jeottesen/e3d-big-box-manual-rebuild/README.md

# E3D BigBox manual

A copy of the build manual for the E3D BigBox 3D printer, recovered from the Internet Archive's Wayback Machine after the original wiki (wiki.e3d-online.com) went offline.

- **Start here:** the [BigBox Build Manual](manual/BigBox_Build_Manual.md), the manual's first page. Every page is listed in [manual/README.md](manual/README.md).
- Each page is the latest good archived version of the original wiki page. Pages the archive never saved were reconstructed from older versions of the pages that contained them.
- Some images survive only as low-resolution thumbnails, and some are lost.
- Content is by E3D Online and used under CC BY 3.0. See [NOTICE.md](NOTICE.md).

## What's here

- `manual/` – the manual as Markdown, browsable on GitHub: start at [manual/README.md](manual/README.md)
- `docs/` – the manual as HTML (open `docs/index.html` locally)
- `scripts/` – how it was recovered and built; see [scripts/README.md](scripts/README.md)
- `notes/` – what the archive doesn't have, and which snapshot each page and image came from
