jeottesen/e3d-big-box-manual-rebuild/data/README.md

# Reviewed sheet data

One JSON file per sheet of the BigBox exploded drawings: the parts list a person has checked. **This is the source of truth** for the Printed Parts and Fixings lists on the Bill of Materials page. The build (`scripts/build.py`) reads these files and nothing the tools propose.

The extraction tools (`scripts/drawings.py`, `scripts/drawing_images.py`, `scripts/match_sheets.py`; `mise run propose`) never write here. They write proposals to `work/proposed/` (git-ignored). `scripts/drift.py` (`mise run drift`) compares the proposals with these files and prints every difference. A change is accepted on purpose, with `python3 -I scripts/drift.py --accept ID [--confirm NAME]`. Accepting merges the proposal into the sheet and never throws away what a person added (a row's `how`, `read_as`, `approx` and `basis`, and the rows entered by hand); `confirmed` is cleared when a row changes.

## Files

- `sheets/pdf-NN.json` – page NN of `docs/files/EXPLODED_DRAWINGS.pdf`, read from the PDF's text (exact).
- `sheets/img-NAME.json` – a sheet that exists only as an image on the wiki (not in the PDF), read by OCR and checked by a person.
- `bom.ods` – E3D's own Bill of Materials spreadsheet (from `bom.zip` on the BigBox Thingiverse page, CC BY-SA 3.0, see `NOTICE.md`). Its Fixings sheet is the list of the fixings kit, by bag, with the quantity required and supplied; `scripts/bom_ods.py` reads it and the build merges it with the fixings the drawings show. It is not a sheet and nothing reads it but the build.

## Fields

| Field | Meaning |
| --- | --- |
| `id` | The file name without `.json`. |
| `title` | The sheet's title. |
| `source` | Where the rows came from. `kind` is `pdf` (with `file`, `sha256` of the PDF, and `page`) or `image` (with `file`, `sha256` of the original image, and `image_sheet` as `[n, of]` in the wiki's newer revision). |
| `images` | The drawing images that show this sheet, each with a `role`: `wiki` (as the wiki has it), `redrawn` (low resolution, replaced by a drawing of the PDF sheet), `enlarged` (low resolution, no PDF sheet, made twice the size), `lost` (the wiki's image was not archived; drawn from the PDF sheet), or `drawn` (the wiki never showed this sheet as an image; drawn from the PDF sheet so the Exploded Drawings page has it). |
| `rows` | The parts list. Each row has `item`, `qty` (a whole number), `part`, `description` (the bag or box, or `Printed Part`), and `how`. |
| `confirmed` | `null`, or `{"by", "on"}`: a person has checked the sheet against the drawing. Rows read by OCR are not used by the build until the sheet is confirmed. |
| `notes` | Free text. |

`how` says how a row got its text: `pdf-text` (exact), `ocr` (as the OCR read it), `ocr+fix` (corrected by a rule; these never change a number), `hand` (corrected by a person), or `entered` (typed by a person where the drawing has no parts list, with a `basis` saying what it rests on). A corrected row keeps `read_as`, what the tool read, and an OCR row keeps its `confidence`. `"approx": true` marks a quantity the manual gives as approximate; the page shows it as `~150`. A sheet made only of entered rows is not the tools' to propose, so `drift.py` does not report it as missing.

## Build sections

The build section a part links to is not stored here. It comes from where the manual shows the sheet's drawing (`embedded_sections` in `scripts/sections.py`), because the manual is the source of truth for which step a drawing belongs to.

## Printed parts the manual names that no drawing covers

These are not stored here. The manual itself names printed parts in its step lists, such as `2 x Drive Supports (Printed Parts).` `scripts/manual_parts.py` finds them in the manual at build time. The ones a drawing also shows are matched, by name, to the row of the drawing in `MANUAL_PART_NAMES` in `scripts/targets.py`; the Bill of Materials shows the drawing's name for those, with the quantity the manual's step uses. Every other one is added to the Printed Parts table, marked `no drawing` and linked to the step that lists it (a part listed in two steps is one row that links both). A test fails if the manual has such an item the tool cannot read, or if a name in the table is no longer in the manual. The tool can only find items written in the manual's list format, with `(Printed Part…)` after the name.
