jeottesen/e3d-big-box-manual-rebuild/notes/MISSING.md

# What the Wayback Machine does not have

## Pages with no archived copy of their own

Their text was rebuilt from older versions of the pages that used to contain them (or, where noted, found under a later URL).

- Dual_X-Carriage: rebuilt from BigBox_Parts_Preparation 20160807071206 (18 lines)
- Non-Titan_Idler_Arms: rebuilt from BigBox_Parts_Preparation 20160807071206 (9 lines)
- Single_&_Dual_Direct-Drive_IR_Sensor_Bracket: rebuilt from BigBox_Parts_Preparation 20160807071206 (6 lines)
- Single_Direct-Drive_Extruder: found as a real page under a later URL form (capture 20191220164342)
- Single_Direct-Drive_X-Carriage: rebuilt from Printer_main_assemblies:_Step_By_Step_Assembly_Process 20160729070751 (23 lines)
- Dual_Direct-Drive_X-Carriage: rebuilt from Printer_main_assemblies:_Step_By_Step_Assembly_Process 20160729070751 (30 lines)
- Mesh_Levelling_the_Non-Hybrid_Dual: rebuilt from Printer_Commissioning 20160811132429 (29 lines)
- Non-Hybrid_Dual_Calibrating_Z_Offset: rebuilt from Printer_Commissioning 20160811132429 (47 lines)

## Pages with no captures under either wiki URL form

- Non-Titan_Idler_Arms
- Dual_X-Carriage
- Single_&_Dual_Direct-Drive_IR_Sensor_Bracket
- Single_Direct-Drive_X-Carriage
- Dual_Direct-Drive_X-Carriage
- Non-Hybrid_Dual_Calibrating_Z_Offset
- Mesh_Levelling_the_Non-Hybrid_Dual

## Pages left out because no capture is a real article

Stub pages such as "Coming Soon!".

- BigBox_Troubleshooting

## Images with no archived copy (206 files)

The manual shows a placeholder with the original file name for each.

- 1.1_Filament_idler_assembled.jpg (seen in: BigBox_Parts_Preparation)
- Arduino_include_library.png (seen in: BigBox_Firmware_Flashing_Guide)
- Assembled_print_fan.jpeg (seen in: BigBox_Parts_Preparation, Print_Cooling_Fan)
- Bedlevelling_home.jpg (seen in: Printer_Commissioning)
- Bedlevelling_last.jpg (seen in: Printer_Commissioning)
- Bedlevelling_lcd_adj.jpg (seen in: Printer_Commissioning)
- Bedlevelling_next.jpg (seen in: Printer_Commissioning)
- Bedlevelling_next_adj.jpg (seen in: Printer_Commissioning)
- Bedlevelling_paper.jpg (seen in: Printer_Commissioning)
- Bedlevelling_paper_next.jpg (seen in: Printer_Commissioning)
- Bedlevelling_start.jpg (seen in: Printer_Commissioning)
- Bedlevelling_store.jpg (seen in: Printer_Commissioning)
- Benchy_finished.jpg (seen in: Your_First_Print)
- Bigbox_reboot.jpg (seen in: BigBox_OctoPrint_Upgrade)
- Bigbox_reload.jpg (seen in: BigBox_OctoPrint_Upgrade)
- Bigbox_update.jpg (seen in: BigBox_OctoPrint_Upgrade)
- Both_v6_pushed_in.jpg (seen in: Dual_Direct-Drive_Printhead_Assembly)
- Braided.jpg (seen in: Single_Direct-Drive_Printhead_Assembly)
- Braided_tie.jpg (seen in: Single_Direct-Drive_Printhead_Assembly)
- Braided_tied.jpg (seen in: Single_Direct-Drive_Printhead_Assembly)
- Braided_ties.jpg (seen in: Single_Direct-Drive_Printhead_Assembly)
- Browser.jpg (seen in: BigBox_OctoPrint_Upgrade)
- Cable_loop.jpg (seen in: Single_Direct-Drive_Printhead_Assembly)
- Display_autohomed_dual.jpg (seen in: Printer_Commissioning)
- Display_disable.jpg (seen in: Printer_Commissioning)
- Drop_dual_bed.jpg (seen in: Printer_Commissioning)
- Drop_dual_bed_belt.jpg (seen in: Printer_Commissioning)
- Dual_bed_up.jpg (seen in: Printer_Commissioning)
- Dual_boot.jpg (seen in: Dual_Extruders, Printer_Commissioning)
- Dual_cable_bunch_r.jpg (seen in: Dual_Direct-Drive_Printhead_Assembly)
- Dual_cable_bunch_r_shrink.jpg (seen in: Dual_Direct-Drive_Printhead_Assembly)
- Dual_cable_bunch_r_sleeve.jpg (seen in: Dual_Direct-Drive_Printhead_Assembly)
- Dual_cable_bunch_r_tape.jpg (seen in: Dual_Direct-Drive_Printhead_Assembly)
- Dual_cable_bunch_r_tied.jpg (seen in: Dual_Direct-Drive_Printhead_Assembly)
- Dual_cable_bunches.jpg (seen in: Dual_Direct-Drive_Printhead_Assembly)
- Dual_extru_fan.jpg (seen in: Dual_Direct-Drive_Printhead_Assembly)
- Dual_extru_fan_thread.jpg (seen in: Dual_Direct-Drive_Printhead_Assembly, Single_Direct-Drive_Printhead_Assembly)
- Dual_extru_fans.jpg (seen in: Dual_Direct-Drive_Printhead_Assembly)
- Dual_extru_fit.jpg (seen in: Dual_Direct-Drive_Printhead_Assembly)
- Dual_head_ir_scrwe.jpg (seen in: Dual_Extruders, Printer_Commissioning)
- Dual_head_move.jpg (seen in: Dual_Extruders, Printer_Commissioning)
- Dual_head_move_ir.jpg (seen in: Dual_Extruders, Printer_Commissioning)
- Dual_ir_cable.jpg (seen in: Dual_Direct-Drive_Printhead_Assembly)
- Dual_ir_cable_plugged.jpg (seen in: Dual_Direct-Drive_Printhead_Assembly)
- Dual_motor_cable.jpg (seen in: Dual_Direct-Drive_Printhead_Assembly)
- Dual_motor_cable_tie.jpg (seen in: Dual_Direct-Drive_Printhead_Assembly)
- Dual_motor_endstop.jpg (seen in: Dual_Direct-Drive_Printhead_Assembly)
- Dual_motor_endstop_bend.jpg (seen in: Dual_Direct-Drive_Printhead_Assembly)
- Dual_motor_endstop_fit.jpg (seen in: Dual_Direct-Drive_Printhead_Assembly)
- Dual_motor_endstop_screws.jpg (seen in: Dual_Direct-Drive_Printhead_Assembly)
- Dual_move_1mm.jpg (seen in: Printer_Commissioning)
- Dual_move_axis.jpg (seen in: Printer_Commissioning)
- Dual_move_z.jpg (seen in: Printer_Commissioning)
- Dual_other_motor_cable_tie.jpg (seen in: Dual_Direct-Drive_Printhead_Assembly)
- Dual_powered.jpg (seen in: Dual_Extruders, Printer_Commissioning)
- Dual_spine_cable_adjust.jpg (seen in: Dual_Direct-Drive_Printhead_Assembly)
- Dual_spine_cable_hole.jpg (seen in: Dual_Direct-Drive_Printhead_Assembly)
- Dual_spine_cable_tied_done.jpg (seen in: Dual_Direct-Drive_Printhead_Assembly)
- Dual_spine_feed_ptfe.jpg (seen in: Dual_Direct-Drive_Printhead_Assembly)
- Dual_spine_feed_ptfes.jpg (seen in: Dual_Direct-Drive_Printhead_Assembly)
- Dual_spine_ptfe.jpg (seen in: Dual_Direct-Drive_Printhead_Assembly)
- Dual_spine_ptfe_cut.jpg (seen in: Dual_Direct-Drive_Printhead_Assembly)
- Dual_spine_ptfe_measure.jpg (seen in: Dual_Direct-Drive_Printhead_Assembly)
- Dual_spine_ream.jpg (seen in: Dual_Direct-Drive_Printhead_Assembly)
- Dual_spine_ring.jpg (seen in: Dual_Direct-Drive_Printhead_Assembly)
- Dual_spine_y_motor.jpg (seen in: Dual_Direct-Drive_Printhead_Assembly)
- Dual_x_carriage_0.jpg (seen in: BigBox_Parts_Preparation)
- Dual_x_carriage_0_fitted.jpg (seen in: BigBox_Parts_Preparation)
- Dual_x_carriage_completed.jpg (seen in: BigBox_Parts_Preparation)
- Dual_x_carriage_corners.jpg (seen in: BigBox_Parts_Preparation)
- Dual_x_carriage_grubs.jpg (seen in: BigBox_Parts_Preparation)
- Dual_x_carriage_hotend.jpg (seen in: BigBox_Parts_Preparation)
- EXTRUDER_IDLER.jpg (seen in: BigBox_Parts_Preparation)
- Endstop.jpg (seen in: Single_Direct-Drive_Printhead_Assembly)
- Endstop_bend_black.jpg (seen in: Single_Direct-Drive_Printhead_Assembly)
- Endstop_bend_yellow.jpg (seen in: Single_Direct-Drive_Printhead_Assembly)
- Endstop_cut.jpg (seen in: Single_Direct-Drive_Printhead_Assembly)
- Endstop_fitted.jpg (seen in: Single_Direct-Drive_Printhead_Assembly)
- Extruder_cable.jpg (seen in: Single_Direct-Drive_Printhead_Assembly)
- Fan_cable.jpg (seen in: Single_Direct-Drive_Printhead_Assembly)
- Filament_idler_assembled.jpg (seen in: BigBox_Parts_Preparation)
- Fit_v6.jpg (seen in: Dual_Direct-Drive_Printhead_Assembly)
- Fitted_v6.jpg (seen in: Dual_Direct-Drive_Printhead_Assembly)
- Grub_v6_back.jpg (seen in: Dual_Direct-Drive_Printhead_Assembly)
- Grub_v6_front.jpg (seen in: Dual_Direct-Drive_Printhead_Assembly)
- Grub_v6_match.jpg (seen in: Dual_Direct-Drive_Printhead_Assembly)
- HexUploader_file_selection.png (seen in: BigBox_Firmware_Flashing_Guide)
- HexUploader_finished.png (seen in: BigBox_Firmware_Flashing_Guide)
- HexUploader_setup.png (seen in: BigBox_Firmware_Flashing_Guide)
- HexUploader_writing.png (seen in: BigBox_Firmware_Flashing_Guide)
- Hotend_fan_on.jpg (seen in: Single_Direct-Drive_Printhead_Assembly)
- Hotend_heater.jpg (seen in: Single_Direct-Drive_Printhead_Assembly)
- Hotend_heater_bent.jpg (seen in: Single_Direct-Drive_Printhead_Assembly)
- Hotend_heater_grouped.jpg (seen in: Single_Direct-Drive_Printhead_Assembly)
- Hotend_heater_tied.jpg (seen in: Single_Direct-Drive_Printhead_Assembly)
- Hotend_insert.jpg (seen in: Single_Direct-Drive_Printhead_Assembly)
- Hotend_inserted.jpg (seen in: Single_Direct-Drive_Printhead_Assembly)
- Hotend_m4.jpg (seen in: Single_Direct-Drive_Printhead_Assembly)
- Hotend_pt100.jpg (seen in: Single_Direct-Drive_Printhead_Assembly)
- Hotend_tied.jpg (seen in: Single_Direct-Drive_Printhead_Assembly)
- Hotend_ties.jpg (seen in: Single_Direct-Drive_Printhead_Assembly)
- Hotend_wiring.jpg (seen in: Dual_Direct-Drive_Printhead_Assembly)
- Hotends_fan_on.jpg (seen in: Dual_Direct-Drive_Printhead_Assembly)
- IR_SENSOR_ASSEMBLY.jpg (seen in: BigBox_Parts_Preparation)
- IR_sensor_cable.jpg (seen in: Single_Direct-Drive_Printhead_Assembly)
- Insert_network.jpg (seen in: BigBox_OctoPrint_Upgrade)
- Insert_sd.jpg (seen in: BigBox_OctoPrint_Upgrade)
- Ir_cable.jpg (seen in: Single_Direct-Drive_Printhead_Assembly)
- Ir_sensor_assembled.jpg (seen in: BigBox_Parts_Preparation)
- Ir_tighten_dual.jpg (seen in: Printer_Commissioning)
- Logged_in.jpg (seen in: BigBox_OctoPrint_Upgrade)
- Move_to_centre.jpg (seen in: Printer_Commissioning)
- OctoPrint_BigBox_Firmware.png (seen in: BigBox_Firmware_Flashing_Guide)
- OctoPrint_FirmwareUpdater.png (seen in: BigBox_Firmware_Flashing_Guide)
- OctoPrint_FirmwareUpdater_configuration.png (seen in: BigBox_Firmware_Flashing_Guide)
- OctoPrint_FirmwareUpdater_flash_firmware.png (seen in: BigBox_Firmware_Flashing_Guide)
- OctoPrint_Plugin_Manager_dialog.png (seen in: BigBox_Firmware_Flashing_Guide)
- OctoPrint_install_BigBox_Firmware_plugin.png (seen in: BigBox_Firmware_Flashing_Guide)
- OctoPrint_install_FirmwareUpdater_plugin.png (seen in: BigBox_Firmware_Flashing_Guide)
- Octoprint_write.jpg (seen in: BigBox_OctoPrint_Upgrade)
- Octoprint_writing.jpg (seen in: BigBox_OctoPrint_Upgrade)
- Oictoprint_download.jpg (seen in: BigBox_OctoPrint_Upgrade)
- Oictoprint_website.jpg (seen in: BigBox_OctoPrint_Upgrade)
- PRINT-HEAD_(DUAL).jpg (seen in: Dual_Direct-Drive_Printhead_Assembly)
- PRINT-HEAD_(SINGLE).jpg (seen in: Single_Direct-Drive_Printhead_Assembly)
- PRINT_FAN_DUCT.jpg (seen in: BigBox_Parts_Preparation, Print_Cooling_Fan)
- Plugins.jpg (seen in: BigBox_OctoPrint_Upgrade)
- Plugins_by_date.jpg (seen in: BigBox_OctoPrint_Upgrade)
- Plugins_done.jpg (seen in: BigBox_OctoPrint_Upgrade)
- Plugins_eeprom.jpg (seen in: BigBox_OctoPrint_Upgrade)
- Plugins_installing.jpg (seen in: BigBox_OctoPrint_Upgrade)
- Plugins_paste.jpg (seen in: BigBox_OctoPrint_Upgrade)
- Print-Head_Assembly_1.JPG (seen in: Single_Direct-Drive_Printhead_Assembly)
- Print-Head_Assembly_2.JPG (seen in: Single_Direct-Drive_Printhead_Assembly)
- Print-Head_Assembly_3.JPG (seen in: Single_Direct-Drive_Printhead_Assembly)
- Print-Head_Assembly_4.JPG (seen in: Single_Direct-Drive_Printhead_Assembly)
- Print-Head_Assembly_5.JPG (seen in: Single_Direct-Drive_Printhead_Assembly)
- Print-Head_Assembly_6.JPG (seen in: Single_Direct-Drive_Printhead_Assembly)
- Print-Head_Assembly_7.JPG (seen in: Single_Direct-Drive_Printhead_Assembly)
- Print-Head_Assembly_8.JPG (seen in: Single_Direct-Drive_Printhead_Assembly)
- Printer_appearance.jpg (seen in: BigBox_OctoPrint_Upgrade)
- Printer_connect.jpg (seen in: BigBox_OctoPrint_Upgrade)
- Printer_control.jpg (seen in: BigBox_OctoPrint_Upgrade)
- Printer_online.jpg (seen in: BigBox_OctoPrint_Upgrade)
- Printer_profile.jpg (seen in: BigBox_OctoPrint_Upgrade)
- Printer_scripts.jpg (seen in: BigBox_OctoPrint_Upgrade)
- Printhead_ties.jpg (seen in: Single_Direct-Drive_Printhead_Assembly)
- Printing_print.jpg (seen in: BigBox_OctoPrint_Upgrade)
- Printing_temperature.jpg (seen in: BigBox_OctoPrint_Upgrade)
- Printing_terminal.jpg (seen in: BigBox_OctoPrint_Upgrade)
- Printing_timelapse.jpg (seen in: BigBox_OctoPrint_Upgrade)
- Ptfe_cut.jpg (seen in: Single_Direct-Drive_Printhead_Assembly)
- Ptfe_cut_66.jpg (seen in: Dual_Direct-Drive_Printhead_Assembly)
- Ptfe_feed.jpg (seen in: Single_Direct-Drive_Printhead_Assembly)
- Ptfe_hole.jpg (seen in: Single_Direct-Drive_Printhead_Assembly)
- Ptfe_insert.jpg (seen in: Single_Direct-Drive_Printhead_Assembly)
- Ptfe_tube_cut.jpg (seen in: Single_Direct-Drive_Printhead_Assembly)
- Push_sd.jpg (seen in: BigBox_OctoPrint_Upgrade)
- Putty_advanced.jpg (seen in: BigBox_OctoPrint_Upgrade)
- Putty_alert.jpg (seen in: BigBox_OctoPrint_Upgrade)
- Putty_config.jpg (seen in: BigBox_OctoPrint_Upgrade)
- Putty_download.jpg (seen in: BigBox_OctoPrint_Upgrade)
- Putty_expand.jpg (seen in: BigBox_OctoPrint_Upgrade)
- Putty_login.jpg (seen in: BigBox_OctoPrint_Upgrade)
- Putty_open.jpg (seen in: BigBox_OctoPrint_Upgrade)
- Putty_raspi_config.jpg (seen in: BigBox_OctoPrint_Upgrade)
- Putty_reboot.jpg (seen in: BigBox_OctoPrint_Upgrade)
- Reboot.jpg (seen in: BigBox_OctoPrint_Upgrade)
- Right_bunch.jpg (seen in: Single_Direct-Drive_Printhead_Assembly)
- Right_feed.jpg (seen in: Single_Direct-Drive_Printhead_Assembly)
- Right_heatsink.jpg (seen in: Single_Direct-Drive_Printhead_Assembly)
- Right_heatsink_both.jpg (seen in: Single_Direct-Drive_Printhead_Assembly)
- Right_taped.jpg (seen in: Single_Direct-Drive_Printhead_Assembly)
- Scrap_belt.jpg (seen in: Printer_Commissioning)
- Scrap_belt_bed.jpg (seen in: Printer_Commissioning)
- Serial_connection.jpg (seen in: BigBox_OctoPrint_Upgrade)
- Single_correct.jpg (seen in: BigBox_Parts_Preparation, Pro_&_Lite_X-Carriage)
- Single_incorrect.jpg (seen in: BigBox_Parts_Preparation, Pro_&_Lite_X-Carriage)
- Single_x_carriage.jpg (seen in: BigBox_Parts_Preparation, Pro_&_Lite_X-Carriage)
- Spine_cable_hole.jpg (seen in: Single_Direct-Drive_Printhead_Assembly)
- Spine_cable_slack.jpg (seen in: Single_Direct-Drive_Printhead_Assembly)
- Spine_cable_strut.jpg (seen in: Single_Direct-Drive_Printhead_Assembly)
- Spine_cable_tied.jpg (seen in: Single_Direct-Drive_Printhead_Assembly)
- Spine_cable_ties.jpg (seen in: Single_Direct-Drive_Printhead_Assembly)
- Spine_cable_tight.jpg (seen in: Single_Direct-Drive_Printhead_Assembly)
- Spine_ties.jpg (seen in: Single_Direct-Drive_Printhead_Assembly)
- Tied_cable.jpg (seen in: Single_Direct-Drive_Printhead_Assembly)
- Twist_tr8.jpg (seen in: Printer_Commissioning)
- Two_v6.jpg (seen in: Dual_Direct-Drive_Printhead_Assembly)
- Undo_screws.jpg (seen in: Printer_Commissioning)
- V6_cables.jpg (seen in: Dual_Direct-Drive_Printhead_Assembly)
- V6_wires.jpg (seen in: Dual_Direct-Drive_Printhead_Assembly)
- V6_wires_cable.jpg (seen in: Dual_Direct-Drive_Printhead_Assembly)
- V6_wires_up.jpg (seen in: Dual_Direct-Drive_Printhead_Assembly)
- Windows_Device_Manager_connected_RUMBA.png (seen in: BigBox_Firmware_Flashing_Guide)
- Windows_RUMBA_Drivers_extracted.png (seen in: BigBox_Firmware_Flashing_Guide)
- Windows_RUMBA_Drivers_installation_1.png (seen in: BigBox_Firmware_Flashing_Guide)
- Windows_RUMBA_Drivers_installation_2.png (seen in: BigBox_Firmware_Flashing_Guide)
- Windows_XLoader.png (seen in: BigBox_Firmware_Flashing_Guide)
- Windows_XLoader_finished.png (seen in: BigBox_Firmware_Flashing_Guide)
- Windows_XLoader_setup.png (seen in: BigBox_Firmware_Flashing_Guide)
- Windows_XLoader_uploading.png (seen in: BigBox_Firmware_Flashing_Guide)
- X-CARRIAGE_DUAL.JPG (seen in: BigBox_Parts_Preparation)
- X-CARRIAGE_SINGLE.jpg (seen in: BigBox_Parts_Preparation, Pro_&_Lite_X-Carriage)
- Y_motor_cable.jpg (seen in: Single_Direct-Drive_Printhead_Assembly)
- Y_motor_cable_fit.jpg (seen in: Single_Direct-Drive_Printhead_Assembly)

## Image totals

- 901 distinct images: 206 missing, 22 original, 673 thumb
