jeottesen/e3d-big-box-manual-rebuild/notes/external-links.md

# External links

Every external link in the manual, with the result of testing it. Generated by `scripts/check_links.py`; a link marked dead is labelled "(dead link)" in the manual.

3 blocked, 23 dead, 78 ok, 15 unknown, 18 untested (137 links).

| Status | Link | Text | Pages |
| --- | --- | --- | --- |
| dead | `https://dl.dropboxusercontent.com/u/54348751/BigBoxSingle-alpha-settings.fff` | `https://dl.dropboxusercontent.com/u/54348751/BigBoxSingle-alpha-settin` | Older Version Content |
| dead | `https://dl.dropboxusercontent.com/u/54348751/BigBox_Fixings.pdf` | `https://dl.dropboxusercontent.com/u/54348751/BigBox_Fixings.pdf` | Bill Of Materials |
| dead | `https://dl.dropboxusercontent.com/u/54348751/BigBox_Slic3r_config_bundle.ini` | BigBox_Slic3r_config_bundle.ini | Older Version Content, BigBox Software |
| dead | `https://docs.google.com/document/d/1zl_MQIf-aFD4pc7TauehwL7SaKXNig-ABx_l33cSCJA/edit` | Livi's BigBox Pre-Build Guide | BigBox Build Manual |
| dead | `https://drive.google.com/file/d/0B8NaxduLlxIQSEhSdnUzV2FodGs/view?usp=sharing` | Liam's Printed Parts Check-List | BigBox Build Manual |
| dead ([archived copy](https://web.archive.org/web/20160902222958/http://e3d-online.com:80/All-Filament&filter=5,24)) | `http://e3d-online.com/All-Filament&filter=5,24` | Everyday & Premium Filament | Your First Print |
| dead ([archived copy](https://web.archive.org/web/20161105152053/http://e3d-online.com/All-Filament&filter=5,24,11)) | `http://e3d-online.com/All-Filament&filter=5,24,11` | E3D's Everyday PLA | Older Version Content |
| ok | `http://e3d-online.com/index.php?route=product/product&product_id=356` | Ceramic Screwdriver | Printer main assemblies Step By Step Assembly Process |
| ok | `https://en.wikipedia.org/wiki/Flexible_flat_cable` | FFC | Printer main assemblies Step By Step Assembly Process |
| ok | `https://en.wikipedia.org/wiki/Mains_electricity_by_country` | mains A/C power supply in your country | BigBox Printer Sub-assemblies, Printer main assemblies Step By Step Assembly Process |
| ok | `https://en.wikipedia.org/wiki/Secure_Shell` | SSH | BigBox OctoPrint Upgrade |
| ok | `https://en.wikipedia.org/wiki/Zero_insertion_force` | ZIF | Printer main assemblies Step By Step Assembly Process |
| dead ([archived copy](https://web.archive.org/web/20161102033305/http://files.e3d-online.com/BigBox/SD_Card/)) | `http://files.e3d-online.com/BigBox/SD_Card/` | `http://files.e3d-online.com/BigBox/SD_Card/` | Your First Print |
| dead ([archived copy](https://web.archive.org/web/20160531182702/http://files.e3d-online.com/BigBox/Slicer%20Configs/Simplify3D/bigbox_dual.fff)) | `http://files.e3d-online.com/BigBox/Slicer%20Configs/Simplify3D/bigbox_dual.fff` | Dual.fff | Older Version Content |
| dead ([archived copy](https://web.archive.org/web/20160831005324/http://files.e3d-online.com/BigBox/Slicer%20Configs/Simplify3D/bigbox_dual_experimental.fff)) | `http://files.e3d-online.com/BigBox/Slicer%20Configs/Simplify3D/bigbox_dual_experimental.fff` | Dual Experimental.fff | Older Version Content |
| dead ([archived copy](https://web.archive.org/web/20160831005447/http://files.e3d-online.com/BigBox/Slicer%20Configs/Simplify3D/bigbox_pro.fff)) | `http://files.e3d-online.com/BigBox/Slicer%20Configs/Simplify3D/bigbox_pro.fff` | Pro.fff | Older Version Content |
| dead | `http://files.e3d-online.com/Titan/ASM_EX_THUMB_SCREW.stl` | Model of Assembled Titan in STL format | Titan Assembly |
| dead ([archived copy](https://web.archive.org/web/20170910104341/http://files.e3d-online.com/Titan/ASM_EX_THUMB_SCREW.stp)) | `http://files.e3d-online.com/Titan/ASM_EX_THUMB_SCREW.stp` | Model of Assembled Titan in STP format | Titan Assembly |
| dead | `http://files.e3d-online.com/Titan/BRACKET_PRINTED.pdf` | Mounting Bracket Engineering Drawing | Titan Assembly |
| dead ([archived copy](https://web.archive.org/web/20160527143731/http://files.e3d-online.com/Titan/Titan_Assembly_Supplementary.pdf)) | `http://files.e3d-online.com/Titan/Titan%20Assembly%20Supplementary.pdf` | Supplementary Assembly Drawings / Notes | Titan Assembly |
| dead | `http://forum.bigbox-3d.com` | BigBox forum | BigBox Build Manual |
| dead ([archived copy](https://web.archive.org/web/20240324165937/https://forum.e3d-online.com/)) | `http://forum.e3d-online.com/` | forum.e3d-online.com | BigBox Pre-Build, BigBox Printer Sub-assemblies |
| dead ([archived copy](https://web.archive.org/web/20160622040336/http://forum.e3d-online.com/index.php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)) | `http://forum.e3d-online.com/index.php?forums/guides-mods-and-upgrades.26/` | BigBox Forum \| Guides, Mods, and Upgrades | BigBox Build Manual |
| dead | `http://forum.e3d-online.com/index.php?threads/how-to-attach-a-bb-dual-to-the-rumba-board.599/#post-4300` | Pro Wiring connections | Printer main assemblies Step By Step Assembly Process |
| dead | `http://forum.e3d-online.com/index.php?threads/y-axis-belts-belt-appears-to-be-fitted-upside-down.732` | forum.e3d-online.com | Printer main assemblies Step By Step Assembly Process |
| dead ([archived copy](https://web.archive.org/web/20240324165937/https://forum.e3d-online.com/)) | `https://forum.e3d-online.com` | forum.e3d-online.com | Dual Extruders, Printer Commissioning |
| dead | `https://forum.e3d-online.com/index.php?threads/shaos-bigbox-dual-build-log.685/` | Shao's BigBox Dual Build Log | BigBox Build Manual |
| dead | `https://forum.e3d-online.com/index.php?threads/using-platformio-to-flash-firmware-from-rpi.720/` | Using platformio to flash firmware from RPi | BigBox Build Manual |
| ok | `https://github.com/Alex9779` | Alex9779 | BigBox Firmware Flashing Guide |
| ok | `https://github.com/Alex9779/BigBox-Settings/blob/master/BigBoxBedAssembly.stl` | BigBoxBedAssembly.stl | Downloads |
| ok | `https://github.com/Alex9779/BigBox-Settings/blob/master/Dual%20Titan/Simplify3D/BigBox%20Dual%20Titan.fff` | BigBox Dual Titan.fff | Downloads |
| ok | `https://github.com/Alex9779/BigBox-Settings/blob/master/Dual/Simplify3D/BigBox%20Dual.fff` | BigBox Dual.fff | Downloads |
| ok | `https://github.com/Alex9779/BigBox-Settings/blob/master/Hybrid-Dual/Simplify3D/BigBox%20Hybrid-Dual%20Mirrored.fff` | BigBox Hybrid-Dual Mirrored.fff | Downloads |
| ok | `https://github.com/Alex9779/BigBox-Settings/blob/master/Hybrid-Dual/Simplify3D/BigBox%20Hybrid-Dual.fff` | BigBox Hybrid-Dual.fff | Downloads |
| ok | `https://github.com/Alex9779/BigBox-Settings/blob/master/Hybrid-Pro/Simplify3D/BigBox%20Hybrid-Pro.fff` | BigBox Hybrid-Pro.fff | Downloads |
| ok | `https://github.com/Alex9779/BigBox-Settings/blob/master/Pro/Simplify3D/BigBox%20Pro.fff` | BigBox Pro.fff | Downloads |
| ok | `https://github.com/Alex9779/BigBox-Settings/blob/master/README.md` | BigBox-Settings: README | Downloads |
| ok | `https://github.com/Alex9779/Marlin` | `https://github.com/Alex9779/Marlin` | BigBox Firmware Flashing Guide |
| ok | `https://github.com/BigBox3D` | github.com/BigBox3D | BigBox Software |
| ok | `https://github.com/BigBox3D/` | BigBox3D Github repository | BigBox Firmware Flashing Guide |
| ok | `https://github.com/BigBox3D/Firmware/blob/master/README.md` | Firmware README | Downloads |
| ok | `https://github.com/BigBox3D/Firmware/blob/master/marlin_direct_dual.hex` | marlin_direct_dual.hex | Downloads |
| ok | `https://github.com/BigBox3D/Firmware/blob/master/marlin_direct_pro.hex` | marlin_direct_pro.hex | Downloads |
| ok | `https://github.com/BigBox3D/Firmware/blob/master/marlin_hybrid_dual.hex` | marlin_hybrid_dual.hex | Downloads |
| ok | `https://github.com/BigBox3D/Firmware/blob/master/marlin_hybrid_dual_mesh.hex` | marlin_hybrid_dual_mesh.hex | Downloads |
| ok | `https://github.com/BigBox3D/Firmware/blob/master/marlin_hybrid_pro.hex` | marlin_hybrid_pro.hex | Downloads |
| ok | `https://github.com/BigBox3D/Firmware/blob/master/marlin_hybrid_pro_mesh.hex` | marlin_hybrid_pro_mesh.hex | Downloads |
| ok | `https://github.com/BigBox3D/Marlin` | BigBox Marlin source | Downloads |
| ok | `https://github.com/BigBox3D/Marlin/releases` | BigBox Firmware Releases | BigBox Firmware Flashing Guide, BigBox Software |
| ok | `https://github.com/BigBox3D/Marlin/releases/download/1.1.0-RC6/Marlin.Dual.hex` | Download firmware | BigBox Version Overview |
| ok | `https://github.com/BigBox3D/Marlin/releases/download/1.1.0-RC6/Marlin.Hybrid-Dual.hex` | Download firmware | BigBox Version Overview |
| ok | `https://github.com/BigBox3D/Marlin/releases/download/1.1.0-RC6/Marlin.Hybrid-Pro.hex` | Download firmware | BigBox Version Overview |
| ok | `https://github.com/BigBox3D/Marlin/releases/download/1.1.0-RC6/Marlin.Pro.hex` | Download firmware | BigBox Version Overview |
| ok | `https://github.com/BigBox3D/Marlin/tree/Dual` | Firmware source repository | BigBox Version Overview |
| ok | `https://github.com/BigBox3D/Marlin/tree/Hybrid-Dual` | Firmware source repository | BigBox Version Overview |
| ok | `https://github.com/BigBox3D/Marlin/tree/Hybrid-Pro` | Firmware source repository | BigBox Version Overview |
| ok | `https://github.com/BigBox3D/Marlin/tree/Pro` | Firmware source repository | BigBox Version Overview |
| ok | `https://github.com/BigBox3D/SD-Card/blob/master/3DBenchy.stl` | 3DBenchy.stl | Downloads |
| ok | `https://github.com/BigBox3D/SD-Card/blob/master/Dual/3DBenchy.gcode` | Dual/3DBenchy.gcode | Downloads |
| ok | `https://github.com/BigBox3D/SD-Card/blob/master/Dual/calibration/extruder_0.gcode` | Dual/calibration/extruder_0.gcode | Downloads |
| ok | `https://github.com/BigBox3D/SD-Card/blob/master/Dual/calibration/extruder_1.gcode` | Dual/calibration/extruder_1.gcode | Downloads |
| ok | `https://github.com/BigBox3D/SD-Card/blob/master/Pro/3DBenchy.gcode` | Pro/3DBenchy.gcode | Downloads |
| ok | `https://github.com/BigBox3D/SD-Card/blob/master/Pro/calibration/extruder_0.gcode` | Pro/calibration/extruder_0.gcode | Downloads |
| ok | `https://github.com/BigBox3D/Simplify3D` | Settings repository for Simplify3D | BigBox Software |
| ok | `https://github.com/BigBox3D/Simplify3D/blob/master/BigBox%20Dual.fff` | BigBox Dual.fff | Downloads |
| ok | `https://github.com/BigBox3D/Simplify3D/blob/master/BigBox%20Hybrid-Dual.fff` | BigBox Hybrid-Dual.fff | Downloads |
| ok | `https://github.com/BigBox3D/Simplify3D/blob/master/BigBox%20Hybrid-Pro.fff` | BigBox Hybrid-Pro.fff | Downloads |
| ok | `https://github.com/BigBox3D/Simplify3D/blob/master/BigBox%20Print%20Farm.fff` | BigBox Print Farm.fff | Downloads |
| ok | `https://github.com/BigBox3D/Simplify3D/blob/master/BigBox%20Pro.fff` | BigBox Pro.fff | Downloads |
| ok | `https://github.com/MarlinFirmware/Marlin/wiki/Manual-bed-leveling---mesh-bed-leveling` | Mesh Bed Levelling | Mesh Levelling the Non-Hybrid Dual |
| ok | `https://github.com/OctoPrint/OctoPrint-FirmwareUpdater` | `https://github.com/OctoPrint/OctoPrint-FirmwareUpdater` | BigBox Firmware Flashing Guide |
| ok | `https://github.com/OctoPrint/OctoPrint-FirmwareUpdater/archive/master.zip` | `https://github.com/OctoPrint/OctoPrint-FirmwareUpdater/archive/master.` | BigBox Firmware Flashing Guide |
| ok | `https://github.com/tohara` | tohara | BigBox Firmware Flashing Guide |
| ok | `https://github.com/tohara/OctoPrint-BigBoxFirmware` | `https://github.com/tohara/OctoPrint-BigBoxFirmware` | BigBox Firmware Flashing Guide |
| ok | `https://github.com/tohara/OctoPrint-BigBoxFirmware/archive/master.zip` | `https://github.com/tohara/OctoPrint-BigBoxFirmware/archive/master.zip` | BigBox Firmware Flashing Guide |
| ok | `http://octoprint.org/` | octoprint.org | BigBox OctoPrint Upgrade, BigBox Software |
| unknown | `http://paulkaplan.me/HexUploader/` | HexUploader | BigBox Firmware Flashing Guide |
| ok | `http://plugins.octoprint.org/plugins/autoselect/` | Autoselect | BigBox OctoPrint Upgrade |
| ok | `http://plugins.octoprint.org/plugins/displayz/` | DisplayZ | BigBox OctoPrint Upgrade |
| ok | `http://plugins.octoprint.org/plugins/stats/` | Printer Statistics | BigBox OctoPrint Upgrade |
| blocked | `https://plus.google.com/+JohnEsc/posts/9tea8wS1qoa` | John's 3D Build & Printing Tools | BigBox Build Manual |
| blocked | `https://plus.google.com/101981424292504602513/posts/AxB4jxjbyMM` | this post on google+ | BigBox Printer Sub-assemblies |
| ok | `http://reprap.org/wiki/G-code#M218:_Set_Hotend_Offset` | reprap.org | Printer Commissioning |
| ok | `http://reprap.org/wiki/Marlin` | `http://reprap.org/wiki/Marlin` | BigBox OctoPrint Upgrade |
| ok | `http://reprap.org/wiki/RUMBA#RUMBA_USB_Driver_for_Windows` | `http://reprap.org/wiki/RUMBA#RUMBA_USB_Driver_for_Windows` | BigBox Firmware Flashing Guide |
| ok | `http://reprap.org/wiki/RUMBA#USB_connection_.28Writing_in_progress.29` | here | BigBox Firmware Flashing Guide |
| unknown | `http://russemotto.com/xloader/XLoader.zip` | XLoader | BigBox Firmware Flashing Guide |
| ok | `http://slic3r.org/` | Slic3r | Older Version Content, BigBox Software |
| unknown | `http://thelittlebox.co/theshop/index.php?route=product/product&path=66_77&product_id=107` | Multimeter | Printer main assemblies Step By Step Assembly Process |
| untested | `https://web.archive.org/web/20160109071827/http://files.e3d-online.com/BigBox/EXPLODED_DRAWINGS.pdf` | EXPLODED_DRAWINGS.pdf | Downloads |
| untested | `https://web.archive.org/web/20160422181925/http://files.e3d-online.com/BigBox/Slicer%20Configs/Slic3r/BigBox_Slic3r_config_bundle.ini` | BigBox_Slic3r_config_bundle.ini | Downloads |
| untested | `https://web.archive.org/web/20160519152959/http://files.e3d-online.com/BigBox/Slicer%20Configs/Cura/BigBox_Cura_0.25.ini` | BigBox_Cura_0.25.ini | Downloads |
| untested | `https://web.archive.org/web/20160519153237/http://files.e3d-online.com/BigBox/Slicer%20Configs/Cura/BigBox_Cura_0.10.ini` | BigBox_Cura_0.10.ini | Downloads |
| untested | `https://web.archive.org/web/20160519153242/http://files.e3d-online.com/BigBox/Slicer%20Configs/Cura/BigBox_Cura_0.20.ini` | BigBox_Cura_0.20.ini | Downloads |
| untested | `https://web.archive.org/web/20160527143731/http://files.e3d-online.com/Titan/Titan_Assembly_Supplementary.pdf` | Titan_Assembly_Supplementary.pdf | Downloads, Titan Assembly |
| untested | `https://web.archive.org/web/20160531182702/http://files.e3d-online.com/BigBox/Slicer%20Configs/Simplify3D/bigbox_dual.fff` | archived copy | Older Version Content, Downloads |
| untested | `https://web.archive.org/web/20160622040336/http://forum.e3d-online.com/index.php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` | archived copy | BigBox Build Manual |
| untested | `https://web.archive.org/web/20160831005209/http://files.e3d-online.com/BigBox/Slicer%20Configs/Simplify3D/bigbox_1.1.fff` | bigbox_1.1.fff | Downloads |
| untested | `https://web.archive.org/web/20160831005324/http://files.e3d-online.com/BigBox/Slicer%20Configs/Simplify3D/bigbox_dual_experimental.fff` | archived copy | Older Version Content, Downloads |
| untested | `https://web.archive.org/web/20160831005447/http://files.e3d-online.com/BigBox/Slicer%20Configs/Simplify3D/bigbox_pro.fff` | archived copy | Older Version Content, Downloads |
| untested | `https://web.archive.org/web/20160831005610/http://files.e3d-online.com/BigBox/Slicer%20Configs/Simplify3D/bigbox_hybrid.fff` | bigbox_hybrid.fff | Downloads |
| untested | `https://web.archive.org/web/20160902222958/http://e3d-online.com:80/All-Filament&filter=5,24` | archived copy | Your First Print |
| untested | `https://web.archive.org/web/20161102033305/http://files.e3d-online.com/BigBox/SD_Card/` | archived copy | Your First Print |
| untested | `https://web.archive.org/web/20161105152053/http://e3d-online.com/All-Filament&filter=5,24,11` | archived copy | Older Version Content |
| untested | `https://web.archive.org/web/20170910104341/http://files.e3d-online.com/Titan/ASM_EX_THUMB_SCREW.stp` | ASM_EX_THUMB_SCREW.stp | Downloads, Titan Assembly |
| untested | `https://web.archive.org/web/20171114074932/http://files.e3d-online.com/Titan/ASM_EX_AERO_285.stl` | ASM_EX_AERO_285.stl | Downloads |
| untested | `https://web.archive.org/web/20240324165937/https://forum.e3d-online.com/` | archived copy | BigBox Pre-Build, BigBox Printer Sub-assemblies, Dual Extruders, Printer Commissioning |
| ok | `http://www.3dbenchy.com/` | #3DBenchy | Your First Print |
| ok | `http://www.7-zip.org/` | 7zip | BigBox OctoPrint Upgrade |
| ok | `https://www.arduino.cc/en/Main/Software` | `https://www.arduino.cc/en/Main/Software` | BigBox Firmware Flashing Guide |
| ok | `http://www.chiark.greenend.org.uk/~sgtatham/putty/download.html` | Download | BigBox OctoPrint Upgrade |
| ok | `https://www.dropbox.com/s/zlaknl7vw509144/BigBox%20Updated%20Pictures.zip?dl=0` | Livi's MLP Edition Exploded Diagrams | BigBox Build Manual |
| ok | `http://www.instructables.com/id/Picture-The-3D-Printed-Raspberry-Pi-Camera/` | Picture | BigBox Build Manual |
| ok | `http://www.linuxfoundation.org/` | Linux | BigBox OctoPrint Upgrade |
| ok | `https://www.raspberrypi.org/` | Raspberry Pi | BigBox Software |
| blocked | `https://www.raspberrypi.org/documentation/installation/installing-images/README.md` | installing images | BigBox OctoPrint Upgrade |
| ok | `https://www.simplify3d.com/` | Simplify3D | Older Version Content, BigBox Software |
| ok | `http://www.thingiverse.com/thing:1472259` | customisable spacer | Titan Assembly |
| ok | `http://www.thingiverse.com/thing:1477900` | E3D Titan Bracket | Titan Assembly |
| ok | `http://www.thingiverse.com/thing:1515488` | `http://www.thingiverse.com/thing:1515488` | BigBox Version Overview |
| ok | `http://www.thingiverse.com/thing:1521722` | `http://www.thingiverse.com/thing:1521722` | BigBox Version Overview |
| ok | `https://www.thingiverse.com/thing:1272287` | Thingiverse | BigBox Printer Sub-assemblies |
| ok | `https://www.thingiverse.com/thing:1387197` | Handled Drills (Hole Reamers) | BigBox Build Manual |
| ok | `https://www.thingiverse.com/thing:1521722` | `https://www.thingiverse.com/thing:1521722` | BigBox Build Manual |
| ok | `https://www.thingiverse.com/thing:1686515` | Dual Extruder Alignment Tool | Printer Commissioning |
| unknown | `https://www.youtube.com/watch?v=Xjmj0j0pcRM` | `https://www.youtube.com/watch?v=Xjmj0j0pcRM` | Printer main assemblies Step By Step Assembly Process |
| unknown | `https://youtu.be/0RpnXo2UQ0Y` | `https://youtu.be/0RpnXo2UQ0Y` | Printer Commissioning |
| unknown | `https://youtu.be/1v27cCMtCCI` | `https://youtu.be/1v27cCMtCCI` | Printer Commissioning |
| unknown | `https://youtu.be/2_GjLWiQV_I` | `https://youtu.be/2_GjLWiQV_I` | Printer Commissioning |
| unknown | `https://youtu.be/5X6I6plC3d8` | `https://youtu.be/5X6I6plC3d8` | Printer Commissioning |
| unknown | `https://youtu.be/8A-qU3_-mCk` | `https://youtu.be/8A-qU3_-mCk` | Printer Commissioning |
| unknown | `https://youtu.be/DBDXf6ysArk` | `https://youtu.be/DBDXf6ysArk` | Non-Hybrid Dual Calibrating Z Offset |
| unknown | `https://youtu.be/Is6ddMdZ63E` | `https://youtu.be/Is6ddMdZ63E` | Printer Commissioning |
| unknown | `https://youtu.be/PvswubV-zas` | `https://youtu.be/PvswubV-zas` | Printer Commissioning |
| unknown | `https://youtu.be/dtdeFrBScJQ` | `https://youtu.be/dtdeFrBScJQ` | Printer Commissioning |
| unknown | `https://youtu.be/hDD1arof7YM` | `https://youtu.be/hDD1arof7YM` | Printer Commissioning |
| unknown | `https://youtu.be/pwVBydX4xyA` | `https://youtu.be/pwVBydX4xyA` | Your First Print |
