jeottesen/e3d-big-box-manual-rebuild/notes/CLEAN_REPORT.md

# Version clean-up report

## BigBox_Build_Manual

- 10 versions: 0 error/truncated, 0 unchanged, 10 kept; latest good: 20200803120509

## BigBox_Firmware_Flashing_Guide

- 3 versions: 0 error/truncated, 0 unchanged, 3 kept; latest good: 20201204013533

## BigBox_OctoPrint_Upgrade

- 6 versions: 0 error/truncated, 0 unchanged, 6 kept; latest good: 20230529010658

## BigBox_Parts_Preparation

- 15 versions: 0 error/truncated, 0 unchanged, 15 kept; latest good: 20221201075921

## BigBox_Pre-Build

- 7 versions: 0 error/truncated, 0 unchanged, 7 kept; latest good: 20200127191907

## BigBox_Printer_Sub-assemblies

- 16 versions: 0 error/truncated, 0 unchanged, 16 kept; latest good: 20210415233707

## BigBox_Software

- 5 versions: 0 error/truncated, 0 unchanged, 5 kept; latest good: 20201204024242

## BigBox_Troubleshooting

- 4 versions: 4 error/truncated, 0 unchanged, 0 kept; latest good: None
  - removed (only 1 text lines): 20160120094158
  - removed (only 1 text lines): 20160303002115
  - removed (only 1 text lines): 20160402203544
  - removed (only 1 text lines): 20170122101834

## BigBox_Version_Overview

- 4 versions: 0 error/truncated, 0 unchanged, 4 kept; latest good: 20210128113613

## Bill_Of_Materials

- 5 versions: 0 error/truncated, 0 unchanged, 5 kept; latest good: 20210416002713

## Dual_Direct-Drive_Extruders

- 2 versions: 0 error/truncated, 0 unchanged, 2 kept; latest good: 20191215173602

## Dual_Extruders

- 3 versions: 0 error/truncated, 1 unchanged, 2 kept; latest good: 20161105151950
  - unchanged duplicate: 20161003072419

## Fixings_Errors_List

- 6 versions: 0 error/truncated, 3 unchanged, 3 kept; latest good: 20160601234734
  - unchanged duplicate: 20160228213925
  - unchanged duplicate: 20160331001841
  - unchanged duplicate: 20160531220510

## Print_Cooling_Fan

- 1 versions: 0 error/truncated, 0 unchanged, 1 kept; latest good: 20161025052640

## Printer_Commissioning

- 13 versions: 0 error/truncated, 0 unchanged, 13 kept; latest good: 20210415222724

## Pro_&_Lite_X-Carriage

- 1 versions: 0 error/truncated, 0 unchanged, 1 kept; latest good: 20160824110747

## Single_Direct-Drive_Extruder

- 1 versions: 0 error/truncated, 0 unchanged, 1 kept; latest good: 20191220164342

## Titan_Assembly

- 12 versions: 0 error/truncated, 0 unchanged, 12 kept; latest good: 20230509125052

## Your_First_Print

- 6 versions: 0 error/truncated, 0 unchanged, 6 kept; latest good: 20201204013802
