jeottesen/e3d-big-box-manual-rebuild/notes/printed-parts-step-files-handoff.md

# BigBox printed parts: handoff to the manual

Nov 2, 2026 · @Jeremy

## What the package is

The package is 72 printed parts, one STEP file each, named after the manual's bill of materials. It is at `/home/claude/workspace/assets/bigbox-printed-parts-package/`.

- `parts/` holds the 72 STEP files. Each is one solid in its own frame, moved so its bounding box sits on the origin and never rotated. Slicers open them directly.
- `manifest.json` and `parts.csv` have one row per file: BOM name, quantity, assembly, manual section, manual URL, printer line, source file, size, volume and SHA-256.
- `SHA256SUMS` checks the files (`sha256sum -c SHA256SUMS`). Every file was re-imported after writing and has the expected volume.
- The 10 unnamed parts (alternate designs and transit brackets) were dropped on review. The source assemblies are not included.

## What the manual should do

1. Store the STEP files in the manual's downloads area (suggested `downloads/printed-parts/`), keep the file names, and generate the links from `parts.csv` by script, as the repository's rules require. Do not hand-edit generated pages.
2. Add a STEP link to each printed row of the BOM table. Match on the `name` column of `parts.csv`; its `file` column is the path.
3. Do not store the source assemblies. Link to where they come from on the Downloads page. The owner keeps the originals and can fetch an assembly again if needed.
4. Only `X-AXIS CARRIAGE BEARING CLAMP` has two files: `__dual` and `__regular`. Parts that are the same left and right are one file; the BOM quantity says how many to print.
5. SPOOL-HOLDER OUTER (R) is generated by mirroring (L), which the original files hold once. Say so on the page.
6. Alternates: `Z-AXIS BASE BRACKET LOWER (4 hole)` and `UPPER (4 hole)` are the versions for the newer screw. List them under their standard parts.

## Gaps to settle

Two printed BOM rows have no file: **IEC Back Cover** and **Main Block**. And 19 files have no BOM row. Add rows for them, or list them as extras. Thirteen of them have no assembly set yet, so the manual agent has to place them.

| File name | Manual assembly | Note |
| --- | --- | --- |
| Bottom Camera Bracket | none set | |
| Top Camera Bracket | none set | |
| Camera Arm | none set | |
| Camera Mount | none set | |
| Fan Mount | none set | |
| FFC Conduits | none set | |
| Drag Anchor Bracket | none set | |
| Dump Bucket | none set | |
| Dual Dump Bucket | none set | |
| Ooze Wiper | none set | |
| Dual Ooze Wiper | none set | |
| Hybrid Ooze Wiper | none set | |
| Hybrid IR Sensor Bracket | none set | |
| SPINE-VERTICAL | Spine | The BOM has the other four Spine parts |
| SPOOL-HOLDER OUTER (R) | Spool-Holder Outer | The BOM lists only (L); (R) is its mirror |
| X-CARRIAGE DUAL | Extruder Dual | The manual has a page for it but no BOM row |
| Y-AXIS REAR (R) | Y-Axis Rear | The BOM lists only (L); (R) is its mirror |
| Z-AXIS BASE BRACKET LOWER (4 hole) | Z-Axis Base Brackets | Alternate for the newer screw |
| Z-AXIS BASE BRACKET UPPER (4 hole) | Z-Axis Base Brackets | Alternate for the newer screw |

## Licence and provenance

All 72 files come from the original E3D STEP files; no geometry from the third-party E3D model by ConnorM2009 (Thingiverse 5183700, CC BY-NC) is used. The project owner says that author relicensed their files on their end.

The manual repository is CC BY 3.0, and `NOTICE.md` requires new recovered content to be covered by it. The manual's Downloads page does not record where the five original STEP files came from. Please record their sources and licence there before publishing the parts.
