jeottesen/e3d-big-box-manual-rebuild/data/bom.ods

Sheet: General
 |  |  |  | Product Unit Qty
Category | Sub-Category | Location | Component | Lite | Pro | Dual
Electronics | Cabling | E3D Extruder Box | PT100 Single amp cable | 1 | 1 | 0
Electronics | Cabling | E3D Extruder Box | PT100 Double amp cable | 0 | 0 | 1
Electronics | PCB | E3D Extruder Box | PT100 Amp | 1 | 1 | 2
Electronics | Sensors | E3D Extruder Box | PT100 (1700mm Cable) | 1 | 1 | 2
Electronics | Cable | Electronics & wiring | Link | 1 | 1 | 1
Electronics | Cable | Electronics & wiring | PSU to Rumba | 2 | 2 | 2
Electronics | Cable | Electronics & wiring | IEC to PSU (Mains to PSU (300mm)) | 1 | 1 | 1
Electronics | Cable | Electronics & wiring | Bed Wiring Loom | 1 | 1 | 1
Electronics | Cabling | Electronics & wiring | IR Endstop Cable | 1 | 1 | 1
Electronics | IEC | Electronics & wiring | IEC Socket with Fuse | 1 | 1 | 1
Electronics | PCB | Electronics & wiring | Rumba | 1 | 1 | 1
Electronics | PCB | Electronics & wiring | A4988 | 4 | 4 | 5
Electronics | PSU | Electronics & wiring | PSU | 1 | 1 | 1
Electronics | Sensors | Electronics & wiring | IR Sensor | 1 | 1 | 1
Electronics | Sensors | Electronics & wiring | EndStops MicroSwitch (with Cable) | 2 | 2 | 2
Electronics | Print Related | Heated Bed | Heated Bed | 0 | 1 | 1
Electronics | Sensors | Heated Bed | Bed Thermistor Semitec | 0 | 1 | 1
Electronics | PCB | LCD & fans | LCD | 1 | 1 | 1
Electronics | Cable | Motor Box | Z-Motor Cable (300mm) | 1 | 1 | 1
Electronics | Cable | Motor Box | E-Motor Cable (1500mm) | 1 | 1 | 1
Electronics | Cable | Motor Box | Y-Motor Cable (1000mm) | 1 | 1 | 1
Electronics | Cable | Motor Box | X-Motor Cable (1500mm) | 1 | 1 | 1
Electronics | Cabling | Stretch Box | Panel Mount USB Extension | 1 | 1 | 1
Extrusion System | Extruder | E3D Extruder Box | Nitrile 70 O-Rings 12mm ID 17 OD | 0 | 0 | 2
Extrusion System | Extruder | E3D Extruder Box | E3D HobGoblin (5mm) (M3 x 4 Grub) | 1 | 1 | 2
Extrusion System | HotEnd | E3D Extruder Box | E3D V6 Lite (Direct, 24V, PT100 Block, No Electronics) | 1 | 0 | 0
Extrusion System | HotEnd | E3D Extruder Box | E3D V6 (Direct, 24V, PT100 Block, No Electronics) | 0 | 1 | 2
Extrusion System | HotEnd | E3D Extruder Box | Heater Cartridge | 1 | 1 | 2
Extrusion System | PTFE | E3D Extruder Box | Embedded Bowden Coupling for Plastic | 1 | 1 | 2
Extrusion System | PTFE | E3D Extruder Box | 4mm x 3mm x 1000mm PTFE Filament Guide | 1 | 1 | 2
Fans | Case | LCD & fans | 60x60x10 24v (300mm lead w/ 4mm fork ferrule) | 1 | 1 | 1
Fans | Electronics | LCD & fans | 50x50x10 24v (250mm lead w/ 0.1" connector) | 1 | 1 | 1
Fans | Print Related | LCD & fans | 40x40x20 Blower 24v (1700mm lead w/ 0.1" connector) | 1 | 1 | 2
Fans | Print Related | LCD & fans | 30x30x10 24v (1700mm lead w/ 0.1" connector) | 1 | 1 | 2
Fixings |  | Fixings Kit | BigBox Fixings Kit (See Fixings BOM for breakdown) | 1 | 1 | 1
Fixings |  | Stretch Box | BigBox M3 Nut Traps | 160 | 160 | 160
Frame | Sheet Material | Frame/Frame Kit | Laser Cut Acrylic / Plywood Frame
Frame | Sheet Material | Printed Parts | Laser Cut Cork Dampener Parts | 1 | 1 | 1
Miscellaneous | Extruder | E3D Extruder Box | Filament-Idler Spring | 1 | 1 | 2
Miscellaneous | Print Related | E3D Extruder Box | Viton A Rubber Strip (1.5 x 12) 40mm | 1 | 1 | 0
Miscellaneous | Print Related | E3D Extruder Box | Viton A Rubber Strip (1.5 x 12) 77mm | 0 | 0 | 1
Miscellaneous | PTFE | E3D Extruder Box | V6 Direct PTFE tubing (2mm x 4mm) | 1 | 1 | 2
Miscellaneous | Spool Holder | E3D Extruder Box | Spring (spool holder) | 1 | 1 | 2
Miscellaneous | Print Related | Heated Bed | Adhesive Sheet 3M 467MP | 1 | 1 | 1
Miscellaneous | Print Related | Heated Bed | Glass Bed | 1 | 1 | 1
Miscellaneous | Print Related | Heated Bed | Cork Insulation | 0 | 1 | 1
Miscellaneous | Cable Management | Motion Box | Drag Chain 400mm | 1 | 2 | 2
Miscellaneous | Print Related | Stretch Box | Glass Bed Clips | 8 | 8 | 8
Motion System | Bearings | E3D Extruder Box | 604-ZZ (4x12x4) | 1 | 1 | 2
Motion System | Bearings | Motion Box | F604 (4x12x4 Flange-13.5) | 6 | 6 | 6
Motion System | Bearings | Motion Box | 634ZZ (4x16x5) | 9 | 9 | 18
Motion System | Bearings | Motion Box | 688-ZZ (8x16x5) | 2 | 2 | 2
Motion System | Bearings | Motion Box | LM8LUU (8x45) | 8 | 8 | 8
Motion System | Belts & Pulleys | Motion Box | 66 Tooth (132mm) GT2 Loop Belt | 1 | 1 | 1
Motion System | Belts & Pulleys | Motion Box | GT2 6mm Belt (3000mm) | 1 | 1 | 1
Motion System | Belts & Pulleys | Motion Box | GT2 16T (5mm) | 1 | 1 | 1
Motion System | Belts & Pulleys | Motion Box | GT2 20T (5mm) | 1 | 1 | 1
Motion System | Belts & Pulleys | Motion Box | GT2 20T (8mm) | 2 | 2 | 2
Motion System | Belts & Pulleys | Motion Box | GT2 36T (8mm) | 1 | 1 | 1
Motion System | Leadscrews & Nuts | Motion Box | 5mm – 8mm Couplers | 2 | 2 | 2
Motion System | Leadscrews & Nuts | Motion Box | TR8 Nut (4 x M3 Mounting Holes) | 2 | 2 | 2
Motion System | Leadscrews & Nuts | Rods | TR8 Leadscrew (347mm) | 2 | 2 | 2
Motion System | Rods | Rods | SiS. 532mm (Y) | 1 | 1 | 1
Motion System | Rods | Rods | GHSiS 484mm (X) | 2 | 2 | 2
Motion System | Rods | Rods | GHSiS 384mm (Y) | 2 | 2 | 2
Motion System | Rods | Rods | GHSiS 364mm (Z) | 4 | 4 | 4
Motion System | Rods | Rods | SiS 325mm (S) | 2 | 2 | 4
RPI Kit | Cable | Rasberry Pi Box | Panel Mount RJ45 Socket (600mm)
RPI Kit | Cable | Rasberry Pi Box | USB A-Mini cable (~500mm)
RPI Kit | Cable | Rasberry Pi Box | Short uUSB cable
RPI Kit | Cable | Rasberry Pi Box | Rumba to DCDC Power In (300mm lead. 0.1” - Tinned)
RPI Kit | PCB | Rasberry Pi Box | Raspberry Pi 2 + 8gb
RPI Kit | PCB | Rasberry Pi Box | Camera & 750mm FFC Cable
RPI Kit | PCB | Rasberry Pi Box | 5v DC DC Converter
Stepper Motors | Stepper Motors | Motor Box | 46nm NEMA 17 (400 Steps) (Wantai 42BYGHM809L20P4.5-17-X2) | 3 | 3 | 4
Stepper Motors | Stepper Motors | Motor Box | 40nm NEMA 17 (200 Steps) (Wantai 42BYGHW609L20P1-X2) | 2 | 2 | 2

Sheet: Fixings
Bag Number | Description | Qty Required | Qty Supplied
1 | 20mm x 40mm 2:1 Heatshrink Black | 8 | 9 | Note: | A number of fixings kits contained errors. In the case of errors, a supplimentary bag of fixings was supplied in the "stretch box" or within the fixings kit. For more information, please see: http://wiki.e3d-online.com/wiki/BigBox_Fixings_Errors_List.
1 | 2.5mm x 100mm Cable Tie | 26 | 29
1 | 20mm ID x1500mm Braided Cable Sleeve | 2 | 3
1 | 20mm ID x 800mm Braided Cable Sleeve | 2 | 3
1 | 3.1mm OD x ~5mm OD x 5mm Nylon Standoff | 18 | 20
1 | 3.1mm OD x ~8mm OD x 5mm Nylon Standoff | 4 | 5
1 | M3 x 18-20 Standoff | 4 | 5
2 | M3 x 8 Countersunk Rec Platite 30 Screws BZP | 6 | 7
2 | M2 Microbarb Nuts Brass | 4 | 5
3 | M2 A2 S/S Half Nuts | 4 | 5
3 | M2 x 12 Socket Cap Screws | 8 | 9
4 | M2 x 8 Socket Cap Screws | 2 | 3
4 | M2.5 MicroBarb | 4 | 5
4 | M2.5 Square Nut | 2 | 3
4 | M2.5 x 12 Socket Cap Screws | 4 | 5
5 | M2.5 x 6 Socket Cap Screws | 2 | 3
5 | M3 Hex Nut Half | 107 | 118
5 | M3 Microbarb Nuts Brass | 29 | 32
6 | M3 Ext Lock Washer A2 S/S | 77 | 85
6 | M3 Square Nuts A2 S/S | 207 | 228
7 | M3 Washers A BZP | 10 | 11
7 | M3 x 6 Skt Cap Screws | 8 | 9
7 | M3 x 25 Skt Cap Screws | 13 | 15
8 | M3 x 10 Skt Cap Screws | 62 | 69
8 | M3 x 18 Skt Cap Screws | 156 | 172
9 | M3 x 12 Skt Cap Screws | 63 | 70
9 | M3 x 20 Skt Cap Screws | 38 | 42
10 | M3 x 30 Skt Cap Screws | 4 | 5
10 | M3 x 16 Skt Cap Screws | 26 | 29
11 | M3 x 35 Skt Cap Screws | 21 | 24
11 | M3 x 22 Skt Cap Screws | 2 | 3
11 | M4 Hex Nut Half | 24 | 27
12 | M4 Ext Lock Washer | 14 | 16
12 | M4 Square Nuts | 34 | 38
13 | M4 Washer | 35 | 39
13 | M4 x 8 Skt Grub Screws Flat Point | 6 | 7
13 | M4 x 20 Skt Grub Screws Flat Point | 2 | 3
14 | M4 x 12 Skt Grub Screws Flat Point | 6 | 7
14 | M4 x 16 Skt Cap Screws | 32 | 36
15 | M4 x 25 Skt Cap Screws | 2 | 3
15 | M3 Nylock Nut | 4 | 5
15 | M3 x 8 Skt Cap Screws | 2 | 3
16 | Nylon Washer - 8mm ID x 18mm OD x 1.6-1.8mm T | 2 | 3
16 | Nylon Spacer - 3-3.2mm ID x 6mm OD x 15 L | 2 | 3
16 | Brass Standoff - Female Female M3 x 15 Full Thread | 4 | 5
17 | M4 x 20 Skt Cap Screws | 17 | 19
17 | M4 x 30 Skt Cap Screws | 5 | 6
17 | M3 x 3 Skt Grub Screws Knruled Point | 2 | 3
