jeottesen/e3d-big-box-manual-rebuild/downloads/printed-parts/parts.csv

file | name | in_bom | bom_qty | bom_printer | bom_drawing | assembly | section | manual_url | printer_line | variant | notes | source_file | source_part | dims_mm | volume_mm3 | license | renamed_in_package | verified_reimport | sha256
parts/BB-FRAME-M3-NUT-TRAP-1.step | BB_FRAME_M3_NUT_TRAP-1 | True | ~150 |  | FRAME-LUG_DRAWING.jpg | Frame-Lug Drawing | (13.1) A Note on Nut-Traps | https://github.com/jeottesen/e3d-big-box-manual-rebuild/blob/main/manual/BigBox_Printer_Sub-assemblies.md |  |  |  | BB_FRAME_M3_NUT_TRAP.stp | BB_FRAME_M3_NUT_TRAP/g000 | 11.0 x 8.1 x 7.6 | 353 | CC BY-SA 3.0 | False | True | a371f3552f8ac2a917ddadea19b06e5629b5b404430a606cc22ba27669481897
parts/Bottom-Camera-Bracket.step | Bottom Camera Bracket | False |  |  |  |  | (22) OctoPrint Upgrade Camera Install | https://github.com/jeottesen/e3d-big-box-manual-rebuild/blob/main/manual/Printer_main_assemblies_Step_By_Step_Assembly_Process.md | regular |  |  | bigbox_v1.1.0.stp | bigbox_v1.1.0/g028 | 42.6 x 9.0 x 9.0 | 2051 | CC BY-SA 3.0 | False | True | dbbf3e4ed094f13fe13a1dc60dc9d1846357892782c8dc1c1850285f69d780bc
parts/Camera-Arm.step | Camera Arm | False |  |  |  |  | (22) OctoPrint Upgrade Camera Install | https://github.com/jeottesen/e3d-big-box-manual-rebuild/blob/main/manual/Printer_main_assemblies_Step_By_Step_Assembly_Process.md | regular |  |  | bigbox_v1.1.0.stp | bigbox_v1.1.0/g007 | 36.2 x 25.0 x 8.5 | 3796 | CC BY-SA 3.0 | False | True | a7e937fe31809a2b3223f996664214d9d326e01c359530806784a0ff91261e19
parts/Camera-Mount.step | Camera Mount | False |  |  |  |  | (22) OctoPrint Upgrade Camera Install | https://github.com/jeottesen/e3d-big-box-manual-rebuild/blob/main/manual/Printer_main_assemblies_Step_By_Step_Assembly_Process.md | regular |  | Camera holder | bigbox_v1.1.0.stp | bigbox_v1.1.0/g027 | 61.9 x 33.5 x 11.0 | 8160 | CC BY-SA 3.0 | False | True | 39664945ac8bf790c2497e8b66093dfa2228a06f49bcde90586c7850b1ce69ed
parts/DOCK-BRACKET.step | DOCK-BRACKET | True | 1 |  | DOCK-BRACKET.jpg | Dock-Bracket | (14) Frame Top | https://github.com/jeottesen/e3d-big-box-manual-rebuild/blob/main/manual/Printer_main_assemblies_Step_By_Step_Assembly_Process.md | regular |  |  | bigbox_v1.1.0.stp | bigbox_v1.1.0/g034 | 141.2 x 43.5 x 14.0 | 19729 | CC BY-SA 3.0 | False | True | 5f5137f0dd04ec7c66add2017b39a2aba59ef1b538611b3534513197886fc38b
parts/Drag-Anchor-Bracket.step | Drag Anchor Bracket | False |  |  |  |  | (13) X-Axis Drag Chain | https://github.com/jeottesen/e3d-big-box-manual-rebuild/blob/main/manual/Printer_main_assemblies_Step_By_Step_Assembly_Process.md | regular |  |  | bigbox_v1.1.0.stp | bigbox_v1.1.0/g023 | 31.5 x 26.0 x 14.5 | 6991 | CC BY-SA 3.0 | False | True | 947dbeebab309fae8eb48c7c4fb80e87a38c6f3595a41fe94af6b69c4ae5421d
parts/Drive-Supports.step | Drive Supports | True | 2 |  |  | Z-Axis Bed Assembly | (10) Z-Axis Bed Assembly | https://github.com/jeottesen/e3d-big-box-manual-rebuild/blob/main/manual/BigBox_Printer_Sub-assemblies.md | regular |  |  | bigbox_v1.1.0.stp | bigbox_v1.1.0/g045 | 50.5 x 35.0 x 23.2 | 13572 | CC BY-SA 3.0 | False | True | b04eff8009a04bc42cbcafa2ae2766605dc026c1ea27caf4543ad6b4bc90ac14
parts/Dual-Dump-Bucket.step | Dual Dump Bucket | False |  |  |  |  | (31) Ooze Wiper & Dump Bucket | https://github.com/jeottesen/e3d-big-box-manual-rebuild/blob/main/manual/Printer_main_assemblies_Step_By_Step_Assembly_Process.md | dual |  |  | bigbox_dual_v1.0.0.stp | bigbox_dual_v1.0.0/g004 | 78.0 x 60.7 x 50.0 | 44021 | CC BY-SA 3.0 | False | True | bddd191af1e741b3754af32d1ca612bfdc0dbc9b7a10ac488c5a55428565b2ce
parts/Dual-Ooze-Wiper.step | Dual Ooze Wiper | False |  |  |  |  | (31) Ooze Wiper & Dump Bucket | https://github.com/jeottesen/e3d-big-box-manual-rebuild/blob/main/manual/Printer_main_assemblies_Step_By_Step_Assembly_Process.md | dual |  |  | bigbox_dual_v1.0.0.stp | bigbox_dual_v1.0.0/g000 | 76.0 x 42.4 x 12.0 | 9398 | CC BY-SA 3.0 | False | True | aa0072d1b46ea1467dc4ce8a80fcc58375dac1575d723b6d8ed504607a173e0d
parts/Dump-Bucket.step | Dump Bucket | False |  |  |  |  | (31) Ooze Wiper & Dump Bucket | https://github.com/jeottesen/e3d-big-box-manual-rebuild/blob/main/manual/Printer_main_assemblies_Step_By_Step_Assembly_Process.md | regular |  |  | bigbox_v1.1.0.stp | bigbox_v1.1.0/g033 | 60.7 x 50.0 x 44.0 | 31589 | CC BY-SA 3.0 | False | True | 16da1b3946765bffb823473607dc17aa04a84c6bb756e7b2a1702078c62d98f8
parts/E-AXIS-CABLE-BRACKET-DUAL-L.step | E-AXIS CABLE BRACKET (DUAL)(L) | True | 1 | dual | EXTRUDER_DUAL.jpg | Extruder Dual | Dual Direct-Drive Extruders | https://github.com/jeottesen/e3d-big-box-manual-rebuild/blob/main/manual/Dual_Direct-Drive_Extruders.md | dual |  |  | bigbox_dual_v1.0.0.stp | bigbox_dual_v1.0.0/g002b | 74.3 x 59.0 x 27.6 | 17030 | CC BY-SA 3.0 | False | True | 7fc53b025d3587d7e0ea964df42112ef581ff61df140bf0ed6dd50276f0e9444
parts/E-AXIS-CABLE-BRACKET-DUAL-R.step | E-AXIS CABLE BRACKET (DUAL)(R) | True | 1 | dual | EXTRUDER_DUAL.jpg | Extruder Dual | Dual Direct-Drive Extruders | https://github.com/jeottesen/e3d-big-box-manual-rebuild/blob/main/manual/Dual_Direct-Drive_Extruders.md | dual |  | Right and left are the same part but mirrored | bigbox_dual_v1.0.0.stp | bigbox_dual_v1.0.0/g002 | 74.3 x 59.0 x 27.6 | 17030 | CC BY-SA 3.0 | False | True | 5de7dd90be17e3ba4e0c1458fca2143a3e5cbcbca9c324409187a5a81637422e
parts/E-AXIS-CARRIAGE-TOP-HYBRID-NON-TITAN-DIRECT-BODY.step | E-AXIS CARRIAGE TOP HYBRID NON-TITAN DIRECT BODY | True | 1 | hybrid | EXTRUDER_HYBRID_NON-TITAN_DIRECT.jpg | Extruder Hybrid Non-Titan Direct | (5) Hybrid Non-Titan Extruder (Direct) | https://github.com/jeottesen/e3d-big-box-manual-rebuild/blob/main/manual/BigBox_Printer_Sub-assemblies.md | hybrid |  | broken thumbnail | Hybrid_v1.1.0.stp | Hybrid_v1.1.0/g003 | 74.2 x 67.7 x 51.1 | 56237 | CC BY-SA 3.0 | False | True | 08b07b1ddc2648495b5b42c2a7db95434316f49f4b6902c7e879be0d4035746b
parts/E-AXIS-CARRIAGE-TOP-HYBRID-NON-TITAN-DIRECT-GUIDE.step | E-AXIS CARRIAGE TOP HYBRID NON-TITAN DIRECT GUIDE | True | 1 | hybrid | EXTRUDER_HYBRID_NON-TITAN_DIRECT.jpg | Extruder Hybrid Non-Titan Direct | (5) Hybrid Non-Titan Extruder (Direct) | https://github.com/jeottesen/e3d-big-box-manual-rebuild/blob/main/manual/BigBox_Printer_Sub-assemblies.md | hybrid |  |  | Hybrid_v1.1.0.stp | Hybrid_v1.1.0/g005 | 42.0 x 30.8 x 25.6 | 7390 | CC BY-SA 3.0 | False | True | 9927c90d32afa1c2d128b79118a46312f171a26134629e35b9ccb1350b42e302
parts/E-AXIS-CARRIAGE-TOP-HYBRID-NON-TITAN-DIRECT-LEVER.step | E-AXIS CARRIAGE TOP HYBRID NON-TITAN DIRECT LEVER | True | 1 | hybrid | EXTRUDER_HYBRID_NON-TITAN_DIRECT.jpg | Extruder Hybrid Non-Titan Direct | (5) Hybrid Non-Titan Extruder (Direct) | https://github.com/jeottesen/e3d-big-box-manual-rebuild/blob/main/manual/BigBox_Printer_Sub-assemblies.md | hybrid |  |  | Hybrid_v1.1.0.stp | Hybrid_v1.1.0/g004 | 46.3 x 25.0 x 24.0 | 8775 | CC BY-SA 3.0 | False | True | cd0e845d320655b49f21cbe6165300370868f3c1d3817c298cedeaf7644e64fa
parts/E-AXIS-CARRIAGE-TOP-HYBRID-TITAN-DIRECT.step | E-AXIS CARRIAGE TOP HYBRID TITAN DIRECT | True | 1 | hybrid | EXTRUDER_HYBRID_TITAN_DIRECT.jpg | Extruder Hybrid Non-Titan Direct | (5) Hybrid Non-Titan Extruder (Direct) | https://github.com/jeottesen/e3d-big-box-manual-rebuild/blob/main/manual/BigBox_Printer_Sub-assemblies.md | hybrid |  |  | Hybrid_v1.1.0.stp | Hybrid_v1.1.0/g000 | 71.3 x 68.3 x 51.5 | 40664 | CC BY-SA 3.0 | False | True | 67f6914424c858af7822c126ff2af4381b1eb09dd3d48720f7b5c80ae1c89053
parts/E-AXIS-IDLER.step | E-AXIS IDLER | True | 1 |  | EXTRUDER_IDLER.jpg | Extruder Idler | Non-Titan Idler Arms | https://github.com/jeottesen/e3d-big-box-manual-rebuild/blob/main/manual/Non-Titan_Idler_Arms.md | regular |  |  | bigbox_v1.1.0.stp | bigbox_v1.1.0/g021 | 46.3 x 25.0 x 14.0 | 7280 | CC BY-SA 3.0 | False | True | ca78dcabccbb71bbd088acd617f4382f326aa6a8dddcd35d8a57c3523fb8f4f6
parts/ELECTRONICS-COVER-BRACKET.step | ELECTRONICS-COVER-BRACKET | True | 4 |  | ELECTRONICS_COVER.jpg | Electronics Cover | (8) Electronics Cover | https://github.com/jeottesen/e3d-big-box-manual-rebuild/blob/main/manual/BigBox_Printer_Sub-assemblies.md | regular |  |  | bigbox_v1.1.0.stp | bigbox_v1.1.0/g008 | 31.2 x 18.5 x 5.0 | 1387 | CC BY-SA 3.0 | False | True | 139512ea725d00bd2d5954e0a1962b5f7141107229c0c13557dd782c58e9eb32
parts/EXTRUDER-BODY-DUAL.step | EXTRUDER BODY (DUAL) | True | 1 | dual | EXTRUDER_DUAL.jpg | Extruder Dual | Dual Direct-Drive Extruders | https://github.com/jeottesen/e3d-big-box-manual-rebuild/blob/main/manual/Dual_Direct-Drive_Extruders.md | dual |  |  | bigbox_dual_v1.0.0.stp | bigbox_dual_v1.0.0/g003 | 135.2 x 51.1 x 40.0 | 79801 | CC BY-SA 3.0 | False | True | 84b3a982c0e100420f096116aefdad7a34cb8d1791303beed16f2bd386f0a62f
parts/EXTRUDER-BODY-SINGLE.step | EXTRUDER BODY (SINGLE) | True | 1 | regular | EXTRUDER_SINGLE.jpg | Extruder Single | Single Direct-Drive Extruder | https://github.com/jeottesen/e3d-big-box-manual-rebuild/blob/main/manual/Single_Direct-Drive_Extruder.md | regular |  |  | bigbox_v1.1.0.stp | bigbox_v1.1.0/g019 | 88.3 x 51.1 x 40.0 | 46447 | CC BY-SA 3.0 | False | True | ceed1fadfe85dfc3ff29f610606ec7e26eb686b984e05aeffe6104e565bb210b
parts/EXTRUDER-CABLE-BRACKET.step | EXTRUDER CABLE BRACKET | True | 1 |  | EXTRUDER_SINGLE.jpg | Extruder Single | Single Direct-Drive Extruder | https://github.com/jeottesen/e3d-big-box-manual-rebuild/blob/main/manual/Single_Direct-Drive_Extruder.md | regular |  |  | bigbox_v1.1.0.stp | bigbox_v1.1.0/g020 | 76.0 x 74.3 x 27.6 | 19882 | CC BY-SA 3.0 | False | True | 3b7999c25ca01759b40ed0583c13256d14e84d924e7df6c9378fa681addda6e2
parts/Fan-Mount.step | Fan Mount | False |  |  |  |  | (13) Print Cooling Fan (v1.0) | https://github.com/jeottesen/e3d-big-box-manual-rebuild/blob/main/manual/BigBox_Parts_Preparation.md | hybrid |  |  | Hybrid_v1.1.0.stp | Hybrid_v1.1.0/g014 | 70.5 x 60.5 x 23.8 | 12960 | CC BY-SA 3.0 | False | True | de4886b80345ba89e4ae60ee3457bc4ae3a26cf683046347e3cc14770e7c95f1
parts/FFC-Conduits.step | FFC Conduits | False |  |  |  |  | (22) OctoPrint Upgrade Camera Install | https://github.com/jeottesen/e3d-big-box-manual-rebuild/blob/main/manual/Printer_main_assemblies_Step_By_Step_Assembly_Process.md | regular |  |  | bigbox_v1.1.0.stp | bigbox_v1.1.0/g011 | 30.0 x 24.4 x 4.1 | 1277 | CC BY-SA 3.0 | False | True | d03dd6535fe1f55e3ed8d198f668eb3da55c9d1b44df914aed0a512c068b1c17
parts/HEATED-BED-CORNERS.step | HEATED BED CORNERS | True | 1 |  | HEATED_BED_CORNERS.jpg | Heated Bed Corners | (10) Heated Bed Corners | https://github.com/jeottesen/e3d-big-box-manual-rebuild/blob/main/manual/BigBox_Parts_Preparation.md | regular |  |  | bigbox_v1.1.0.stp | bigbox_v1.1.0/g044 | 32.5 x 32.4 x 23.0 | 9970 | CC BY-SA 3.0 | False | True | 0c32160d4774fb6439e0248ec281025450921dde3b0b64856cb4cec577a66916
parts/Hybrid-IR-Sensor-Bracket.step | Hybrid IR Sensor Bracket | False |  |  |  |  | (16) Hybrid IR Sensor Bracket | https://github.com/jeottesen/e3d-big-box-manual-rebuild/blob/main/manual/BigBox_Parts_Preparation.md | hybrid |  |  | Hybrid_v1.1.0.stp | Hybrid_v1.1.0/g008 | 66.9 x 33.5 x 11.8 | 8766 | CC BY-SA 3.0 | False | True | 428cc5422cca92d97efc7adc92e64a4d3d1890e34202784e174d274abb2b0681
parts/Hybrid-Ooze-Wiper.step | Hybrid Ooze Wiper | False |  |  |  |  | (31) Ooze Wiper & Dump Bucket | https://github.com/jeottesen/e3d-big-box-manual-rebuild/blob/main/manual/Printer_main_assemblies_Step_By_Step_Assembly_Process.md | hybrid |  |  | Hybrid_v1.1.0.stp | Hybrid_v1.1.0/g009 | 77.0 x 50.4 x 20.8 | 14553 | CC BY-SA 3.0 | False | True | f176105abb3869ce6d1fd122388b0a70b142fbd25e5533a966f85270eb7fad96
parts/Hybrid-X-Carriage.step | Hybrid X-Carriage | True | 1 | hybrid |  |  | (9) Hybrid X-Carriage | https://github.com/jeottesen/e3d-big-box-manual-rebuild/blob/main/manual/BigBox_Parts_Preparation.md | hybrid |  |  | Hybrid_v1.1.0.stp | Hybrid_v1.1.0/g001 | 79.8 x 70.1 x 27.7 | 66265 | CC BY-SA 3.0 | False | True | 90786655a63f15147f613be2c981316f2e45d5aa9a89572ee4d6c300a7ae82d2
parts/Hybrid-X-Carriage-Front-Bearing-Clamp.step | Hybrid X-Carriage Front Bearing Clamp | True | 1 | hybrid |  |  | (8) Hybrid X-Carriage | https://github.com/jeottesen/e3d-big-box-manual-rebuild/blob/main/manual/Printer_main_assemblies_Step_By_Step_Assembly_Process.md | hybrid |  |  | Hybrid_v1.1.0.stp | Hybrid_v1.1.0/g002 | 45.0 x 32.0 x 12.2 | 7393 | CC BY-SA 3.0 | False | True | 2be7fffb7bcc0a848a91e272eaebcdd017b3db85587d06c6e31394879e1d69e7
parts/Hybrid-X-Carriage-Rear-Bearing-Clamp.step | Hybrid X-Carriage Rear Bearing Clamp | True | 1 | hybrid |  |  | (8) Hybrid X-Carriage | https://github.com/jeottesen/e3d-big-box-manual-rebuild/blob/main/manual/Printer_main_assemblies_Step_By_Step_Assembly_Process.md | hybrid |  |  | Hybrid_v1.1.0.stp | Hybrid_v1.1.0/g010 | 69.2 x 37.3 x 21.3 | 16794 | CC BY-SA 3.0 | False | True | 5ccba2679906e8e447c8638e493c05f689d494be4d7d165fb17b230e60371430
parts/IR-SENSOR-HOUSING.step | IR-SENSOR HOUSING | True | 1 |  | IR_SENSOR_ASSEMBLY.jpg | IR Sensor Assembly | Single & Dual Direct-Drive IR Sensor Bracket | https://github.com/jeottesen/e3d-big-box-manual-rebuild/blob/main/manual/Single_%26_Dual_Direct-Drive_IR_Sensor_Bracket.md | regular |  |  | bigbox_v1.1.0.stp | bigbox_v1.1.0/g031 | 33.0 x 32.6 x 20.5 | 5474 | CC BY-SA 3.0 | False | True | 3f8d7da6e755cc3441d76987de5285f781f39bf6a759f84ddd381fcf236747bc
parts/Ooze-Wiper.step | Ooze Wiper | False |  |  |  |  | (31) Ooze Wiper & Dump Bucket | https://github.com/jeottesen/e3d-big-box-manual-rebuild/blob/main/manual/Printer_main_assemblies_Step_By_Step_Assembly_Process.md | regular |  |  | bigbox_v1.1.0.stp | bigbox_v1.1.0/g030 | 42.4 x 39.0 x 12.0 | 7400 | CC BY-SA 3.0 | False | True | 297a57336c54fe8b35015487e484dd5e5226106c2a026ae947c2198b3b18c221
parts/PRINT-FAN-BRACKET.step | PRINT FAN BRACKET | True | 1 |  | PRINT_FAN_DUCT.jpg | Print Fan Duct | Print Cooling Fan | https://github.com/jeottesen/e3d-big-box-manual-rebuild/blob/main/manual/Print_Cooling_Fan.md | regular |  | Duplicate with "bigbox_v1.1.0/p064". This is the better version | bigbox_v1.1.0.stp | bigbox_v1.1.0/g035 | 54.2 x 46.0 x 23.6 | 8241 | CC BY-SA 3.0 | False | True | af893d3ab068595ad38a13f4cec90f29f5469d13735f7926bc36128288892bf4
parts/PRINT-FAN-DUCT.step | PRINT FAN DUCT | True | 1 |  | PRINT_FAN_DUCT.jpg | Print Fan Duct | Print Cooling Fan | https://github.com/jeottesen/e3d-big-box-manual-rebuild/blob/main/manual/Print_Cooling_Fan.md | regular |  | Duplicate with "bigbox_dual_v1.0.0/p011". This is the better version | bigbox_v1.1.0.stp | bigbox_v1.1.0/g037 | 54.2 x 46.0 x 23.3 | 9805 | CC BY-SA 3.0 | False | True | 8c831656623ff622acbd09ae59ee50c847c3fb72dcc5412b17b6053d0775ce41
parts/Printed-Feet.step | Printed Feet | True | 8 |  |  |  | (12.2) Feet | https://github.com/jeottesen/e3d-big-box-manual-rebuild/blob/main/manual/BigBox_Printer_Sub-assemblies.md | regular |  |  | bigbox_v1.1.0.stp | bigbox_v1.1.0/g006 | 18.0 x 18.0 x 8.0 | 1858 | CC BY-SA 3.0 | False | True | 8549683e7ba1e4a27a071888e659893c1d94c7f901bed6da3d9178bd1ae91f62
parts/RRB-CABLE-CONDUIT.step | RRB-CABLE-CONDUIT | True | 3 |  | REAR-RIGHT-BACK_CABLE_CONDUIT.jpg | Rear-Right-Back Cable Conduit | (12) X-Axis Cable Conduits | https://github.com/jeottesen/e3d-big-box-manual-rebuild/blob/main/manual/Printer_main_assemblies_Step_By_Step_Assembly_Process.md | regular |  |  | bigbox_v1.1.0.stp | bigbox_v1.1.0/g000 | 23.1 x 22.0 x 10.0 | 3150 | CC BY-SA 3.0 | False | True | 6b8b96bb37bd36d2aa941bad3bdebf166ed4162822e3a24b58cc2c3b15bd6bcc
parts/SPINE-LARGE.step | SPINE-LARGE | True | 1 |  | SPINE.jpg | Spine | (16) Cable Spine | https://github.com/jeottesen/e3d-big-box-manual-rebuild/blob/main/manual/Printer_main_assemblies_Step_By_Step_Assembly_Process.md | regular |  |  | bigbox_v1.1.0.stp | bigbox_v1.1.0/g014 | 110.0 x 57.2 x 12.0 | 22614 | CC BY-SA 3.0 | False | True | 8c1fe9a59f44471bce27e61206ba0928a98d83fe584a6ebceb551391d229454c
parts/SPINE-MED.step | SPINE-MED | True | 2 |  | SPINE.jpg | Spine | (16) Cable Spine | https://github.com/jeottesen/e3d-big-box-manual-rebuild/blob/main/manual/Printer_main_assemblies_Step_By_Step_Assembly_Process.md | regular |  |  | bigbox_v1.1.0.stp | bigbox_v1.1.0/g013 | 110.0 x 33.7 x 12.0 | 19138 | CC BY-SA 3.0 | False | True | 0e202092fe4067df9fe4dc4be016f900e8b60bf362f4b5935b0c8a58c8f1afd6
parts/SPINE-SMALL.step | SPINE-SMALL | True | 2 |  | SPINE.jpg | Spine | (16) Cable Spine | https://github.com/jeottesen/e3d-big-box-manual-rebuild/blob/main/manual/Printer_main_assemblies_Step_By_Step_Assembly_Process.md | regular |  |  | bigbox_v1.1.0.stp | bigbox_v1.1.0/g012 | 82.0 x 33.7 x 12.0 | 14650 | CC BY-SA 3.0 | False | True | 3397f4cf5fd631bc9e8fa61cf68cbff9fdb7fbfd3bbcc4e3e1137e87c84bf595
parts/SPINE-VERTICAL.step | SPINE-VERTICAL | False |  |  |  | Spine | (16) Cable Spine | https://github.com/jeottesen/e3d-big-box-manual-rebuild/blob/main/manual/Printer_main_assemblies_Step_By_Step_Assembly_Process.md | regular |  | Not in assembly | bigbox_v1.1.0.stp | bigbox_v1.1.0/g026 | 58.0 x 30.2 x 12.0 | 10511 | CC BY-SA 3.0 | False | True | dd01cf9a6f9c3f662dd661581dc2ab7fe4f7fcc7627c98148bad8ddd49fce27c
parts/SPINE-Y.step | SPINE-Y | True | 2 |  | SPINE.jpg | Spine | (16) Cable Spine | https://github.com/jeottesen/e3d-big-box-manual-rebuild/blob/main/manual/Printer_main_assemblies_Step_By_Step_Assembly_Process.md | regular |  |  | bigbox_v1.1.0.stp | bigbox_v1.1.0/g015 | 42.0 x 18.0 x 11.0 | 6224 | CC BY-SA 3.0 | False | True | 7d132f5d0eb5c236b27b77893cfb07ff79397f754ab7952e9652a64cfbdca779
parts/Spool-Inner-Brackets.step | Spool Inner Brackets | True | 2 |  |  |  | (17.2) Spool Inner Brackets | https://github.com/jeottesen/e3d-big-box-manual-rebuild/blob/main/manual/Printer_main_assemblies_Step_By_Step_Assembly_Process.md | regular |  |  | bigbox_v1.1.0.stp | bigbox_v1.1.0/g043 | 30.8 x 13.5 x 10.0 | 2942 | CC BY-SA 3.0 | False | True | 05a074da4ee0213976f252b958700c20cbd548c7fae70b430b9ee3639a254413
parts/SPOOL-HOLDER-CLAMP-INNER.step | SPOOL-HOLDER CLAMP INNER | True | 1 |  | SPOOL-HOLDER_CLAMP.jpg | Spool-Holder Clamp | (17) Spool Carrier Clamp | https://github.com/jeottesen/e3d-big-box-manual-rebuild/blob/main/manual/BigBox_Parts_Preparation.md | regular |  |  | bigbox_v1.1.0.stp | bigbox_v1.1.0/g010 | 31.0 x 15.0 x 6.5 | 1651 | CC BY-SA 3.0 | False | True | 6a7ea30a490b05e0d81cfbb9cebaef2122f4234fe254c24373b6bfd5ee0d23ab
parts/SPOOL-HOLDER-CLAMP-OUTER.step | SPOOL-HOLDER CLAMP OUTER | True | 1 |  | SPOOL-HOLDER_CLAMP.jpg | Spool-Holder Clamp | (17) Spool Carrier Clamp | https://github.com/jeottesen/e3d-big-box-manual-rebuild/blob/main/manual/BigBox_Parts_Preparation.md | regular |  |  | bigbox_v1.1.0.stp | bigbox_v1.1.0/g009 | 28.0 x 14.5 x 12.5 | 1773 | CC BY-SA 3.0 | False | True | 69f3c7cb8b8f307bc8614f26d9428f7024d7f80dead201c03e6a763733202ecb
parts/SPOOL-HOLDER-INNER.step | SPOOL-HOLDER INNER | True | 1 |  | SPOOL-HOLDER_INNER.jpg | Spool-Holder Inner | (12) Spool Holder Outer Fronts | https://github.com/jeottesen/e3d-big-box-manual-rebuild/blob/main/manual/BigBox_Parts_Preparation.md | regular |  |  | bigbox_v1.1.0.stp | bigbox_v1.1.0/g042 | 33.7 x 33.7 x 18.0 | 11153 | CC BY-SA 3.0 | False | True | d8ce9315f82dc259b7e07f611edd9d634e3fe169d697de55499a2521cc160ea6
parts/SPOOL-HOLDER-OUTER-L.step | SPOOL-HOLDER OUTER (L) | True | 1 |  | SPOOL-HOLDER_OUTER.jpg | Spool-Holder Outer | (11) Outer Spools Rear (Left & Right) | https://github.com/jeottesen/e3d-big-box-manual-rebuild/blob/main/manual/BigBox_Parts_Preparation.md | regular |  |  | bigbox_v1.1.0.stp | bigbox_v1.1.0/g018 | 40.7 x 38.5 x 22.5 | 15863 | CC BY-SA 3.0 | False | True | db331bf89f5aee4503794328479c16599463d68a3e746ee3a0ddc17472a6625c
parts/SPOOL-HOLDER-OUTER-R.step | SPOOL-HOLDER OUTER (R) | False |  |  |  | Spool-Holder Outer | (11) Outer Spools Rear (Left & Right) | https://github.com/jeottesen/e3d-big-box-manual-rebuild/blob/main/manual/BigBox_Parts_Preparation.md | regular |  | Mirror image of SPOOL-HOLDER OUTER (L) (made by mirroring that part) | bigbox_v1.1.0.stp | bigbox_v1.1.0/g018~mirror | 40.7 x 38.5 x 22.5 | 15863 | CC BY-SA 3.0 | False | True | 4cf64c63026ddee53ab0272ab0c1d68edbf375402fdb2cb7103cea24f8c4e404
parts/Top-Camera-Bracket.step | Top Camera Bracket | False |  |  |  |  | (22) OctoPrint Upgrade Camera Install | https://github.com/jeottesen/e3d-big-box-manual-rebuild/blob/main/manual/Printer_main_assemblies_Step_By_Step_Assembly_Process.md | regular |  |  | bigbox_v1.1.0.stp | bigbox_v1.1.0/g028b | 42.6 x 9.0 x 9.0 | 2051 | CC BY-SA 3.0 | False | True | 5d81aa9192897f85c4efae9049d0341eeee94b4da4d1eaa41c1b6ce70bc7bc55
parts/X-AXIS-BELT-TENSIONER.step | X-AXIS BELT-TENSIONER | True | 1 |  | X-CARRIAGE_ASSEMBLY.jpg | X-Carriage Assembly |  |  | regular |  |  | bigbox_v1.1.0.stp | bigbox_v1.1.0/g032 | 11.2 x 10.1 x 9.0 | 718 | CC BY-SA 3.0 | False | True | 60f37c4bc35a698ccc0962a81a5583872b0323ff7b13a272797fb4979bdea7c8
parts/X-AXIS-CARRIAGE-BEARING-CLAMP__dual.step | X-AXIS CARRIAGE BEARING CLAMP | True | 2 |  | X-CARRIAGE_ASSEMBLY.jpg | X-Carriage Assembly | (8) Dual X-Carriage | https://github.com/jeottesen/e3d-big-box-manual-rebuild/blob/main/manual/BigBox_Parts_Preparation.md | dual | dual |  | bigbox_dual_v1.0.0.stp | bigbox_dual_v1.0.0/g010 | 45.0 x 32.0 x 12.2 | 7427 | CC BY-SA 3.0 | False | True | 35359e8a2978ebbd26030c094f35442d5bc907298718b4f12940dfaf95a2322e
parts/X-AXIS-CARRIAGE-BEARING-CLAMP__regular.step | X-AXIS CARRIAGE BEARING CLAMP | True | 2 |  | X-CARRIAGE_ASSEMBLY.jpg | X-Carriage Assembly | (5) X-Axis Idler Carriage | https://github.com/jeottesen/e3d-big-box-manual-rebuild/blob/main/manual/BigBox_Parts_Preparation.md | regular | regular |  | bigbox_v1.1.0.stp | bigbox_v1.1.0/g022 | 34.0 x 32.0 x 12.5 | 5805 | CC BY-SA 3.0 | False | True | 18a7c7c478e06ae0c3a25a4e25fa26fb4d9322a836d41930fb4ee52e9f63d813
parts/X-AXIS-IDLER-CARRIAGE.step | X-AXIS IDLER CARRIAGE | True | 1 |  | X-AXIS_IDLER_CARRIAGE.jpg | X-Axis Idler Carriage | (5) X-Axis Idler Carriage | https://github.com/jeottesen/e3d-big-box-manual-rebuild/blob/main/manual/BigBox_Parts_Preparation.md | regular |  |  | bigbox_v1.1.0.stp | bigbox_v1.1.0/g041 | 72.3 x 50.9 x 49.2 | 68005 | CC BY-SA 3.0 | False | True | 5b978d1659aa402e33525720f62876d59652f5de33daea2a8ede80bc63e3a622
parts/X-AXIS-MOTOR-CARRIAGE.step | X-AXIS MOTOR CARRIAGE | True | 1 |  | X-AXIS_MOTOR_CARRIAGE.jpg | X-Axis Motor Carriage | (6) X-Axis Motor Mount | https://github.com/jeottesen/e3d-big-box-manual-rebuild/blob/main/manual/BigBox_Parts_Preparation.md | regular |  |  | bigbox_v1.1.0.stp | bigbox_v1.1.0/g038 | 72.3 x 69.7 x 49.1 | 71276 | CC BY-SA 3.0 | False | True | 9238f0dbd23b7051c276d07f09e38bbd7a9b8898281d6eb11c041653d6c92752
parts/X-CARRIAGE-DUAL.step | X-CARRIAGE DUAL | False |  |  |  | Extruder Dual | (8) Dual X-Carriage | https://github.com/jeottesen/e3d-big-box-manual-rebuild/blob/main/manual/BigBox_Parts_Preparation.md | dual |  | Not in the BOM yet: the manual has a Dual X-Carriage page but no BOM row for it. | bigbox_dual_v1.0.0.stp | bigbox_dual_v1.0.0/g009 | 109.5 x 79.4 x 60.6 | 95511 | CC BY-SA 3.0 | False | True | c34138199faff48968b61ceb81011d07345b51557721dcd82b24b465e6ff5bdd
parts/X-CARRIAGE-SINGLE.step | X-CARRIAGE SINGLE | True | 1 | regular | X-CARRIAGE_SINGLE.jpg | X-Carriage Single | Pro & Lite X-Carriage | https://github.com/jeottesen/e3d-big-box-manual-rebuild/blob/main/manual/Pro_%26_Lite_X-Carriage.md | regular |  | no render | bigbox_v1.1.0.stp | bigbox_v1.1.0/g036 | 79.3 x 69.5 x 60.6 | 57154 | CC BY-SA 3.0 | False | True | a1b6fe67cb8284770b743b571a56e4a7455c53bdde8e874907f3bceb8a802959
parts/Y-AXIS-BELT-TENSIONER.step | Y-AXIS BELT TENSIONER | True | 1 |  | Y-AXIS_IDLER.jpg | Y-Axis Idler | (3) Y-Axis Belt Idlers | https://github.com/jeottesen/e3d-big-box-manual-rebuild/blob/main/manual/BigBox_Parts_Preparation.md | regular |  |  | bigbox_v1.1.0.stp | bigbox_v1.1.0/g017 | 47.5 x 20.0 x 20.0 | 7621 | CC BY-SA 3.0 | False | True | e59eb457246af79426ed4072839a2dccd222045001833eb0185e7b0982d506da
parts/Y-Axis-Endstop.step | Y-Axis Endstop | True | 1 |  |  |  | (29) Y-Axis Frame Endstop | https://github.com/jeottesen/e3d-big-box-manual-rebuild/blob/main/manual/Printer_main_assemblies_Step_By_Step_Assembly_Process.md | regular |  |  | bigbox_v1.1.0.stp | bigbox_v1.1.0/g029 | 43.5 x 21.5 x 8.3 | 3896 | CC BY-SA 3.0 | False | True | f2d5617dc53a46a590b195d322ca6b327a1261ae4be2002c41595be0b8dea3c2
parts/Y-AXIS-FRONT-R.step | Y-AXIS FRONT (R) | True | 1 |  | Y-AXIS_FRONT.jpg | Y-Axis Front | (2) Y-Axis Front Brackets (Left & Right) | https://github.com/jeottesen/e3d-big-box-manual-rebuild/blob/main/manual/BigBox_Parts_Preparation.md | regular |  |  | bigbox_v1.1.0.stp | bigbox_v1.1.0/g040 | 49.0 x 29.5 x 24.0 | 21539 | CC BY-SA 3.0 | False | True | d8ca42d092c8a3411da17b478459bd8e13f1b3e0a505e148e9ad04694ca2a7e3
parts/Y-AXIS-MOTOR-MOUNT.step | Y-AXIS MOTOR MOUNT | True | 1 |  | Y-AXIS_MOTOR.jpg | Y-Axis Motor | (14) Y-Axis Motor Mount | https://github.com/jeottesen/e3d-big-box-manual-rebuild/blob/main/manual/BigBox_Parts_Preparation.md | regular |  |  | bigbox_v1.1.0.stp | bigbox_v1.1.0/g016 | 70.2 x 45.5 x 44.3 | 26624 | CC BY-SA 3.0 | False | True | 51d6c21fcca56e549aee30d59f63ebd58dd01b88c17db48701e2652be9cd1348
parts/Y-AXIS-REAR-L-R-BEARING-RETAINER.step | Y-AXIS REAR (L&R) BEARING RETAINER | True | 1 |  | Y-AXIS_REAR.jpg | Y-Axis Rear | (1) Y-Axis Rear Brackets (Left & Right) | https://github.com/jeottesen/e3d-big-box-manual-rebuild/blob/main/manual/BigBox_Parts_Preparation.md | regular |  |  | bigbox_v1.1.0.stp | bigbox_v1.1.0/g001 | 21.0 x 21.0 x 3.0 | 839 | CC BY-SA 3.0 | False | True | 5893957b069fe8d9f0e8919672d5bac52fde20c21bdd8cf33942554db3f0b18d
parts/Y-AXIS-REAR-L.step | Y-AXIS REAR (L) | True | 1 |  | Y-AXIS_REAR.jpg | Y-Axis Rear | (1) Y-Axis Rear Brackets (Left & Right) | https://github.com/jeottesen/e3d-big-box-manual-rebuild/blob/main/manual/BigBox_Parts_Preparation.md | regular |  | Y-AXIS REAR (R) Is the mirrored version of this part | bigbox_v1.1.0.stp | bigbox_v1.1.0/g039b | 53.0 x 31.0 x 28.8 | 27274 | CC BY-SA 3.0 | False | True | cd694690a090547e536b31d110c9de66c70c66241209c6994db76774ebd7d04b
parts/Y-AXIS-REAR-R.step | Y-AXIS REAR (R) | False |  |  |  | Y-Axis Rear |  | https://github.com/jeottesen/e3d-big-box-manual-rebuild/blob/main/manual/BigBox_Parts_Preparation.md | regular |  | Y-AXIS REAR (L) Is the mirrored version of this part | bigbox_v1.1.0.stp | bigbox_v1.1.0/g039 | 53.0 x 31.0 x 28.8 | 27274 | CC BY-SA 3.0 | False | True | 4bbaef8c5ca32920f9f562798f6a8b62f8948edf9e95a11d4c8418f4132f6b3a
parts/Z-AXIS-BASE-BRACKET-LOWER.step | Z-AXIS BASE BRACKET LOWER | True | 1 |  | Z-AXIS_BASE_BRACKETS.jpg | Z-Axis Base Brackets | (17.5) Z-Axis Lower Rod Brackets | https://github.com/jeottesen/e3d-big-box-manual-rebuild/blob/main/manual/Printer_main_assemblies_Step_By_Step_Assembly_Process.md | regular |  | Version for old screw | bigbox_v1.1.0.stp | bigbox_v1.1.0/g003 | 26.0 x 26.0 x 4.8 | 1720 | CC BY-SA 3.0 | False | True | 6fad9b9d23557bfca9aeabc57932e5ef805d837ca392d4de4c76f340feb952ed
parts/Z-AXIS-BASE-BRACKET-LOWER-4-hole.step | Z-AXIS BASE BRACKET LOWER (4 hole) | False |  |  |  | Z-Axis Base Brackets | (17.5) Z-Axis Lower Rod Brackets | https://github.com/jeottesen/e3d-big-box-manual-rebuild/blob/main/manual/Printer_main_assemblies_Step_By_Step_Assembly_Process.md | regular |  | Version for new screw | bigbox_v1.1.0.stp | bigbox_v1.1.0/g004 | 26.0 x 26.0 x 4.8 | 1661 | CC BY-SA 3.0 | False | True | 986e3cb4dcd3ab3572f54d91168ee054bb894cd56ddf77a49c98230089b04f47
parts/Z-AXIS-BASE-BRACKET-UPPER.step | Z-AXIS BASE BRACKET UPPER | True | 1 |  | Z-AXIS_BASE_BRACKETS.jpg | Z-Axis Base Brackets | (17.5) Z-Axis Lower Rod Brackets | https://github.com/jeottesen/e3d-big-box-manual-rebuild/blob/main/manual/Printer_main_assemblies_Step_By_Step_Assembly_Process.md | regular |  | Version for old screw | bigbox_v1.1.0.stp | bigbox_v1.1.0/g002 | 26.0 x 26.0 x 4.8 | 1466 | CC BY-SA 3.0 | False | True | 070e83b40807e586632b0245ad560d4d97fb21ce4cda0cd9ee3fd9879e3c60a5
parts/Z-AXIS-BASE-BRACKET-UPPER-4-hole.step | Z-AXIS BASE BRACKET UPPER (4 hole) | False |  |  |  | Z-Axis Base Brackets | (17.5) Z-Axis Lower Rod Brackets | https://github.com/jeottesen/e3d-big-box-manual-rebuild/blob/main/manual/Printer_main_assemblies_Step_By_Step_Assembly_Process.md | regular |  | Version for new screw | bigbox_v1.1.0.stp | bigbox_v1.1.0/g005 | 26.0 x 26.0 x 4.8 | 1407 | CC BY-SA 3.0 | False | True | 642ebc4fe0eb9e9f0b289d4714b15a90d511036ddeeda53c69a6f51d9850c4b2
parts/Z-AXIS-DRAG-CHAIN-ANCHOR-BASE.step | Z-AXIS DRAG-CHAIN ANCHOR BASE | True | 1 |  | Z-AXIS_DRAG_CHAIN.jpg | Z-Axis Drag Chain | (18) Z-Axis Drag Chain Anchors | https://github.com/jeottesen/e3d-big-box-manual-rebuild/blob/main/manual/BigBox_Parts_Preparation.md | regular |  |  | bigbox_v1.1.0.stp | bigbox_v1.1.0/g025 | 25.0 x 23.2 x 14.0 | 5077 | CC BY-SA 3.0 | False | True | f48adf8e0d9c1ae3e8c264f09a01524f7fb660f690004172d01b46ac73c6bfbd
parts/Z-AXIS-DRAG-CHAIN-ANCHOR-BED.step | Z-AXIS DRAG-CHAIN ANCHOR BED | True | 1 |  | Z-AXIS_DRAG_CHAIN.jpg | Z-Axis Drag Chain | (18) Z-Axis Drag Chain Anchors | https://github.com/jeottesen/e3d-big-box-manual-rebuild/blob/main/manual/BigBox_Parts_Preparation.md | regular |  |  | bigbox_v1.1.0.stp | bigbox_v1.1.0/g024 | 25.0 x 17.0 x 16.5 | 4773 | CC BY-SA 3.0 | False | True | 7655db5c9c44be89a3abb55f97f6529bebec410257a71a3101bd22f1bf1be36c
parts/Z-Axis-Driver-Bottoms.step | Z-Axis Driver Bottoms | True | 2 |  |  |  | (1.4) Leadscrews | https://github.com/jeottesen/e3d-big-box-manual-rebuild/blob/main/manual/Printer_Commissioning.md | regular |  |  | bigbox_v1.1.0.stp | bigbox_v1.1.0/g049 | 34.0 x 30.0 x 4.5 | 2837 | CC BY-SA 3.0 | False | True | 9c00fe5fffedf7b96464cb33a77a7b26662374893dc66b973e435603b40fbefc
parts/Z-Axis-Driver-Tops.step | Z-Axis Driver Tops | True | 2 |  |  |  | (1.4) Leadscrews | https://github.com/jeottesen/e3d-big-box-manual-rebuild/blob/main/manual/Printer_Commissioning.md | regular |  |  | bigbox_v1.1.0.stp | bigbox_v1.1.0/g050 | 34.0 x 30.0 x 5.5 | 4710 | CC BY-SA 3.0 | False | True | f610b36c724258949d3c9e9ffbf52ee02f3bb22b31af2546dfb28fadcb673225
parts/Z-AXIS-TOP-BOTTOM.step | Z-AXIS TOP BOTTOM | True | 4 |  | Z-AXIS_TOP_BRACKETS.jpg | Z-Axis Top Brackets | (32.2) Z Bed | https://github.com/jeottesen/e3d-big-box-manual-rebuild/blob/main/manual/Printer_main_assemblies_Step_By_Step_Assembly_Process.md | regular |  |  | bigbox_v1.1.0.stp | bigbox_v1.1.0/g048 | 28.0 x 27.0 x 4.5 | 2348 | CC BY-SA 3.0 | False | True | d681d972a9a4ffa2e2764672674f9656ae3d520c0b4f9c9aa0f6f2c3d8ae3d8e
parts/Z-AXIS-TOP-CAP.step | Z-AXIS TOP CAP | True | 4 |  | Z-AXIS_TOP_BRACKETS.jpg | Z-Axis Top Brackets | (32.2) Z Bed | https://github.com/jeottesen/e3d-big-box-manual-rebuild/blob/main/manual/Printer_main_assemblies_Step_By_Step_Assembly_Process.md | regular |  |  | bigbox_v1.1.0.stp | bigbox_v1.1.0/g047 | 13.0 x 12.6 x 7.5 | 568 | CC BY-SA 3.0 | False | True | 288a718a030badba35e42eed0abbe8867a0681606cb5e0ecb1cca1e8bb8a5128
parts/Z-AXIS-TOP-TOP.step | Z-AXIS TOP TOP | True | 4 |  | Z-AXIS_TOP_BRACKETS.jpg | Z-Axis Top Brackets | (32.2) Z Bed | https://github.com/jeottesen/e3d-big-box-manual-rebuild/blob/main/manual/Printer_main_assemblies_Step_By_Step_Assembly_Process.md | regular |  |  | bigbox_v1.1.0.stp | bigbox_v1.1.0/g046 | 28.0 x 27.0 x 4.5 | 2862 | CC BY-SA 3.0 | False | True | 2749bfdda349f2f847c44ba03c4f78160ecd31ab6e357cd6be82762a04178be8
