jeottesen/e3d-big-box-manual-rebuild/downloads/printed-parts/parts/X-CARRIAGE-DUAL.step

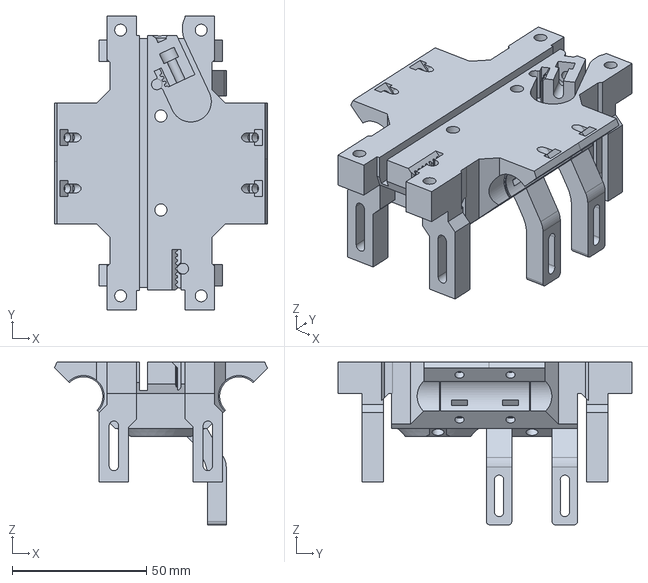
[picture p52: CAD file, 2026-11-06]
downloads/printed-parts/parts/X-CARRIAGE-DUAL.step
79.4 x 109.5 x 60.6 mm
