jeottesen/e3d-big-box-manual-rebuild/downloads/printed-parts/parts/PRINT-FAN-DUCT.step

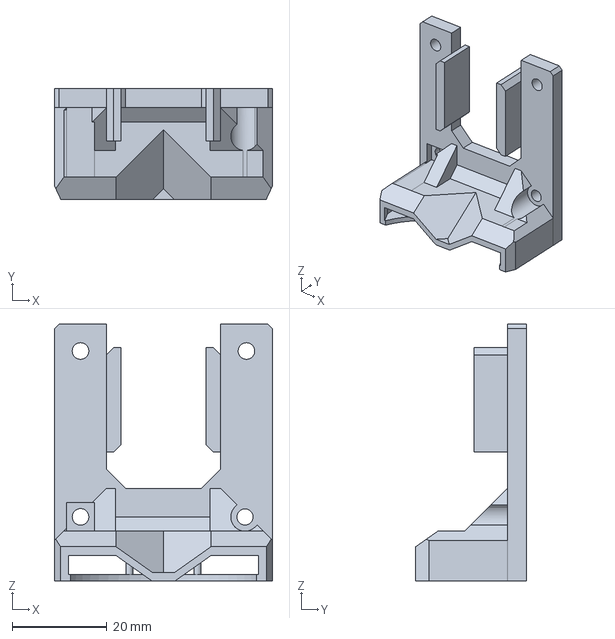
[picture p53: CAD file, 2026-11-06]
downloads/printed-parts/parts/PRINT-FAN-DUCT.step
46.0 x 23.3 x 54.2 mm
