jeottesen/e3d-big-box-manual-rebuild/downloads/printed-parts/parts/X-CARRIAGE-SINGLE.step

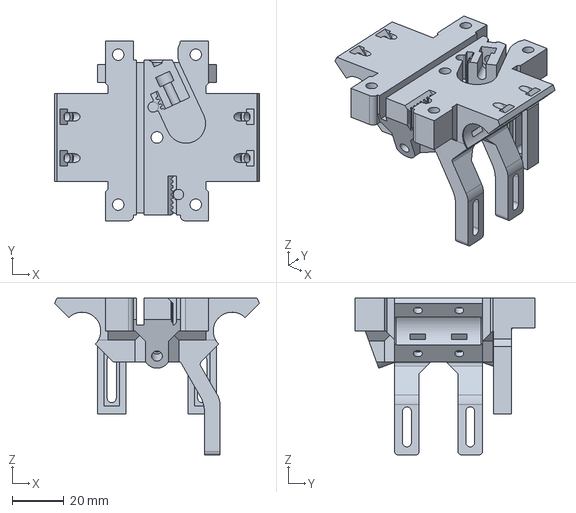
[picture p54: CAD file, 2026-11-06]
downloads/printed-parts/parts/X-CARRIAGE-SINGLE.step
79.3 x 69.5 x 60.6 mm
