jeottesen/e3d-big-box-manual-rebuild/downloads/printed-parts/parts/Z-AXIS-BASE-BRACKET-LOWER-4-hole.step

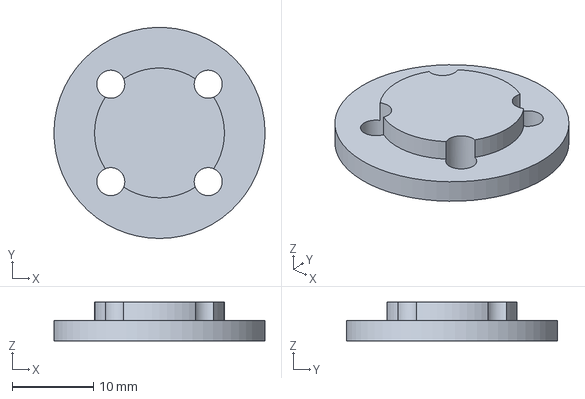
[picture p55: CAD file, 2026-11-06]
downloads/printed-parts/parts/Z-AXIS-BASE-BRACKET-LOWER-4-hole.step
26.0 x 26.0 x 4.75 mm
