jeottesen/e3d-big-box-manual-rebuild/downloads/printed-parts/parts/Camera-Arm.step

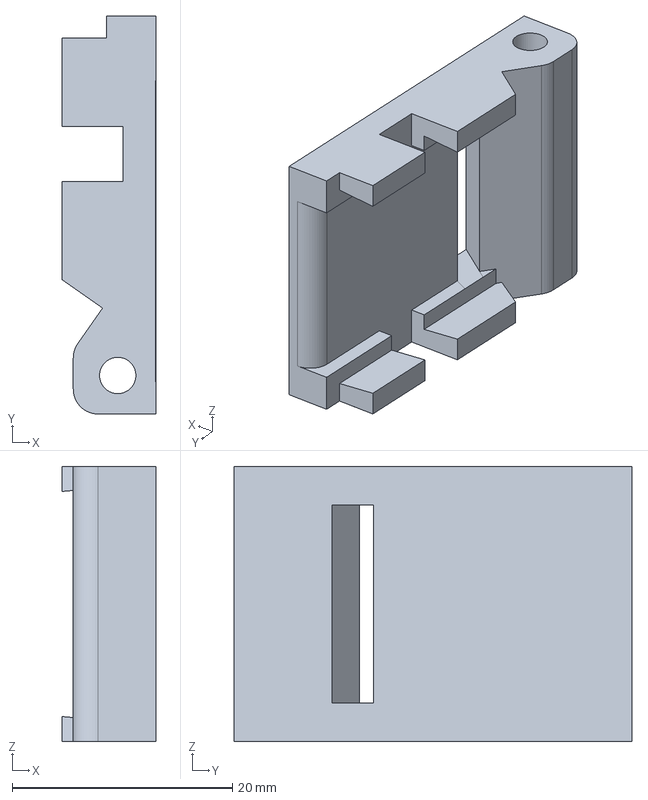
[picture p56: CAD file, 2026-11-06]
downloads/printed-parts/parts/Camera-Arm.step
8.50 x 36.2 x 25.0 mm
