jeottesen/e3d-big-box-manual-rebuild/downloads/printed-parts/parts/Hybrid-X-Carriage-Rear-Bearing-Clamp.step

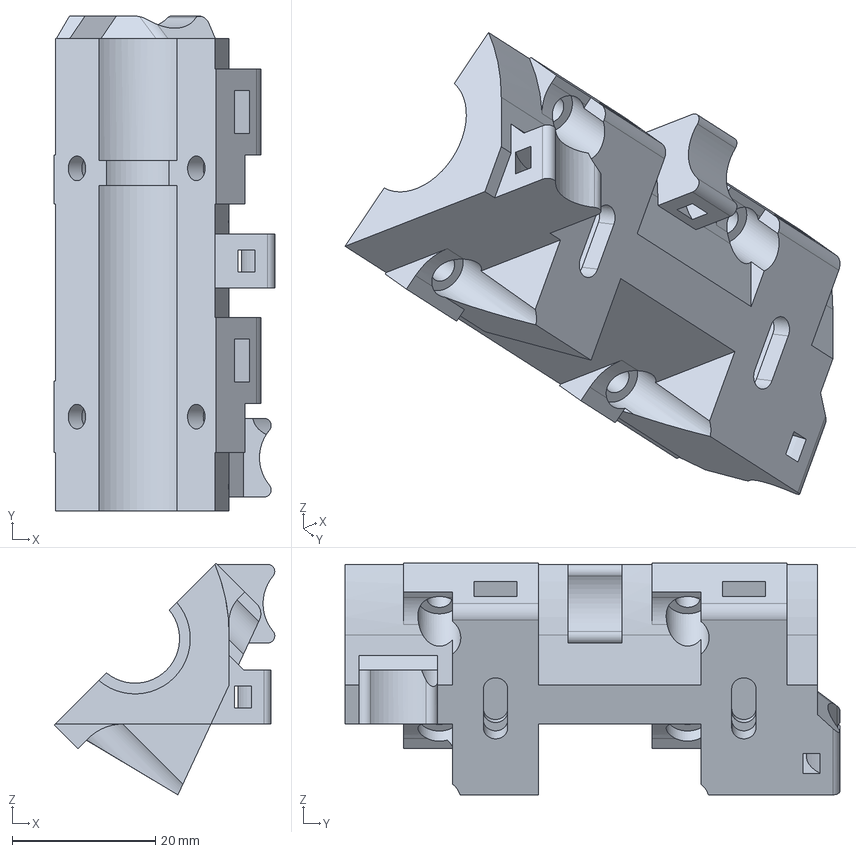
[picture p57: CAD file, 2026-11-06]
downloads/printed-parts/parts/Hybrid-X-Carriage-Rear-Bearing-Clamp.step
30.8 x 69.2 x 32.4 mm
