jeottesen/e3d-big-box-manual-rebuild/downloads/printed-parts/parts/IR-SENSOR-HOUSING.step

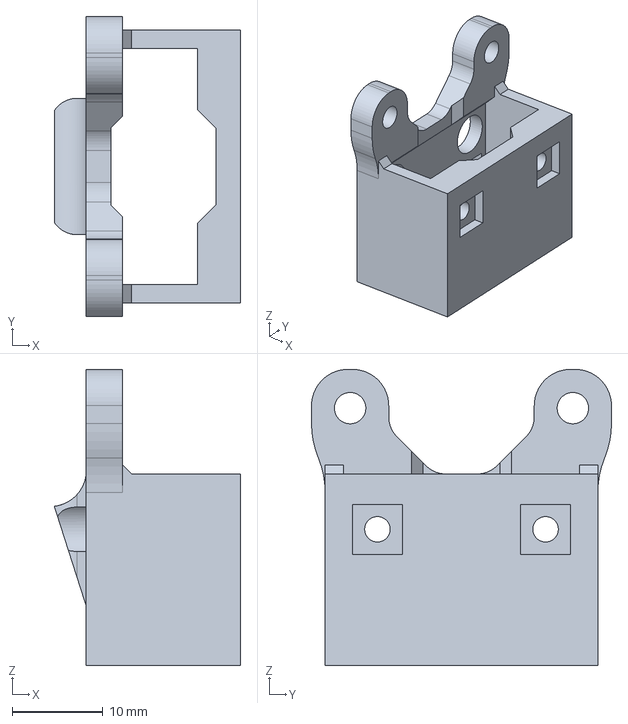
[picture p58: CAD file, 2026-11-06]
downloads/printed-parts/parts/IR-SENSOR-HOUSING.step
20.5 x 33.0 x 32.6 mm
