jeottesen/e3d-big-box-manual-rebuild/downloads/printed-parts/parts/SPOOL-HOLDER-INNER.step

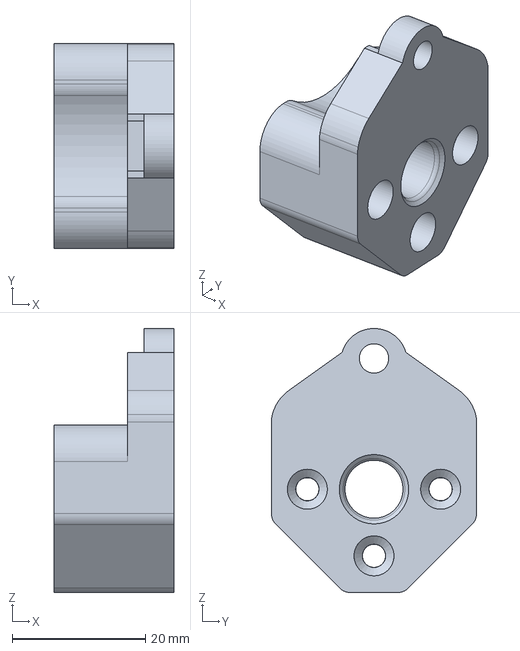
[picture p59: CAD file, 2026-11-06]
downloads/printed-parts/parts/SPOOL-HOLDER-INNER.step
18.0 x 30.8 x 39.6 mm
