jeottesen/e3d-big-box-manual-rebuild/downloads/printed-parts/parts/Ooze-Wiper.step

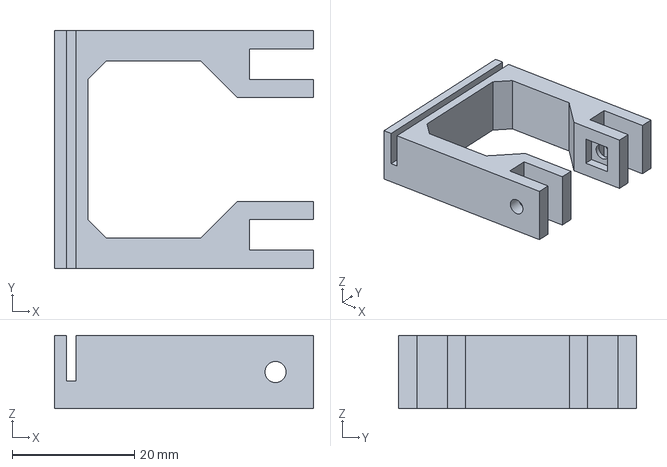
[picture p60: CAD file, 2026-11-06]
downloads/printed-parts/parts/Ooze-Wiper.step
42.4 x 39.0 x 12.0 mm
