jeottesen/e3d-big-box-manual-rebuild/downloads/printed-parts/parts/Hybrid-X-Carriage-Front-Bearing-Clamp.step

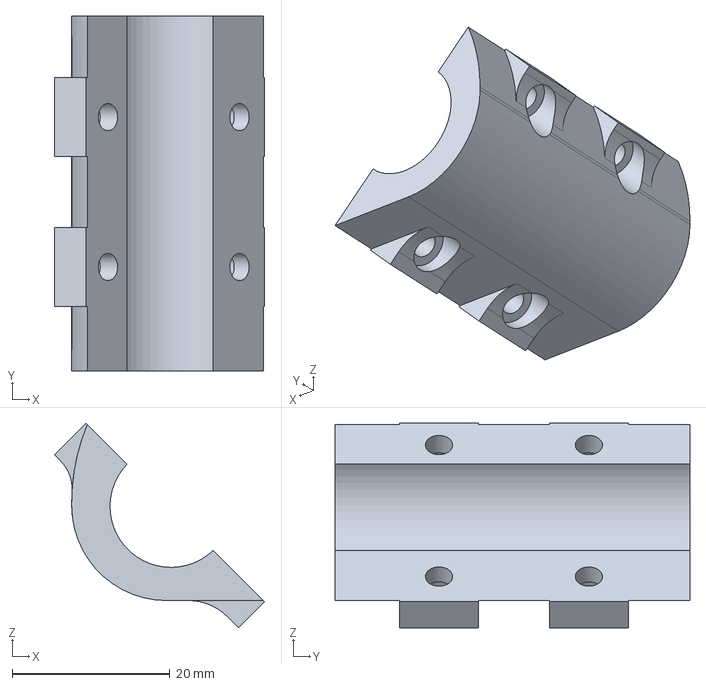
[picture p61: CAD file, 2026-11-06]
downloads/printed-parts/parts/Hybrid-X-Carriage-Front-Bearing-Clamp.step
26.6 x 45.0 x 25.9 mm
