jeottesen/e3d-big-box-manual-rebuild/downloads/printed-parts/parts/HEATED-BED-CORNERS.step

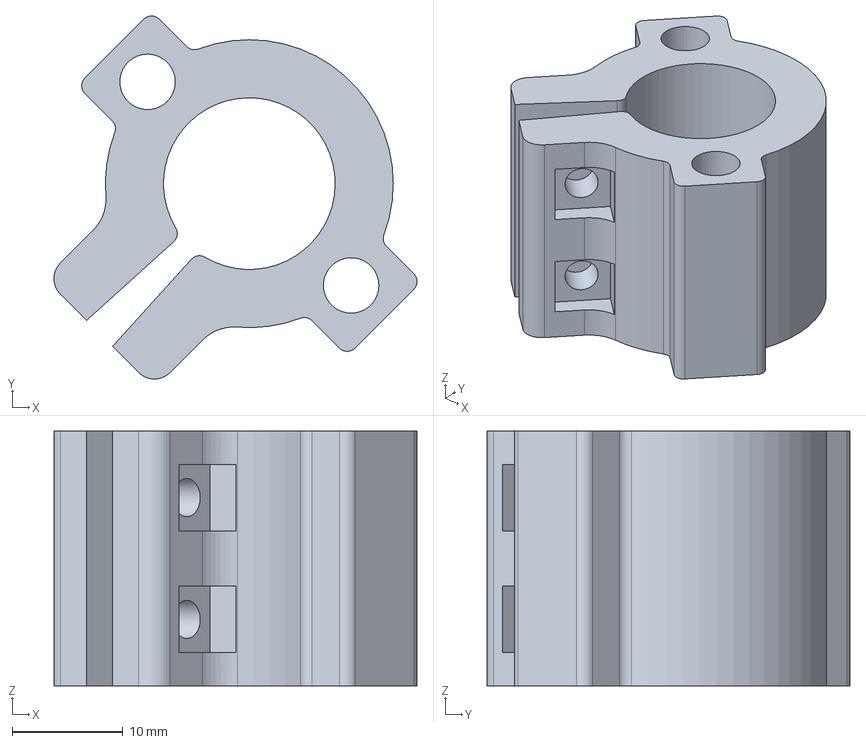
[picture p62: CAD file, 2026-11-06]
downloads/printed-parts/parts/HEATED-BED-CORNERS.step
32.8 x 32.8 x 23.0 mm
