jeottesen/e3d-big-box-manual-rebuild/downloads/printed-parts/parts/Z-AXIS-DRAG-CHAIN-ANCHOR-BASE.step

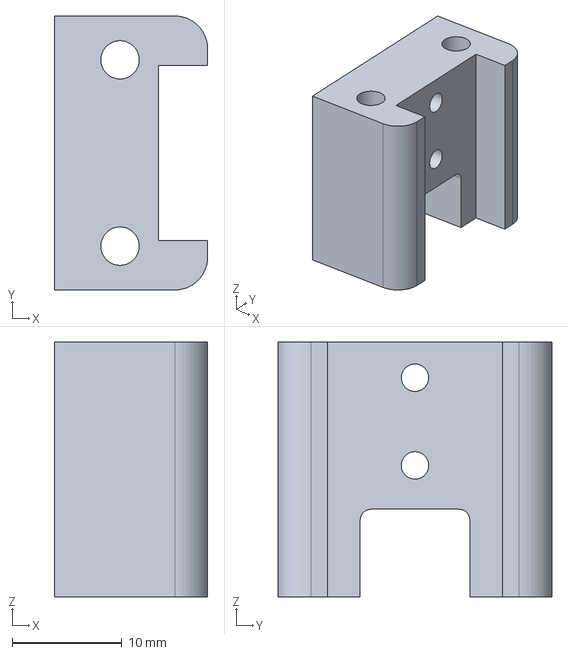
[picture p63: CAD file, 2026-11-06]
downloads/printed-parts/parts/Z-AXIS-DRAG-CHAIN-ANCHOR-BASE.step
14.0 x 25.0 x 23.2 mm
