jeottesen/e3d-big-box-manual-rebuild/downloads/printed-parts/parts/Drag-Anchor-Bracket.step

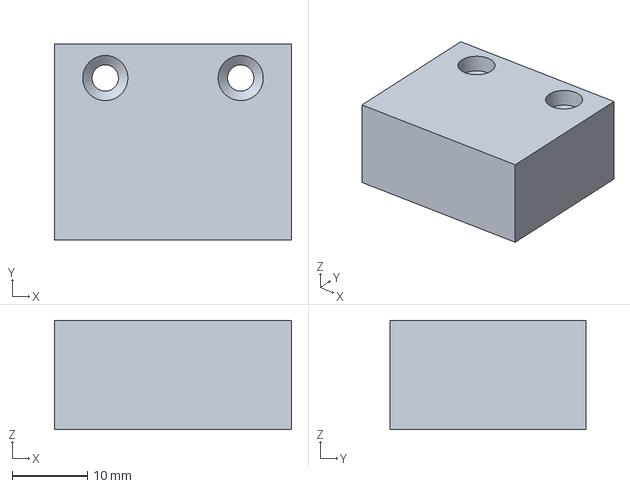
[picture p64: CAD file, 2026-11-06]
downloads/printed-parts/parts/Drag-Anchor-Bracket.step
31.5 x 26.0 x 14.5 mm
