jeottesen/e3d-big-box-manual-rebuild/downloads/printed-parts/parts/Z-AXIS-TOP-TOP.step

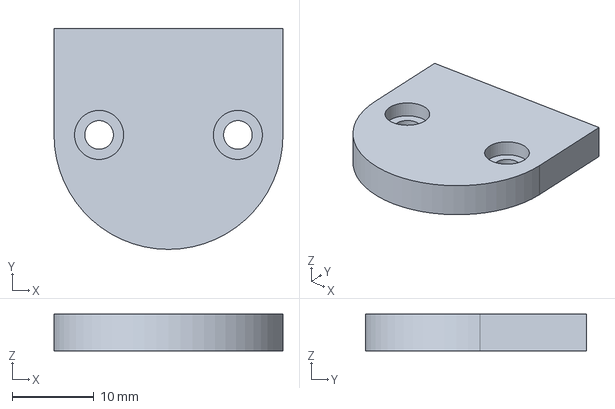
[picture p65: CAD file, 2026-11-06]
downloads/printed-parts/parts/Z-AXIS-TOP-TOP.step
28.0 x 27.0 x 4.50 mm
