jeottesen/e3d-big-box-manual-rebuild/downloads/printed-parts/parts/Z-AXIS-TOP-CAP.step

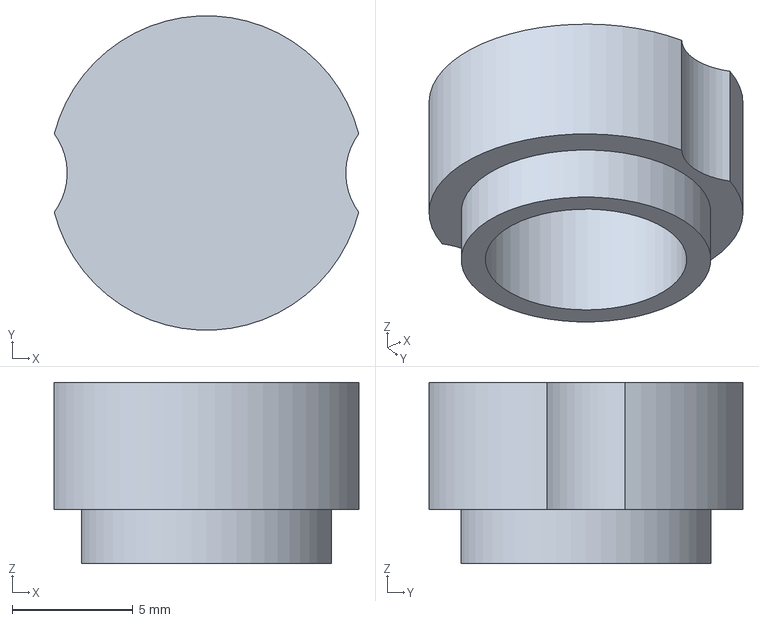
[picture p66: CAD file, 2026-11-06]
downloads/printed-parts/parts/Z-AXIS-TOP-CAP.step
12.6 x 13.0 x 7.50 mm
