jeottesen/e3d-big-box-manual-rebuild/downloads/printed-parts/parts/Dual-Ooze-Wiper.step

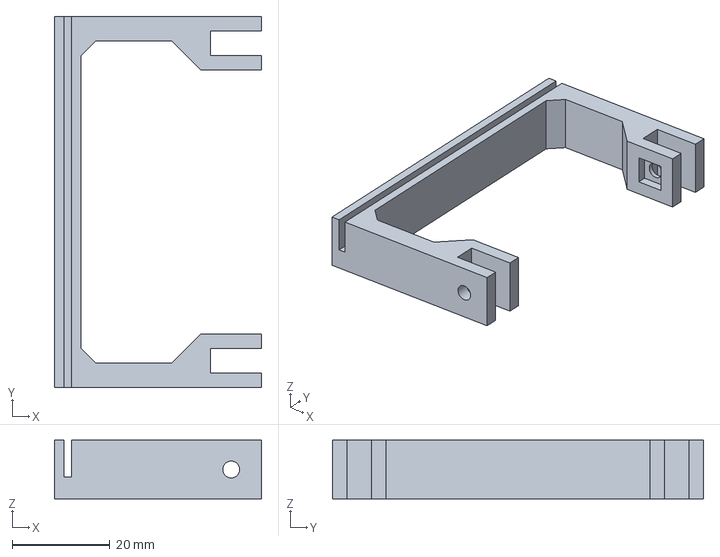
[picture p67: CAD file, 2026-11-06]
downloads/printed-parts/parts/Dual-Ooze-Wiper.step
42.4 x 76.0 x 12.0 mm
