jeottesen/e3d-big-box-manual-rebuild/downloads/printed-parts/parts/Printed-Feet.step

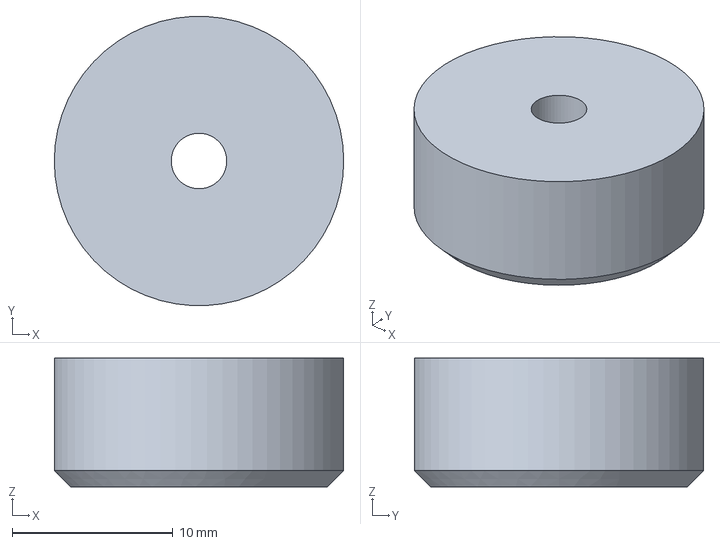
[picture p68: CAD file, 2026-11-06]
downloads/printed-parts/parts/Printed-Feet.step
18.0 x 18.0 x 8.00 mm
