jeottesen/e3d-big-box-manual-rebuild/downloads/printed-parts/parts/FFC-Conduits.step

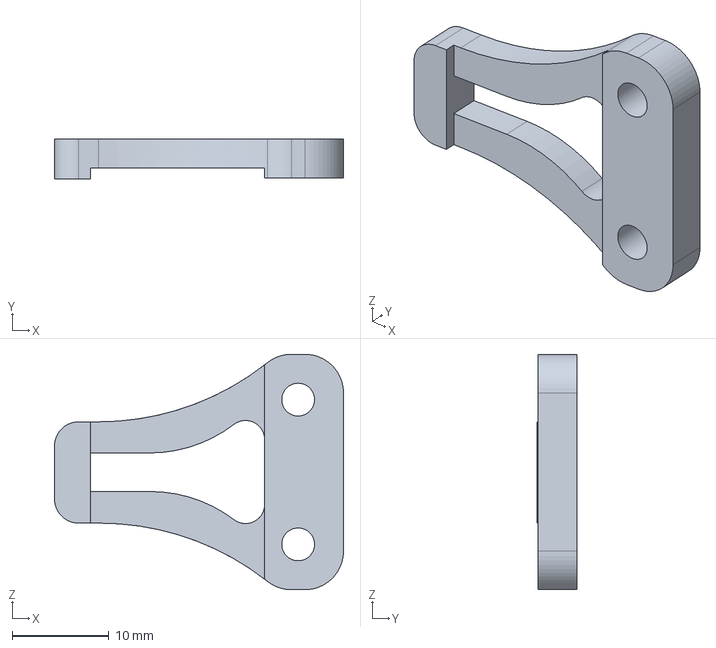
[picture p69: CAD file, 2026-11-06]
downloads/printed-parts/parts/FFC-Conduits.step
30.0 x 4.10 x 24.4 mm
