jeottesen/e3d-big-box-manual-rebuild/downloads/printed-parts/parts/Hybrid-X-Carriage.step

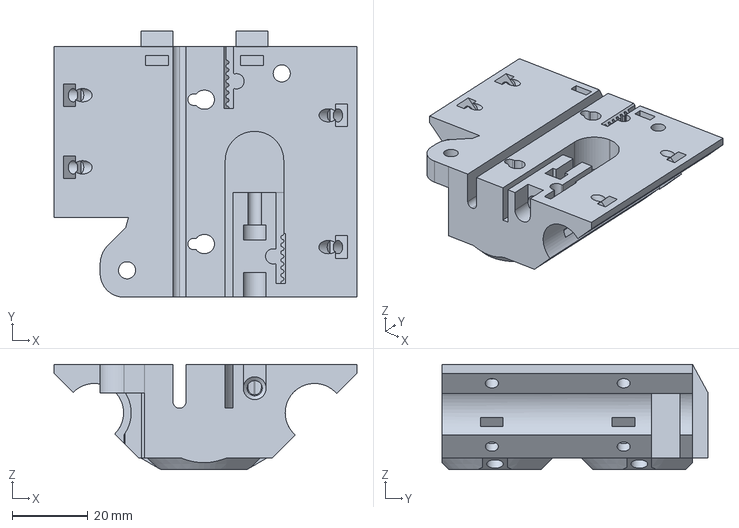
[picture p70: CAD file, 2026-11-06]
downloads/printed-parts/parts/Hybrid-X-Carriage.step
79.8 x 70.1 x 27.6 mm
