jeottesen/e3d-big-box-manual-rebuild/downloads/printed-parts/parts/E-AXIS-CABLE-BRACKET-DUAL-R.step

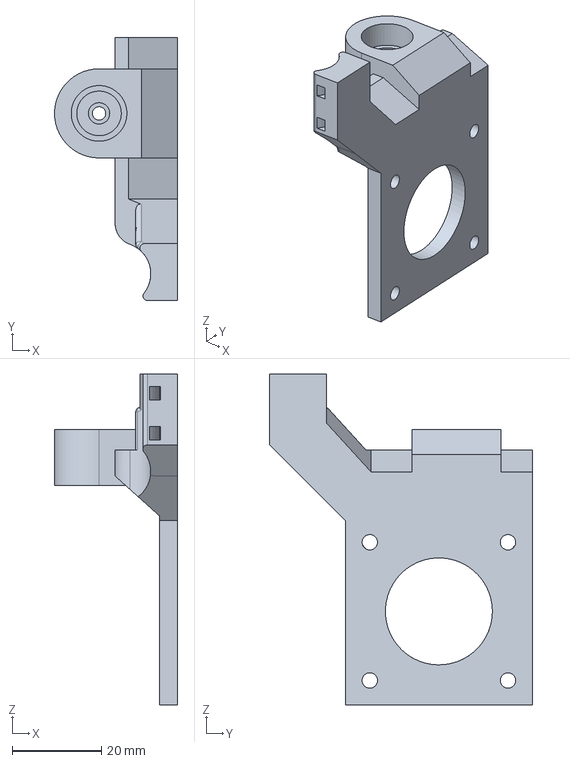
[picture p71: CAD file, 2026-11-06]
downloads/printed-parts/parts/E-AXIS-CABLE-BRACKET-DUAL-R.step
27.6 x 59.0 x 74.3 mm
