jeottesen/e3d-big-box-manual-rebuild/downloads/printed-parts/parts/SPOOL-HOLDER-OUTER-R.step

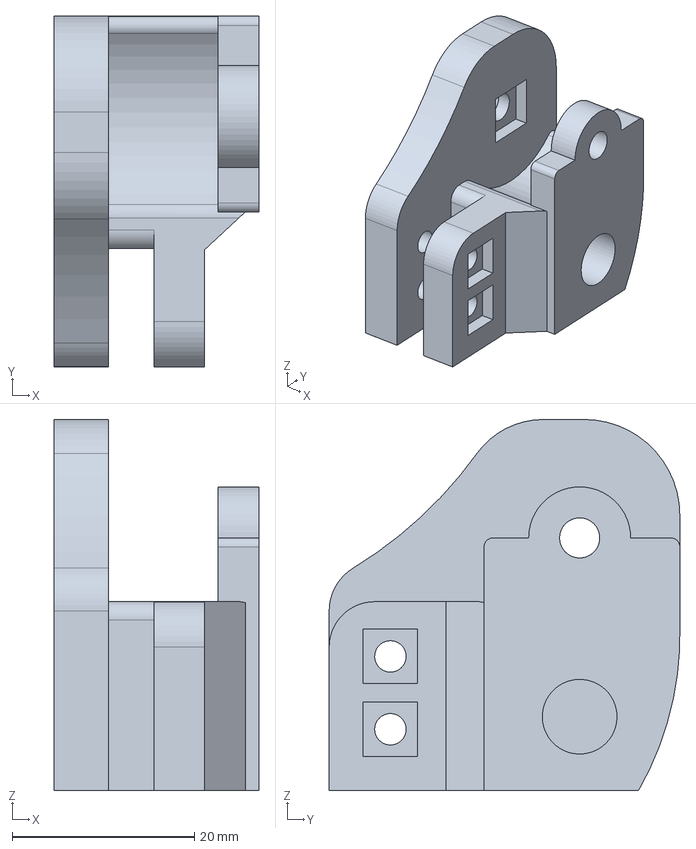
[picture p72: CAD file, 2026-11-06]
downloads/printed-parts/parts/SPOOL-HOLDER-OUTER-R.step
22.5 x 38.5 x 40.7 mm
