jeottesen/e3d-big-box-manual-rebuild/downloads/printed-parts/parts/Bottom-Camera-Bracket.step

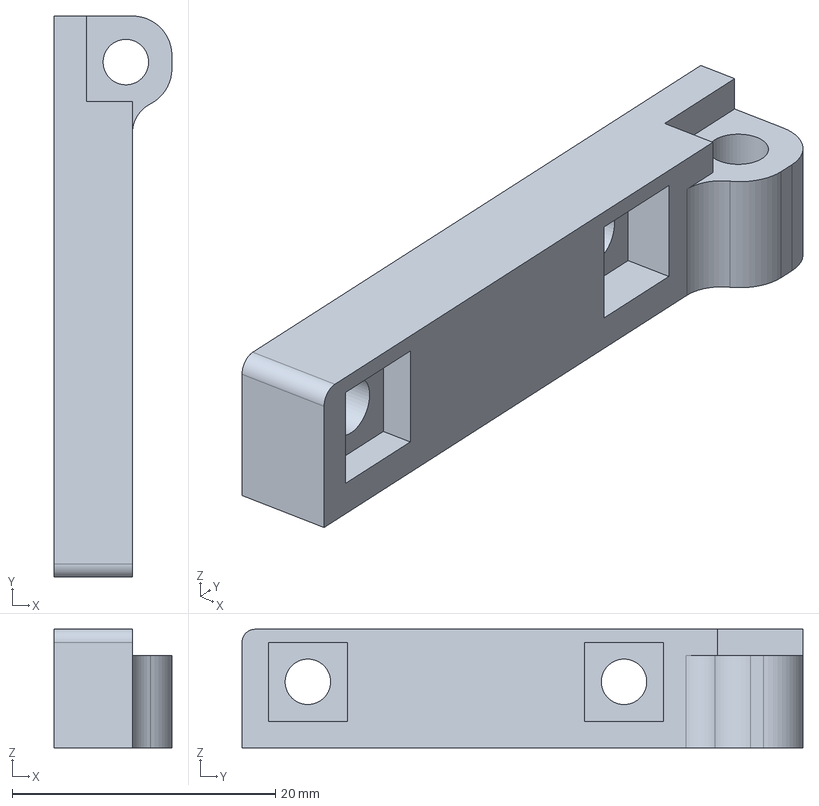
[picture p73: CAD file, 2026-11-06]
downloads/printed-parts/parts/Bottom-Camera-Bracket.step
8.95 x 42.6 x 9.00 mm
