jeottesen/e3d-big-box-manual-rebuild/downloads/printed-parts/parts/ELECTRONICS-COVER-BRACKET.step

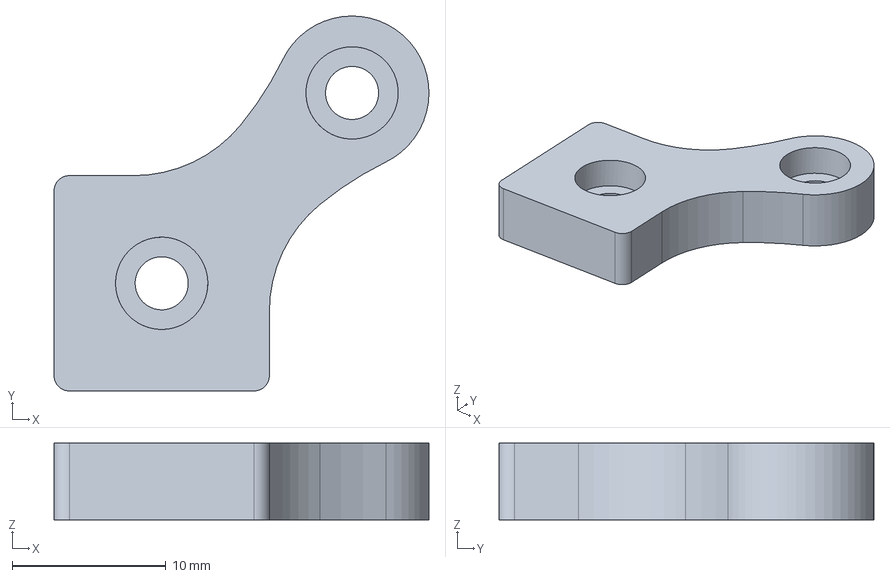
[picture p74: CAD file, 2026-11-06]
downloads/printed-parts/parts/ELECTRONICS-COVER-BRACKET.step
24.4 x 24.4 x 5.00 mm
