jeottesen/e3d-big-box-manual-rebuild/downloads/printed-parts/parts/X-AXIS-MOTOR-CARRIAGE.step

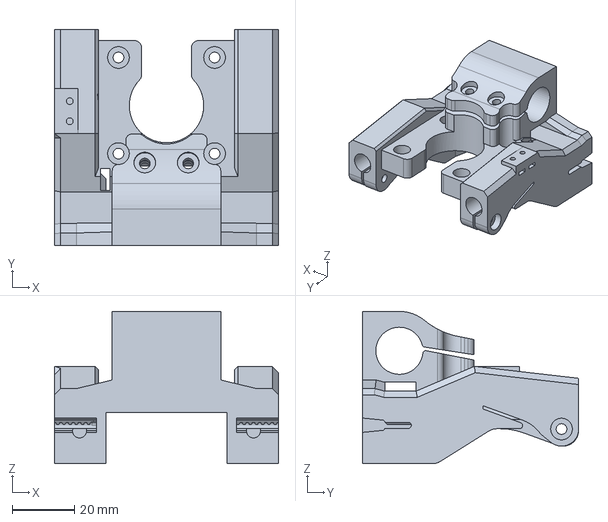
[picture p75: CAD file, 2026-11-06]
downloads/printed-parts/parts/X-AXIS-MOTOR-CARRIAGE.step
72.3 x 69.7 x 49.1 mm
