jeottesen/e3d-big-box-manual-rebuild/downloads/printed-parts/parts/SPINE-SMALL.step

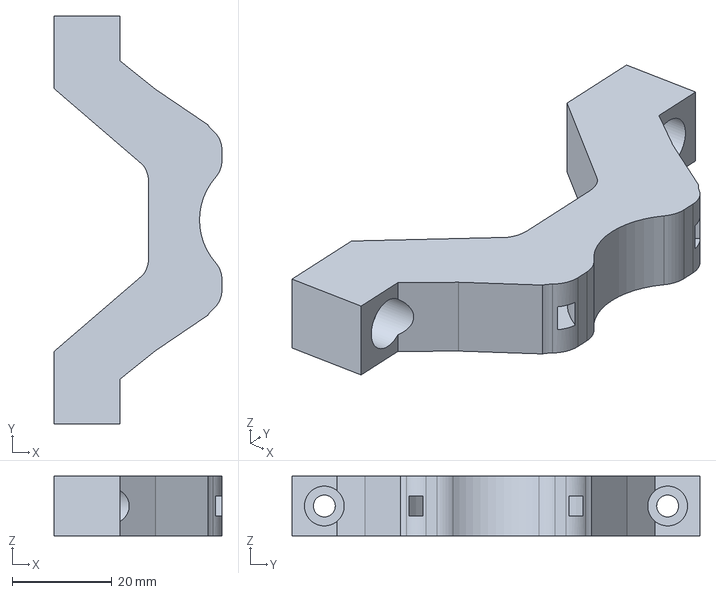
[picture p76: CAD file, 2026-11-06]
downloads/printed-parts/parts/SPINE-SMALL.step
33.7 x 82.0 x 12.0 mm
