jeottesen/e3d-big-box-manual-rebuild/downloads/printed-parts/parts/SPOOL-HOLDER-CLAMP-INNER.step

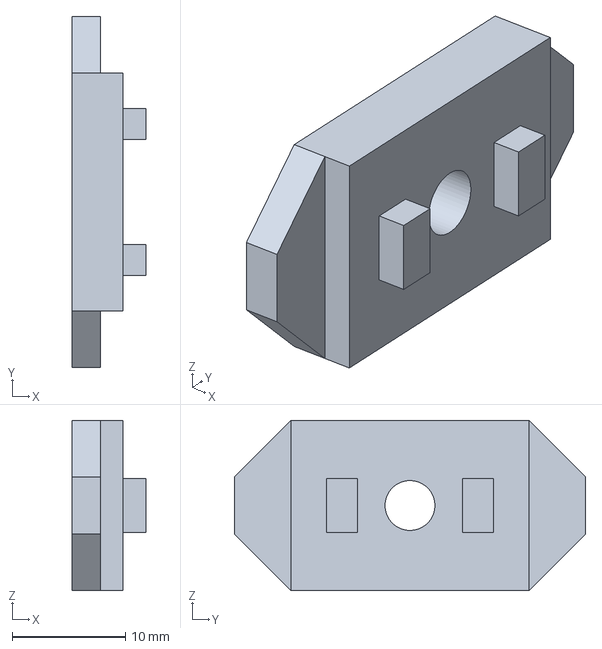
[picture p77: CAD file, 2026-11-06]
downloads/printed-parts/parts/SPOOL-HOLDER-CLAMP-INNER.step
6.50 x 31.0 x 15.0 mm
