jeottesen/e3d-big-box-manual-rebuild/downloads/printed-parts/parts/Y-AXIS-BELT-TENSIONER.step

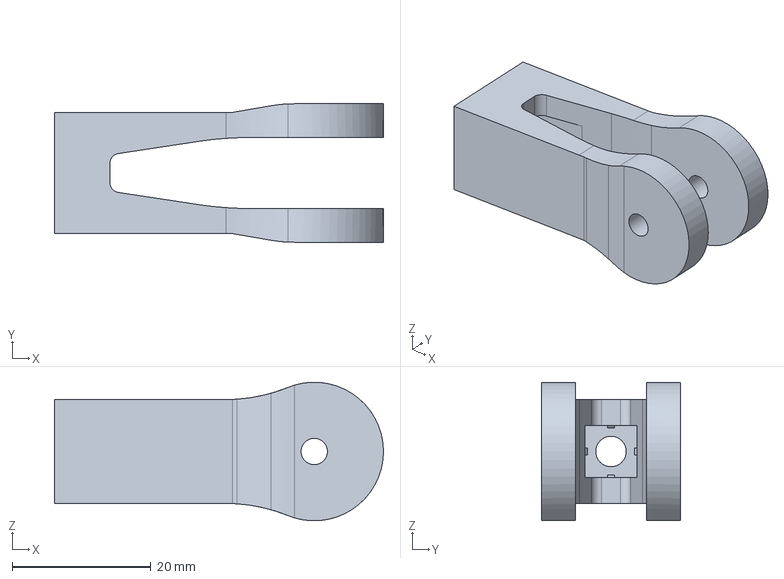
[picture p78: CAD file, 2026-11-06]
downloads/printed-parts/parts/Y-AXIS-BELT-TENSIONER.step
47.5 x 20.0 x 20.0 mm
