jeottesen/e3d-big-box-manual-rebuild/downloads/printed-parts/parts/Y-AXIS-REAR-R.step

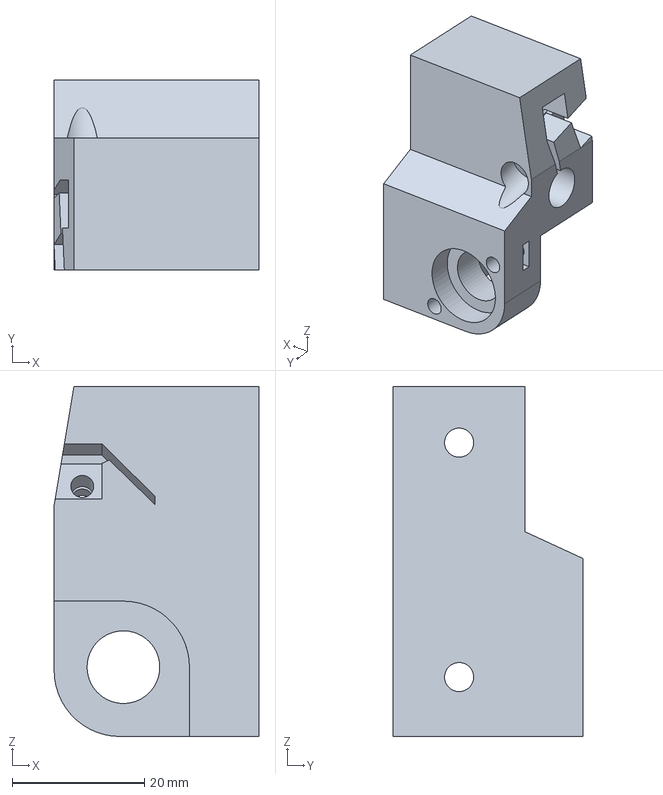
[picture p79: CAD file, 2026-11-06]
downloads/printed-parts/parts/Y-AXIS-REAR-R.step
31.0 x 28.8 x 53.0 mm
