jeottesen/e3d-big-box-manual-rebuild/downloads/printed-parts/parts/Fan-Mount.step

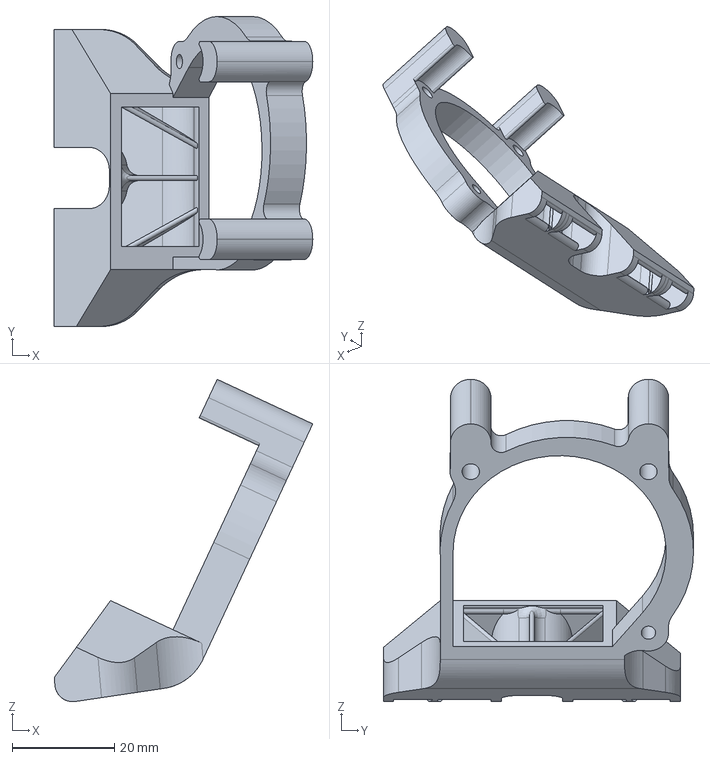
[picture p80: CAD file, 2026-11-06]
downloads/printed-parts/parts/Fan-Mount.step
50.5 x 60.5 x 63.0 mm
