jeottesen/e3d-big-box-manual-rebuild/downloads/printed-parts/parts/SPINE-LARGE.step

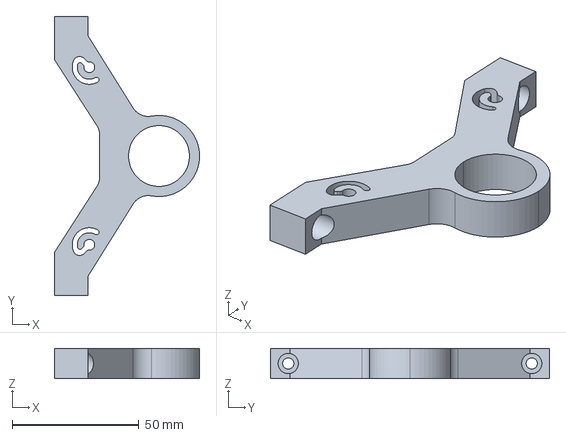
[picture p81: CAD file, 2026-11-06]
downloads/printed-parts/parts/SPINE-LARGE.step
57.2 x 110.0 x 12.0 mm
