jeottesen/e3d-big-box-manual-rebuild/downloads/printed-parts/parts/Hybrid-IR-Sensor-Bracket.step

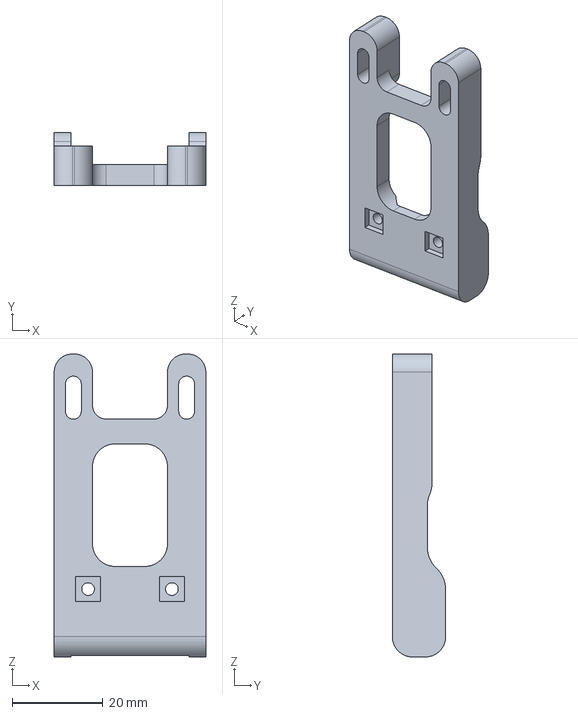
[picture p83: CAD file, 2026-11-06]
downloads/printed-parts/parts/Hybrid-IR-Sensor-Bracket.step
33.5 x 11.8 x 66.9 mm
