jeottesen/e3d-big-box-manual-rebuild/downloads/printed-parts/parts/E-AXIS-CARRIAGE-TOP-HYBRID-NON-TITAN-DIRECT-BODY.step

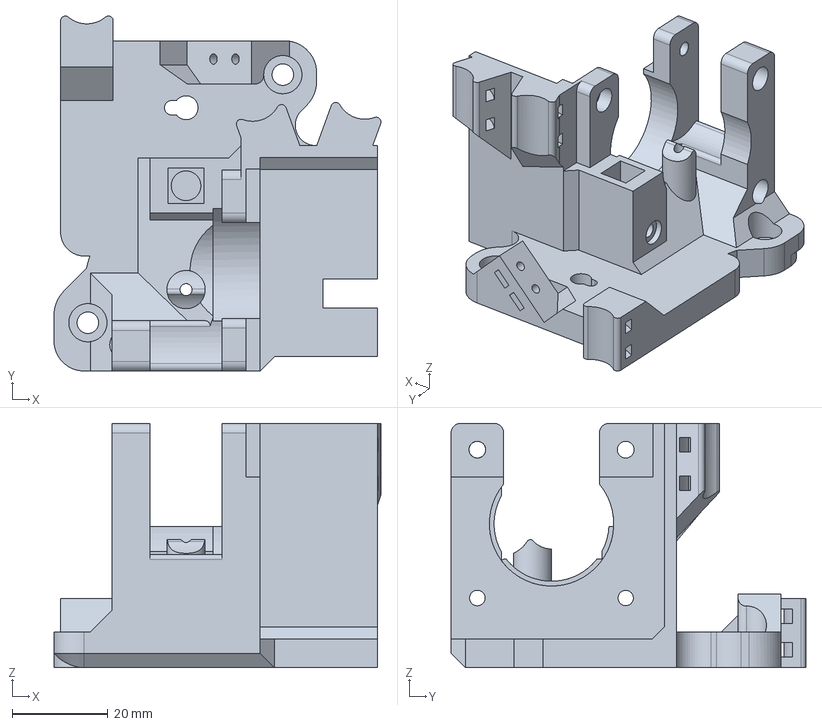
[picture p84: CAD file, 2026-11-06]
downloads/printed-parts/parts/E-AXIS-CARRIAGE-TOP-HYBRID-NON-TITAN-DIRECT-BODY.step
68.3 x 74.2 x 51.1 mm
