jeottesen/e3d-big-box-manual-rebuild/downloads/printed-parts/parts/EXTRUDER-BODY-DUAL.step

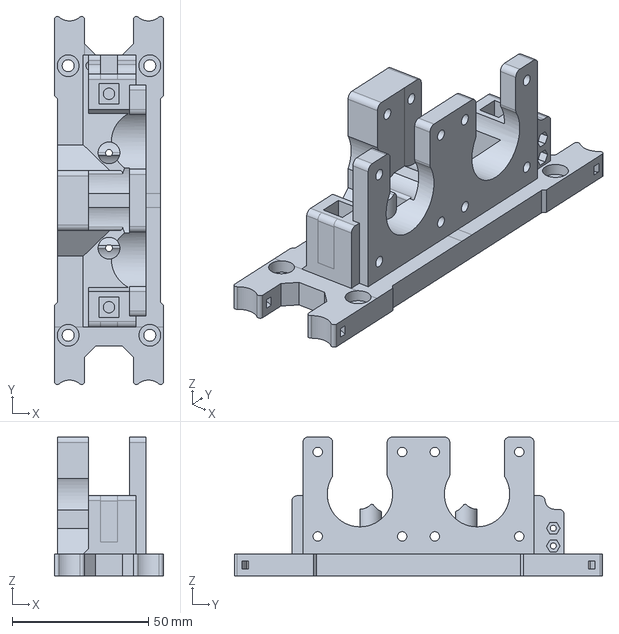
[picture p85: CAD file, 2026-11-06]
downloads/printed-parts/parts/EXTRUDER-BODY-DUAL.step
40.0 x 135.2 x 51.1 mm
