jeottesen/e3d-big-box-manual-rebuild/downloads/printed-parts/parts/Drive-Supports.step

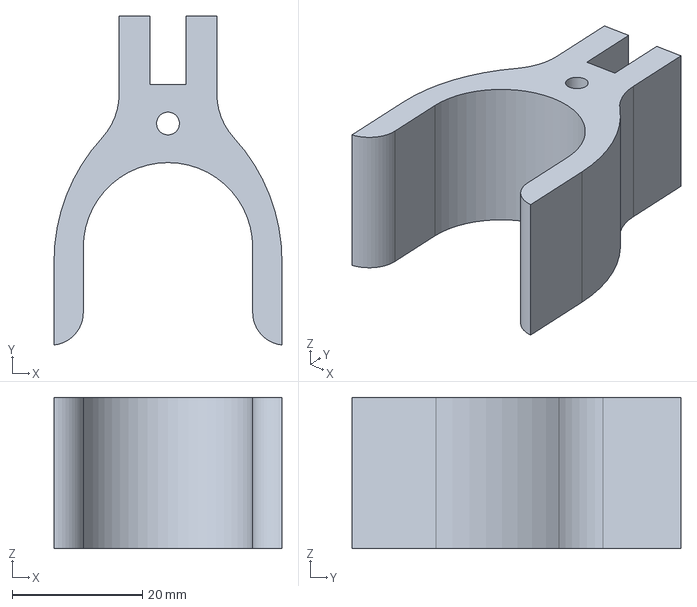
[picture p86: CAD file, 2026-11-06]
downloads/printed-parts/parts/Drive-Supports.step
35.0 x 50.5 x 23.2 mm
