jeottesen/e3d-big-box-manual-rebuild/downloads/printed-parts/parts/X-AXIS-IDLER-CARRIAGE.step

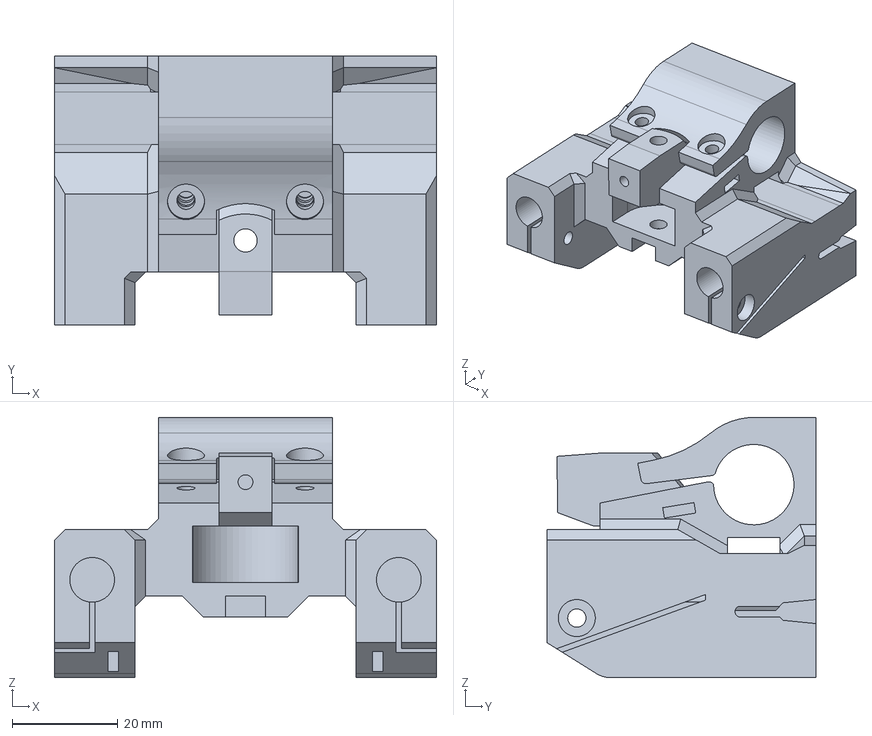
[picture p87: CAD file, 2026-11-06]
downloads/printed-parts/parts/X-AXIS-IDLER-CARRIAGE.step
72.3 x 50.9 x 49.2 mm
