jeottesen/e3d-big-box-manual-rebuild/downloads/printed-parts/parts/Y-AXIS-MOTOR-MOUNT.step

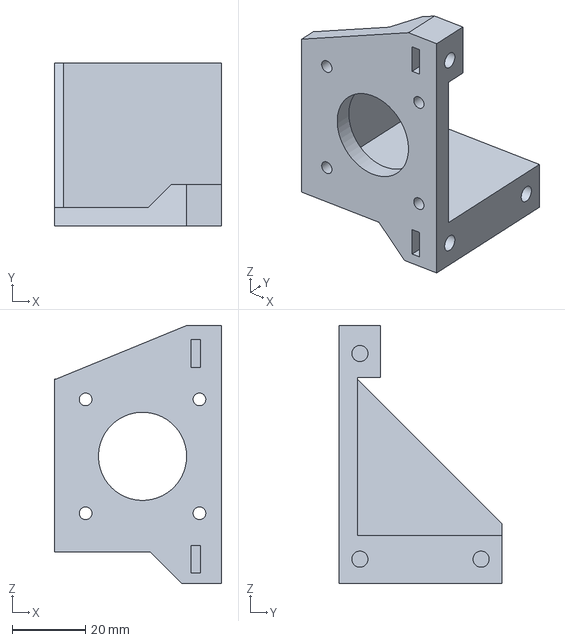
[picture p88: CAD file, 2026-11-06]
downloads/printed-parts/parts/Y-AXIS-MOTOR-MOUNT.step
45.5 x 44.3 x 70.2 mm
