jeottesen/e3d-big-box-manual-rebuild/downloads/printed-parts/parts/E-AXIS-CARRIAGE-TOP-HYBRID-TITAN-DIRECT.step

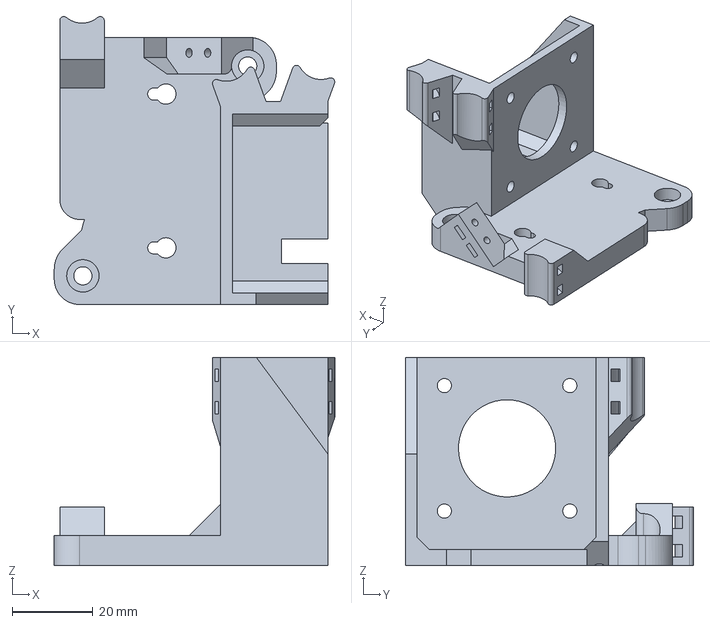
[picture p89: CAD file, 2026-11-06]
downloads/printed-parts/parts/E-AXIS-CARRIAGE-TOP-HYBRID-TITAN-DIRECT.step
69.3 x 71.2 x 51.5 mm
