jeottesen/e3d-big-box-manual-rebuild/downloads/printed-parts/parts/Dump-Bucket.step

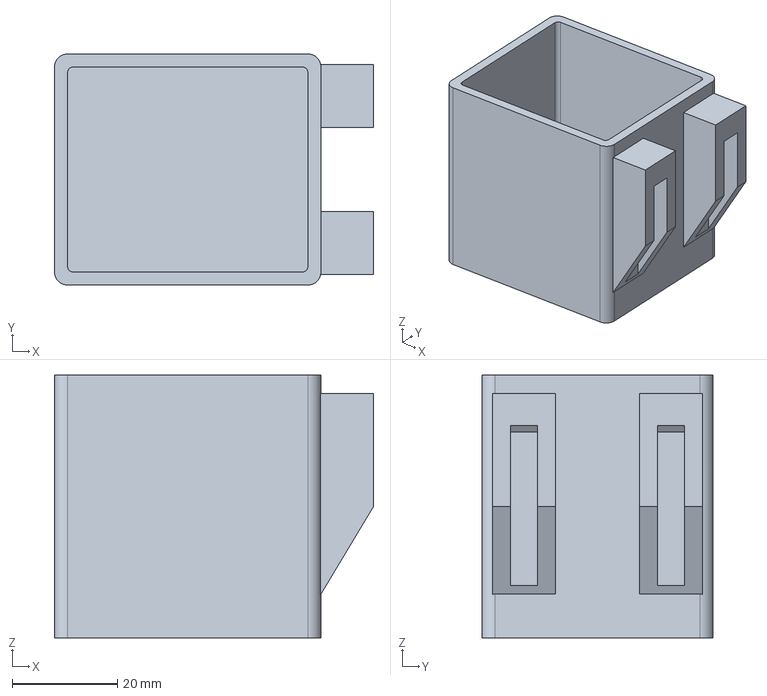
[picture p90: CAD file, 2026-11-06]
downloads/printed-parts/parts/Dump-Bucket.step
60.7 x 44.0 x 50.0 mm
