jeottesen/e3d-big-box-manual-rebuild/downloads/printed-parts/parts/Z-AXIS-DRAG-CHAIN-ANCHOR-BED.step

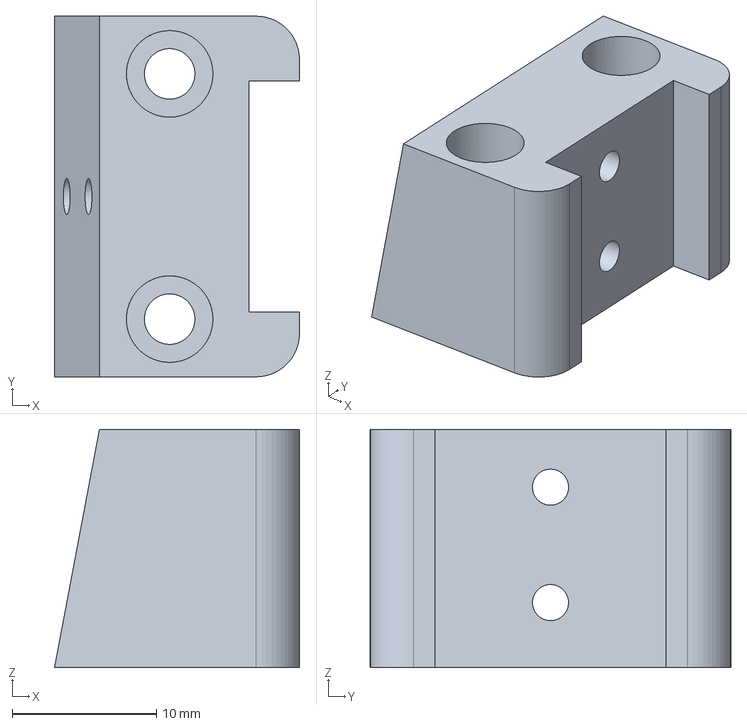
[picture p91: CAD file, 2026-11-06]
downloads/printed-parts/parts/Z-AXIS-DRAG-CHAIN-ANCHOR-BED.step
17.0 x 25.0 x 16.5 mm
