jeottesen/e3d-big-box-manual-rebuild/downloads/printed-parts/parts/Spool-Inner-Brackets.step

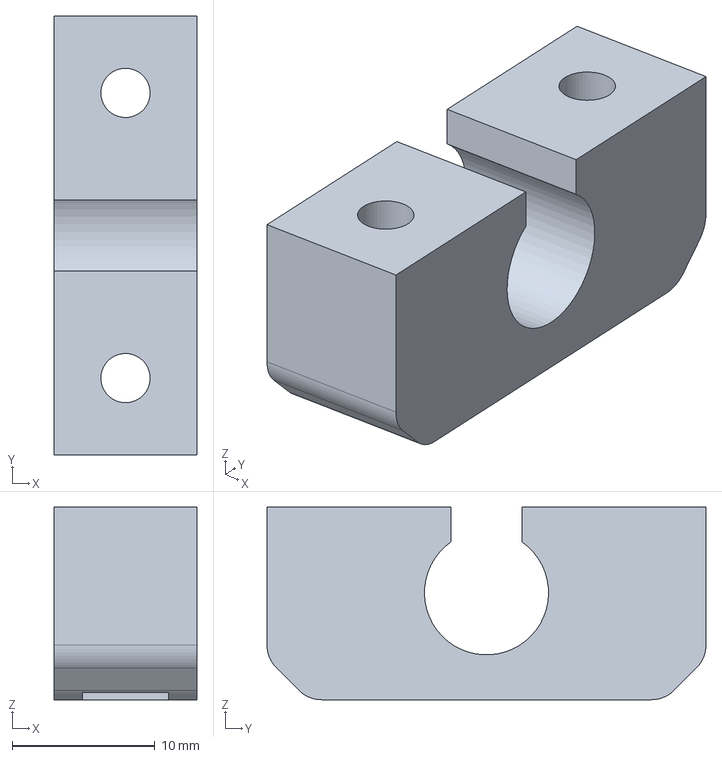
[picture p92: CAD file, 2026-11-06]
downloads/printed-parts/parts/Spool-Inner-Brackets.step
10.0 x 30.8 x 13.5 mm
