jeottesen/e3d-big-box-manual-rebuild/downloads/printed-parts/parts/Camera-Mount.step

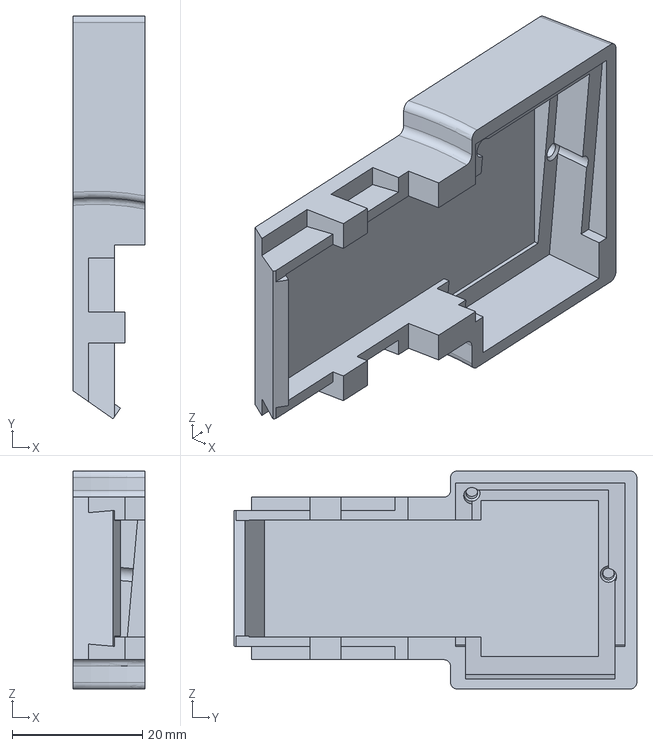
[picture p93: CAD file, 2026-11-06]
downloads/printed-parts/parts/Camera-Mount.step
11.0 x 61.9 x 33.5 mm
