jeottesen/e3d-big-box-manual-rebuild/downloads/printed-parts/parts/SPINE-MED.step

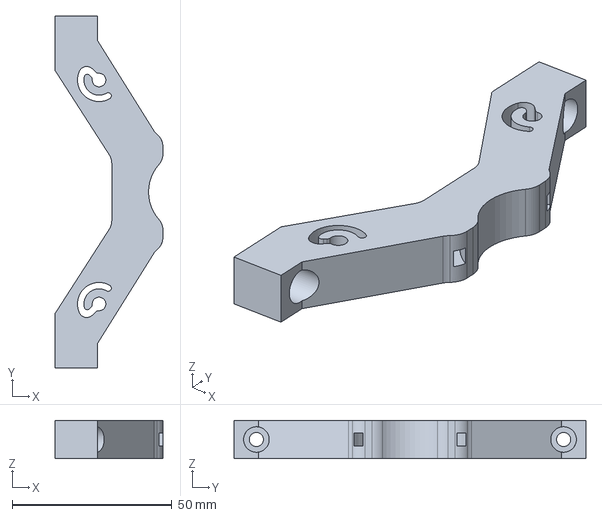
[picture p94: CAD file, 2026-11-06]
downloads/printed-parts/parts/SPINE-MED.step
33.7 x 110.0 x 12.0 mm
