jeottesen/e3d-big-box-manual-rebuild/downloads/printed-parts/parts/X-AXIS-CARRIAGE-BEARING-CLAMP__regular.step

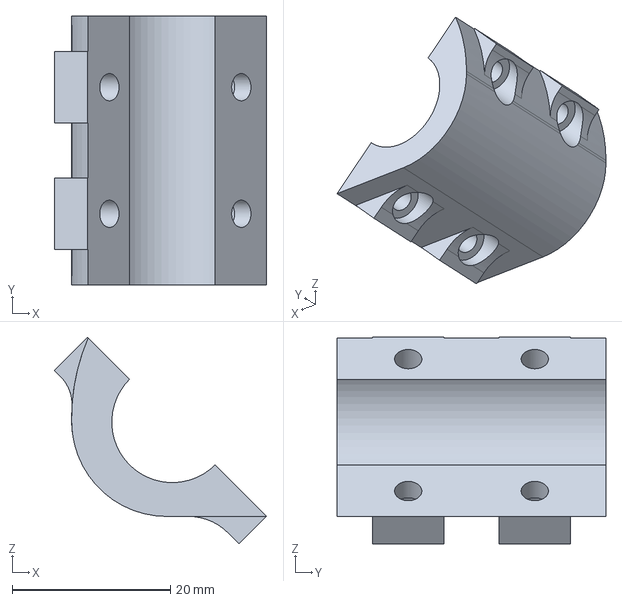
[picture p95: CAD file, 2026-11-06]
downloads/printed-parts/parts/X-AXIS-CARRIAGE-BEARING-CLAMP__regular.step
26.8 x 34.0 x 26.1 mm
