jeottesen/e3d-big-box-manual-rebuild/downloads/printed-parts/parts/Y-AXIS-REAR-L-R-BEARING-RETAINER.step

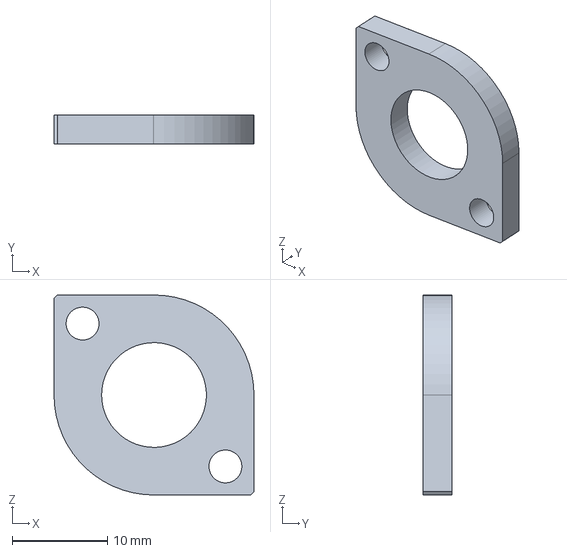
[picture p96: CAD file, 2026-11-06]
downloads/printed-parts/parts/Y-AXIS-REAR-L-R-BEARING-RETAINER.step
21.0 x 3.00 x 21.0 mm
