jeottesen/e3d-big-box-manual-rebuild/downloads/printed-parts/parts/Z-Axis-Driver-Bottoms.step

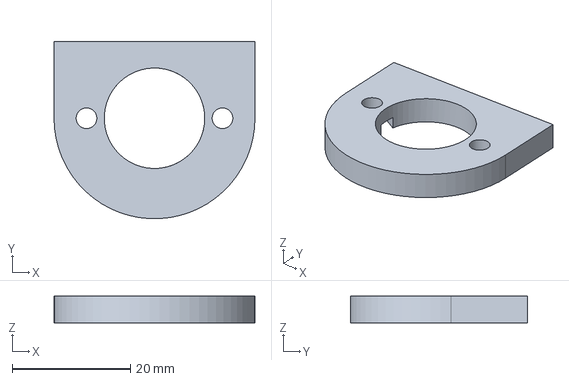
[picture p97: CAD file, 2026-11-06]
downloads/printed-parts/parts/Z-Axis-Driver-Bottoms.step
34.0 x 30.0 x 4.50 mm
