jeottesen/e3d-big-box-manual-rebuild/downloads/printed-parts/parts/Hybrid-Ooze-Wiper.step

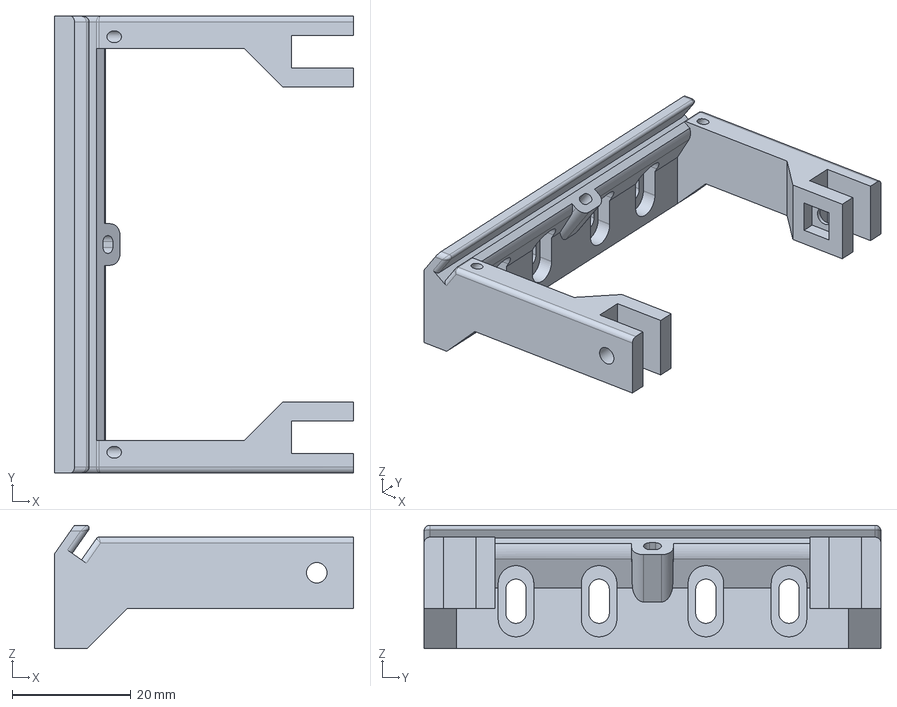
[picture p98: CAD file, 2026-11-06]
downloads/printed-parts/parts/Hybrid-Ooze-Wiper.step
50.4 x 77.0 x 20.8 mm
