jeottesen/e3d-big-box-manual-rebuild/downloads/printed-parts/parts/E-AXIS-CARRIAGE-TOP-HYBRID-NON-TITAN-DIRECT-LEVER.step

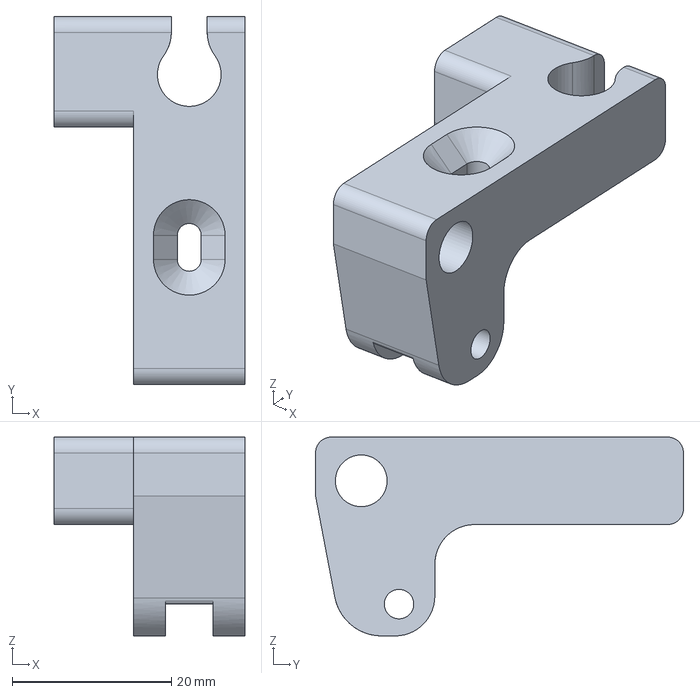
[picture p99: CAD file, 2026-11-06]
downloads/printed-parts/parts/E-AXIS-CARRIAGE-TOP-HYBRID-NON-TITAN-DIRECT-LEVER.step
24.0 x 46.3 x 25.0 mm
