jeottesen/e3d-big-box-manual-rebuild/downloads/printed-parts/parts/PRINT-FAN-BRACKET.step

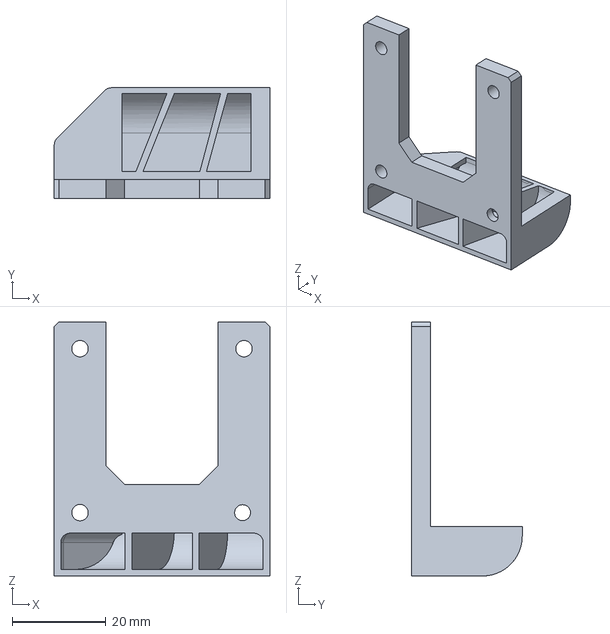
[picture p100: CAD file, 2026-11-06]
downloads/printed-parts/parts/PRINT-FAN-BRACKET.step
46.0 x 23.6 x 54.2 mm
