jeottesen/e3d-big-box-manual-rebuild/downloads/printed-parts/parts/EXTRUDER-BODY-SINGLE.step

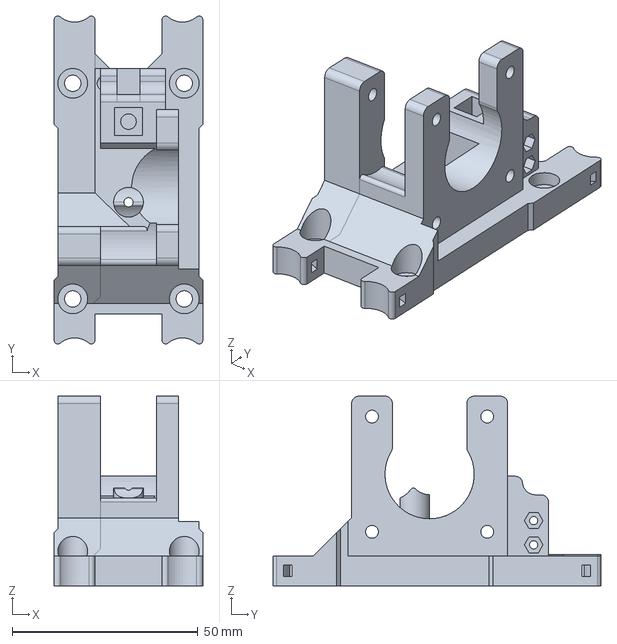
[picture p102: CAD file, 2026-11-06]
downloads/printed-parts/parts/EXTRUDER-BODY-SINGLE.step
40.0 x 88.3 x 51.1 mm
