jeottesen/e3d-big-box-manual-rebuild/downloads/printed-parts/parts/Z-Axis-Driver-Tops.step

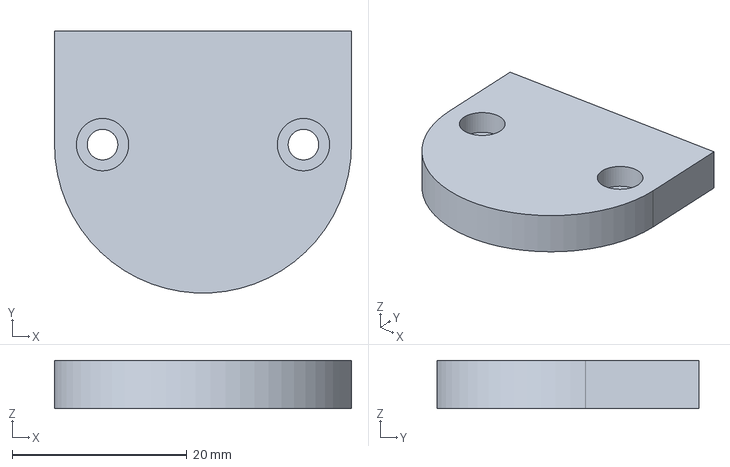
[picture p103: CAD file, 2026-11-06]
downloads/printed-parts/parts/Z-Axis-Driver-Tops.step
34.0 x 30.0 x 5.50 mm
