jeottesen/e3d-big-box-manual-rebuild/downloads/printed-parts/parts/SPINE-VERTICAL.step

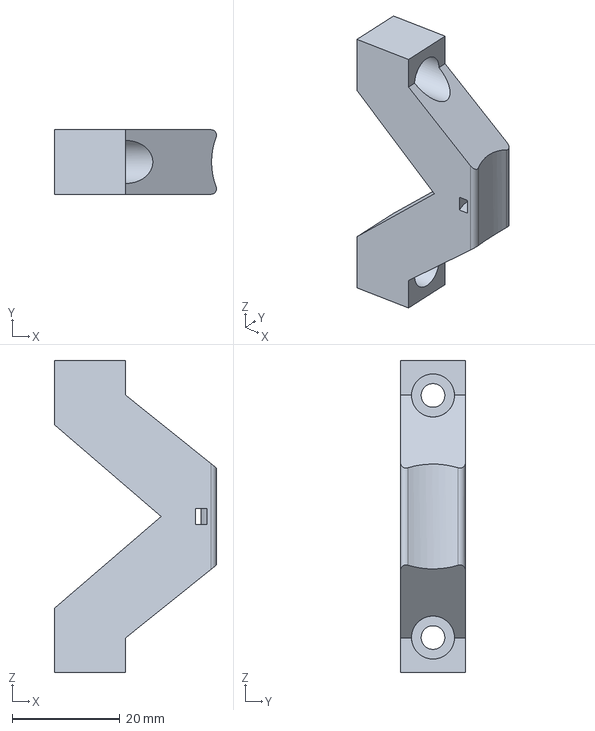
[picture p104: CAD file, 2026-11-06]
downloads/printed-parts/parts/SPINE-VERTICAL.step
30.2 x 12.0 x 58.0 mm
