jeottesen/e3d-big-box-manual-rebuild/downloads/printed-parts/parts/E-AXIS-CARRIAGE-TOP-HYBRID-NON-TITAN-DIRECT-GUIDE.step

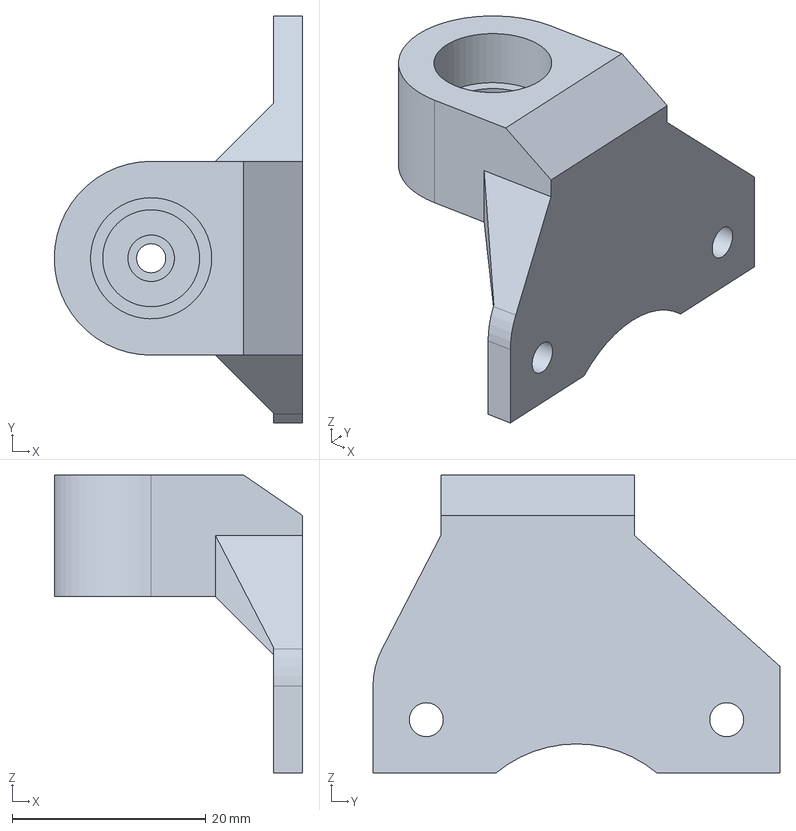
[picture p105: CAD file, 2026-11-06]
downloads/printed-parts/parts/E-AXIS-CARRIAGE-TOP-HYBRID-NON-TITAN-DIRECT-GUIDE.step
25.6 x 42.0 x 30.8 mm
