jeottesen/e3d-big-box-manual-rebuild/downloads/printed-parts/parts/EXTRUDER-CABLE-BRACKET.step

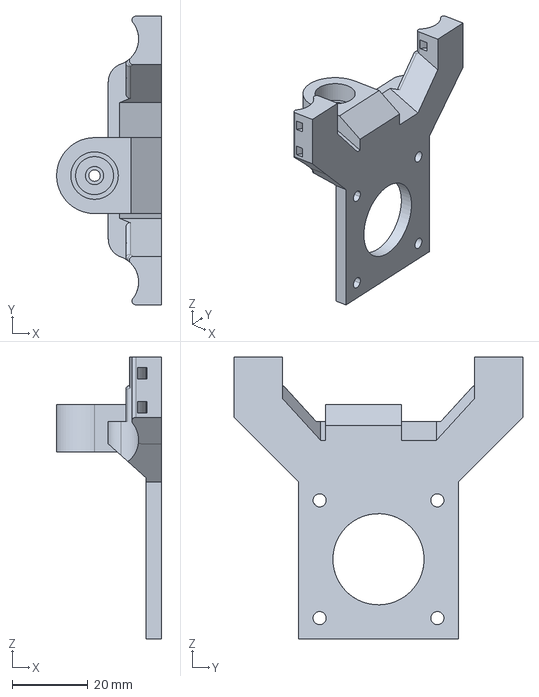
[picture p106: CAD file, 2026-11-06]
downloads/printed-parts/parts/EXTRUDER-CABLE-BRACKET.step
27.6 x 76.0 x 74.3 mm
