jeottesen/e3d-big-box-manual-rebuild/downloads/printed-parts/parts/X-AXIS-BELT-TENSIONER.step

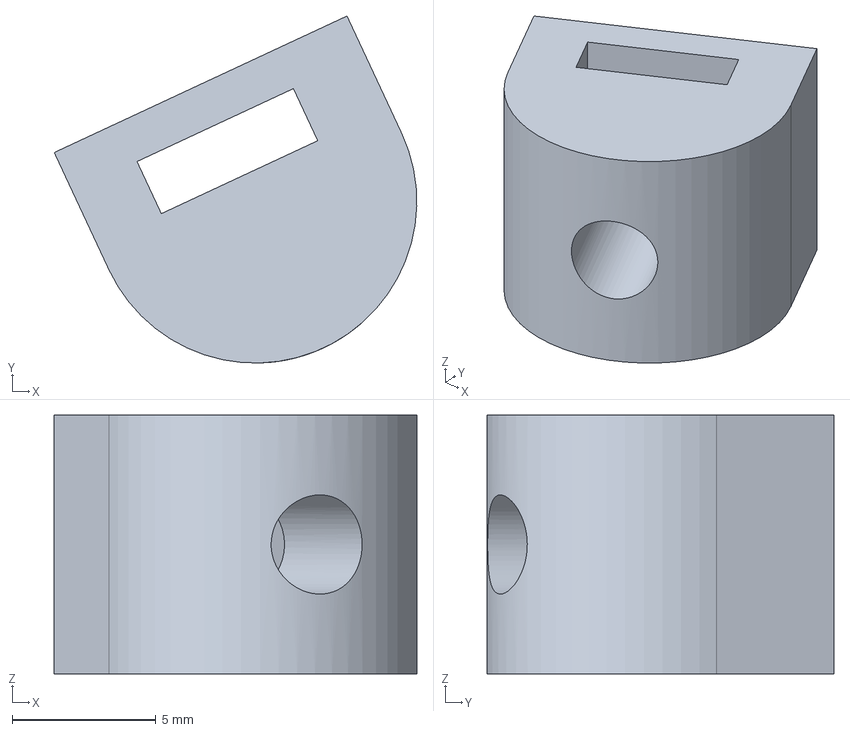
[picture p107: CAD file, 2026-11-06]
downloads/printed-parts/parts/X-AXIS-BELT-TENSIONER.step
12.6 x 12.1 x 9.00 mm
