jeottesen/e3d-big-box-manual-rebuild/downloads/printed-parts/parts/Y-AXIS-FRONT-R.step

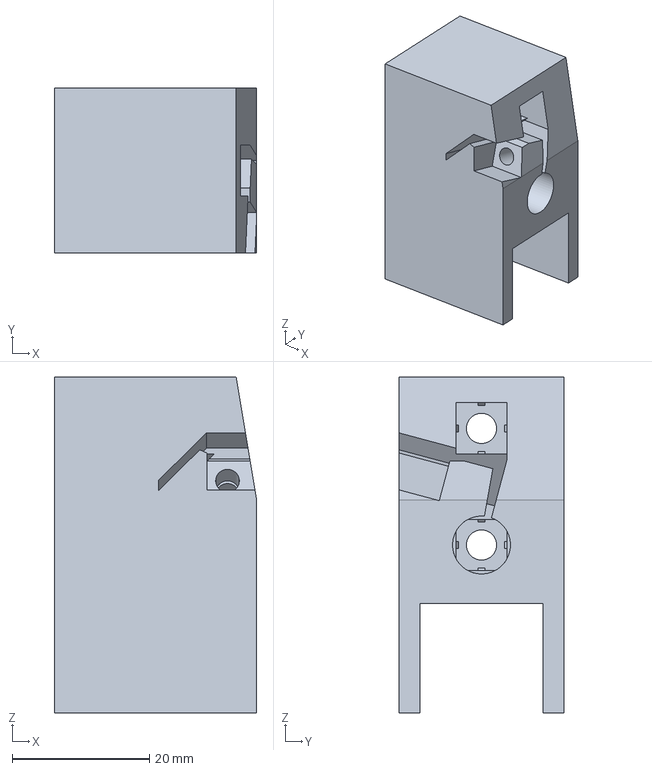
[picture p108: CAD file, 2026-11-06]
downloads/printed-parts/parts/Y-AXIS-FRONT-R.step
29.5 x 24.0 x 49.0 mm
