jeottesen/e3d-big-box-manual-rebuild/downloads/printed-parts/parts/DOCK-BRACKET.step

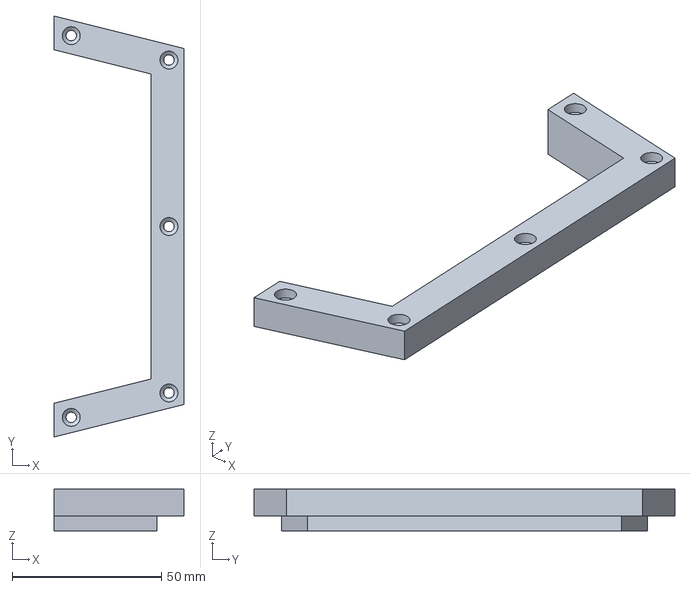
[picture p109: CAD file, 2026-11-06]
downloads/printed-parts/parts/DOCK-BRACKET.step
43.5 x 141.2 x 14.0 mm
