jeottesen/e3d-big-box-manual-rebuild/downloads/printed-parts/parts/E-AXIS-IDLER.step

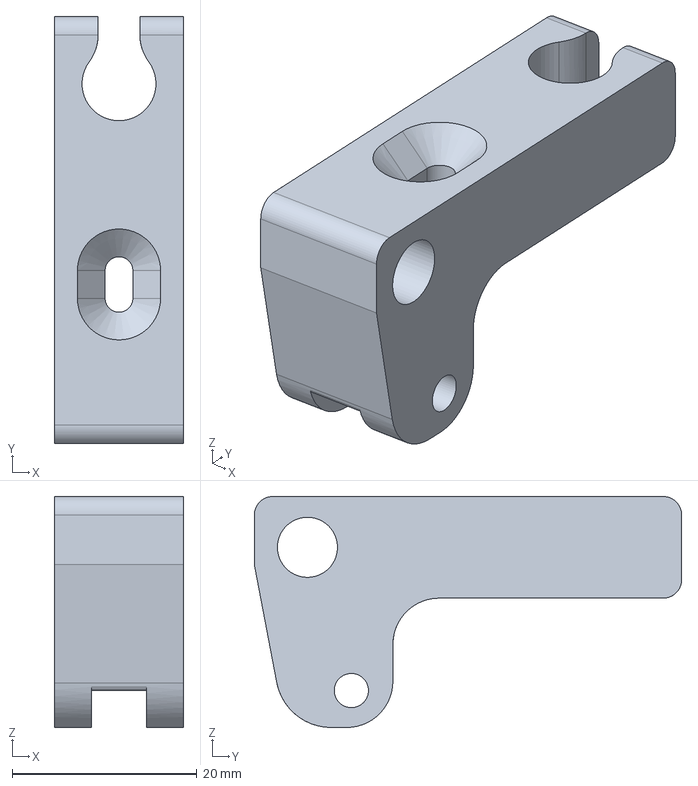
[picture p110: CAD file, 2026-11-06]
downloads/printed-parts/parts/E-AXIS-IDLER.step
14.0 x 46.3 x 25.0 mm
