jeottesen/e3d-big-box-manual-rebuild/downloads/printed-parts/parts/SPINE-Y.step

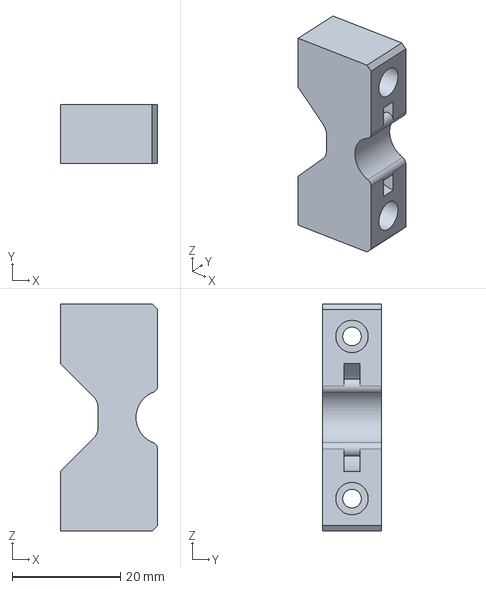
[picture p111: CAD file, 2026-11-06]
downloads/printed-parts/parts/SPINE-Y.step
18.0 x 11.0 x 42.0 mm
