jeottesen/e3d-big-box-manual-rebuild/downloads/printed-parts/parts/SPOOL-HOLDER-CLAMP-OUTER.step

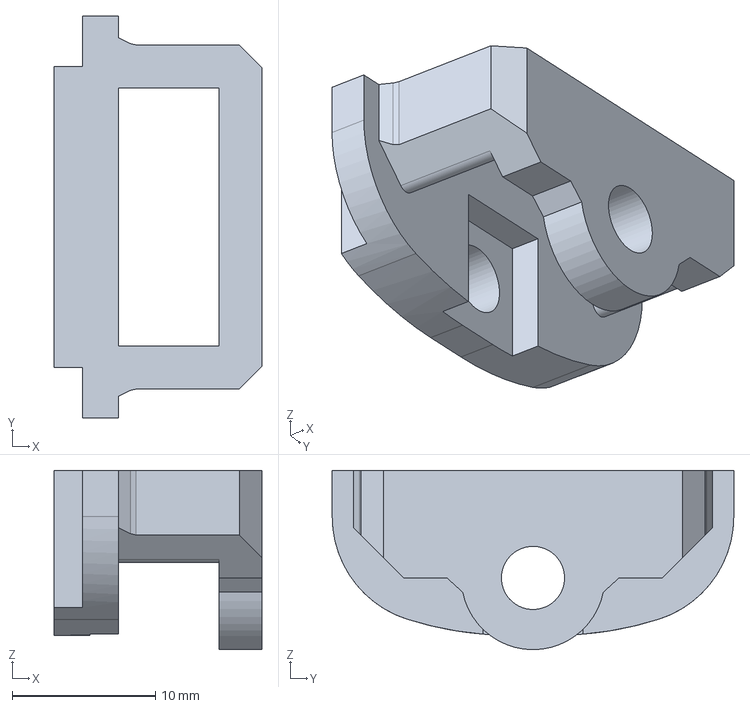
[picture p112: CAD file, 2026-11-06]
downloads/printed-parts/parts/SPOOL-HOLDER-CLAMP-OUTER.step
14.5 x 28.0 x 12.5 mm
