jeottesen/e3d-big-box-manual-rebuild/downloads/printed-parts/parts/Y-Axis-Endstop.step

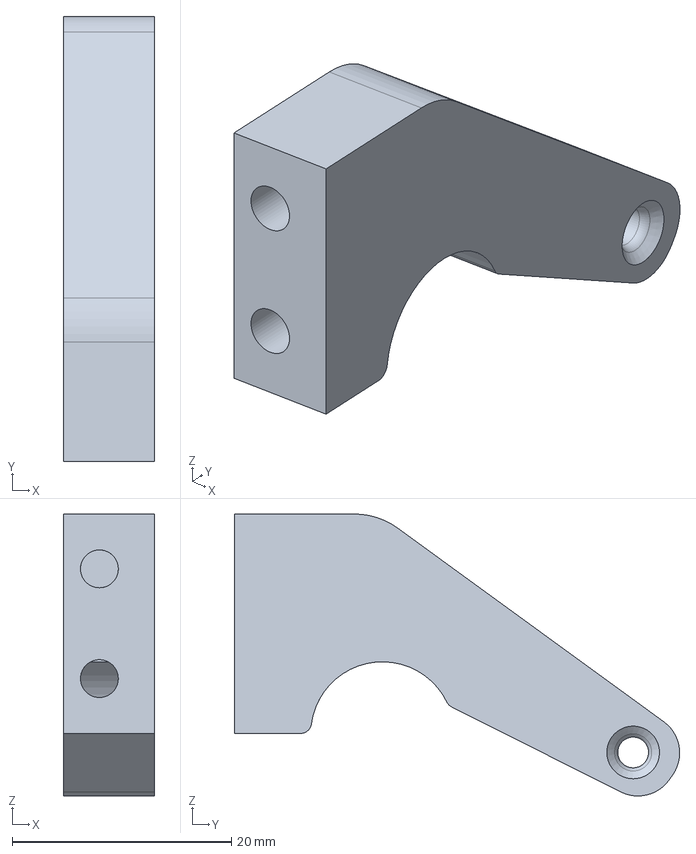
[picture p113: CAD file, 2026-11-06]
downloads/printed-parts/parts/Y-Axis-Endstop.step
8.25 x 40.6 x 25.7 mm
