jeottesen/e3d-big-box-manual-rebuild/downloads/printed-parts/parts/RRB-CABLE-CONDUIT.step

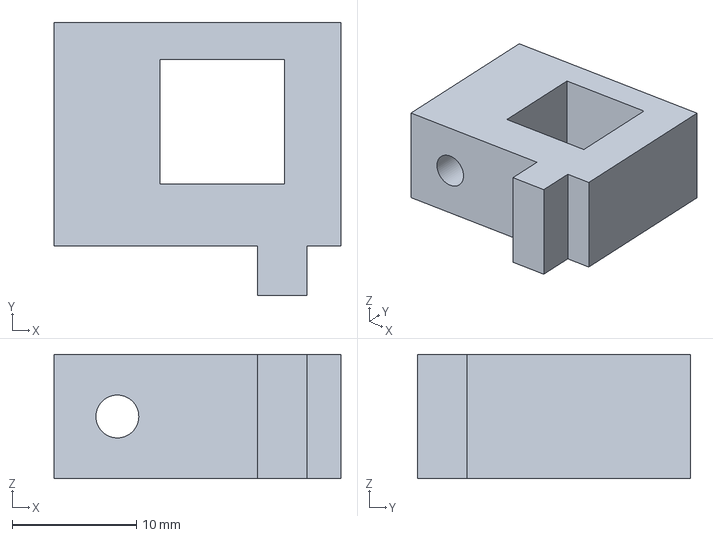
[picture p114: CAD file, 2026-11-06]
downloads/printed-parts/parts/RRB-CABLE-CONDUIT.step
23.1 x 22.0 x 10.0 mm
