jeottesen/e3d-big-box-manual-rebuild/(list of files, cad)

Other CAD files:
downloads/printed-parts/parts/Z-AXIS-BASE-BRACKET-UPPER-4-hole.step
downloads/printed-parts/parts/Z-AXIS-BASE-BRACKET-LOWER.step
downloads/printed-parts/parts/Z-AXIS-BASE-BRACKET-UPPER.step
downloads/printed-parts/parts/SPOOL-HOLDER-OUTER-L.step
downloads/printed-parts/parts/E-AXIS-CABLE-BRACKET-DUAL-L.step
downloads/printed-parts/parts/Top-Camera-Bracket.step
downloads/printed-parts/parts/Y-AXIS-REAR-L.step
downloads/printed-parts/parts/X-AXIS-CARRIAGE-BEARING-CLAMP__dual.step
downloads/printed-parts/parts/BB-FRAME-M3-NUT-TRAP-1.step
