jeottesen/e3d-big-box-manual-rebuild/manual/README.md

# BigBox 3D Printer Manual

Offline copy compiled from the Wayback Machine capture of wiki.e3d-online.com.

- [BigBox Build Manual](BigBox_Build_Manual.md)
- [BigBox Firmware Flashing Guide](BigBox_Firmware_Flashing_Guide.md)
- [BigBox OctoPrint Upgrade](BigBox_OctoPrint_Upgrade.md)
- [BigBox Parts Preparation](BigBox_Parts_Preparation.md)
- [BigBox Pre-Build](BigBox_Pre-Build.md)
- [BigBox Printer Sub-assemblies](BigBox_Printer_Sub-assemblies.md)
- [BigBox Software](BigBox_Software.md)
- [BigBox Version Overview](BigBox_Version_Overview.md)
- [Bill Of Materials](Bill_Of_Materials.md)
- [Exploded Drawings](Exploded_Drawings.md)
- [Dual Direct-Drive Extruders](Dual_Direct-Drive_Extruders.md)
- [Dual Direct-Drive Printhead Assembly](Dual_Direct-Drive_Printhead_Assembly.md)
- [Dual Extruders](Dual_Extruders.md)
- [Fixings Errors List](Fixings_Errors_List.md)
- [Print Cooling Fan](Print_Cooling_Fan.md)
- [Printer Commissioning](Printer_Commissioning.md)
- [Printer main assemblies: Step By Step Assembly Process](Printer_main_assemblies_Step_By_Step_Assembly_Process.md)
- [Pro & Lite X-Carriage](Pro_%26_Lite_X-Carriage.md)
- [Single Direct-Drive Extruder](Single_Direct-Drive_Extruder.md)
- [Single Direct-Drive Printhead Assembly](Single_Direct-Drive_Printhead_Assembly.md)
- [Titan Assembly](Titan_Assembly.md)
- [Your First Print](Your_First_Print.md)
- [Dual X-Carriage](Dual_X-Carriage.md)
- [Non-Titan Idler Arms](Non-Titan_Idler_Arms.md)
- [Single & Dual Direct-Drive IR Sensor Bracket](Single_%26_Dual_Direct-Drive_IR_Sensor_Bracket.md)
- [Single Direct-Drive X-Carriage](Single_Direct-Drive_X-Carriage.md)
- [Dual Direct-Drive X-Carriage](Dual_Direct-Drive_X-Carriage.md)
- [Mesh Levelling the Non-Hybrid Dual](Mesh_Levelling_the_Non-Hybrid_Dual.md)
- [Non-Hybrid Dual Calibrating Z Offset](Non-Hybrid_Dual_Calibrating_Z_Offset.md)
- [Older Version Content](Older_Version_Content.md)
- [Datasheets](Datasheets.md)
- [Downloads](Downloads.md)

The original wiki showed a notice on its pages from 2019 onward saying it was no longer maintained and pointing to e3d-online.dozuki.com. That notice is left out here. The Dozuki site could not be reached when this copy was compiled, and the archived copy that was checked contained no BigBox guides.
