jeottesen/e3d-big-box-manual-rebuild/manual/Downloads.md

# Downloads

**Contents**

- [Simplify3D profiles](#simplify3d-profiles)
- [Firmware](#firmware)
- [SD card files](#sd-card-files)
- [Printed parts (STEP files)](#printed-parts-step-files)
- [Archived copies from the old E3D file server](#archived-copies-from-the-old-e3d-file-server)
- [Still missing](#still-missing)

Files the wiki linked to that are no longer on the wiki, and where to find them now. They are linked, not copied (most of these repositories have no licence), except the exploded drawings PDF, which is included here under the same terms as the rest of the archived material. Checked against the repositories on 2026-10-29.

## Simplify3D profiles

The Software page offered Simplify3D profiles, but the files were hosted on the wiki and are gone. The BigBox repository has profiles, and a community repository has a second set whose settings follow the material, quality and extruder you choose. The original profiles, including the experimental dual one, are under "Archived copies from the old E3D file server" below.

- [BigBox Pro.fff](https://github.com/BigBox3D/Simplify3D/blob/master/BigBox%20Pro.fff) – BigBox3D/Simplify3D
- [BigBox Dual.fff](https://github.com/BigBox3D/Simplify3D/blob/master/BigBox%20Dual.fff) – BigBox3D/Simplify3D
- [BigBox Hybrid-Pro.fff](https://github.com/BigBox3D/Simplify3D/blob/master/BigBox%20Hybrid-Pro.fff) – BigBox3D/Simplify3D
- [BigBox Hybrid-Dual.fff](https://github.com/BigBox3D/Simplify3D/blob/master/BigBox%20Hybrid-Dual.fff) – BigBox3D/Simplify3D
- [BigBox Print Farm.fff](https://github.com/BigBox3D/Simplify3D/blob/master/BigBox%20Print%20Farm.fff) – BigBox3D/Simplify3D
- [BigBox-Settings: README](https://github.com/Alex9779/BigBox-Settings/blob/master/README.md) – Alex9779/BigBox-Settings; explains the profiles
- [BigBox Pro.fff](https://github.com/Alex9779/BigBox-Settings/blob/master/Pro/Simplify3D/BigBox%20Pro.fff) – Alex9779/BigBox-Settings
- [BigBox Dual.fff](https://github.com/Alex9779/BigBox-Settings/blob/master/Dual/Simplify3D/BigBox%20Dual.fff) – Alex9779/BigBox-Settings
- [BigBox Hybrid-Pro.fff](https://github.com/Alex9779/BigBox-Settings/blob/master/Hybrid-Pro/Simplify3D/BigBox%20Hybrid-Pro.fff) – Alex9779/BigBox-Settings
- [BigBox Hybrid-Dual.fff](https://github.com/Alex9779/BigBox-Settings/blob/master/Hybrid-Dual/Simplify3D/BigBox%20Hybrid-Dual.fff) – Alex9779/BigBox-Settings
- [BigBox Hybrid-Dual Mirrored.fff](https://github.com/Alex9779/BigBox-Settings/blob/master/Hybrid-Dual/Simplify3D/BigBox%20Hybrid-Dual%20Mirrored.fff) – Alex9779/BigBox-Settings
- [BigBox Dual Titan.fff](https://github.com/Alex9779/BigBox-Settings/blob/master/Dual%20Titan/Simplify3D/BigBox%20Dual%20Titan.fff) – Alex9779/BigBox-Settings
- [BigBoxBedAssembly.stl](https://github.com/Alex9779/BigBox-Settings/blob/master/BigBoxBedAssembly.stl) – a model of the BigBox bed for Simplify3D; Alex9779/BigBox-Settings

## Firmware

Precompiled Marlin builds for each BigBox version, from the BigBox firmware repository. The mesh bed levelling builds need the IR sensor moved to the heated bed.

- [marlin_direct_dual.hex](https://github.com/BigBox3D/Firmware/blob/master/marlin_direct_dual.hex) – BigBox v1.0 Dual (Direct Dual), Kickstarter
- [marlin_direct_pro.hex](https://github.com/BigBox3D/Firmware/blob/master/marlin_direct_pro.hex) – BigBox v1.0 Pro (Direct Pro), Kickstarter
- [marlin_hybrid_dual.hex](https://github.com/BigBox3D/Firmware/blob/master/marlin_hybrid_dual.hex) – BigBox v1.1 Dual Hybrid (Titan and non-Titan), auto bed levelling
- [marlin_hybrid_pro.hex](https://github.com/BigBox3D/Firmware/blob/master/marlin_hybrid_pro.hex) – BigBox v1.1 Pro Hybrid (Titan and non-Titan), auto bed levelling
- [marlin_hybrid_dual_mesh.hex](https://github.com/BigBox3D/Firmware/blob/master/marlin_hybrid_dual_mesh.hex) – BigBox v1.1 Dual Hybrid, mesh bed levelling
- [marlin_hybrid_pro_mesh.hex](https://github.com/BigBox3D/Firmware/blob/master/marlin_hybrid_pro_mesh.hex) – BigBox v1.1 Pro Hybrid, mesh bed levelling
- [Firmware README](https://github.com/BigBox3D/Firmware/blob/master/README.md) – which file is for which version, and how to flash it
- [BigBox Marlin source](https://github.com/BigBox3D/Marlin) – one branch per BigBox version (GPL v3)

## SD card files

The files that came on the SD card in the kit.

- [3DBenchy.stl](https://github.com/BigBox3D/SD-Card/blob/master/3DBenchy.stl) – BigBox3D/SD-Card
- [Pro/3DBenchy.gcode](https://github.com/BigBox3D/SD-Card/blob/master/Pro/3DBenchy.gcode) – sliced for the Pro
- [Dual/3DBenchy.gcode](https://github.com/BigBox3D/SD-Card/blob/master/Dual/3DBenchy.gcode) – sliced for the Dual
- [Pro/calibration/extruder_0.gcode](https://github.com/BigBox3D/SD-Card/blob/master/Pro/calibration/extruder_0.gcode)
- [Dual/calibration/extruder_0.gcode](https://github.com/BigBox3D/SD-Card/blob/master/Dual/calibration/extruder_0.gcode)
- [Dual/calibration/extruder_1.gcode](https://github.com/BigBox3D/SD-Card/blob/master/Dual/calibration/extruder_1.gcode)

## Printed parts (STEP files)

One STEP file for each printed part, named after its Bill of Materials row and linked from it. Each is one solid in its own frame, moved so its bounding box sits on the origin and never rotated, so a slicer can open it directly. They were cut from the original BigBox CAD assemblies listed below, which are not stored here. The designs are by Bigbox3DP (E3D) on Thingiverse, thing 1521722. The right-hand SPOOL-HOLDER OUTER (R) was made by mirroring (L), which the originals hold once.

- [parts.csv](../downloads/printed-parts/parts.csv) – one row per file: Bill of Materials name, quantity, manual section, source assembly and part, size, volume and SHA-256
- [SHA256SUMS](../downloads/printed-parts/SHA256SUMS) – check the files with sha256sum -c SHA256SUMS in downloads/printed-parts
- [bigbox_v1.1.0.stp (source assembly)](https://www.thingiverse.com/thing:1521722) – BigBox v1.1: 54 of the parts
- [Hybrid_v1.1.0.stp (source assembly)](https://www.thingiverse.com/thing:1521722) – BigBox v1.1 Hybrid: 10 of the parts
- [bigbox_dual_v1.0.0.stp (source assembly)](https://www.thingiverse.com/thing:1521722) – BigBox v1.0 Dual: 7 of the parts
- [BB_FRAME_M3_NUT_TRAP.stp (source assembly)](https://www.thingiverse.com/thing:1521722) – the frame nut trap: 1 part
- [Thingiverse page, archived copy of 2016-12-04](https://web.archive.org/web/20161204111516/http://www.thingiverse.com/thing:1521722) – the page the files are from; it offers STEP.zip

## Archived copies from the old E3D file server

The wiki's own file server (files.e3d-online.com) is gone, but the Wayback Machine kept these. The links go to the archived copies.

- [bigbox_pro.fff](https://web.archive.org/web/20160831005447/http://files.e3d-online.com/BigBox/Slicer%20Configs/Simplify3D/bigbox_pro.fff) – Simplify3D profile for the Pro
- [bigbox_dual.fff](https://web.archive.org/web/20160531182702/http://files.e3d-online.com/BigBox/Slicer%20Configs/Simplify3D/bigbox_dual.fff) – Simplify3D profile for the Dual
- [bigbox_dual_experimental.fff](https://web.archive.org/web/20160831005324/http://files.e3d-online.com/BigBox/Slicer%20Configs/Simplify3D/bigbox_dual_experimental.fff) – the experimental dual-extruder Simplify3D profile described in the appendix
- [bigbox_hybrid.fff](https://web.archive.org/web/20160831005610/http://files.e3d-online.com/BigBox/Slicer%20Configs/Simplify3D/bigbox_hybrid.fff) – Simplify3D profile for the Hybrid
- [bigbox_1.1.fff](https://web.archive.org/web/20160831005209/http://files.e3d-online.com/BigBox/Slicer%20Configs/Simplify3D/bigbox_1.1.fff) – Simplify3D profile for BigBox 1.1
- [BigBox_Slic3r_config_bundle.ini](https://web.archive.org/web/20160422181925/http://files.e3d-online.com/BigBox/Slicer%20Configs/Slic3r/BigBox_Slic3r_config_bundle.ini) – Slic3r configuration bundle
- [BigBox_Cura_0.10.ini](https://web.archive.org/web/20160519153237/http://files.e3d-online.com/BigBox/Slicer%20Configs/Cura/BigBox_Cura_0.10.ini) – Cura configuration, 0.10 layer height
- [BigBox_Cura_0.20.ini](https://web.archive.org/web/20160519153242/http://files.e3d-online.com/BigBox/Slicer%20Configs/Cura/BigBox_Cura_0.20.ini) – Cura configuration, 0.20 layer height
- [BigBox_Cura_0.25.ini](https://web.archive.org/web/20160519152959/http://files.e3d-online.com/BigBox/Slicer%20Configs/Cura/BigBox_Cura_0.25.ini) – Cura configuration, 0.25 layer height
- [EXPLODED_DRAWINGS.pdf](../docs/files/EXPLODED_DRAWINGS.pdf) – BigBox exploded drawings; this repository holds a copy of the file the archive saved on 2016-01-09
- [Titan_Assembly_Supplementary.pdf](https://web.archive.org/web/20160527143731/http://files.e3d-online.com/Titan/Titan_Assembly_Supplementary.pdf) – Titan assembly supplementary instructions (the wiki linked it with spaces in the name)
- [ASM_EX_THUMB_SCREW.stp](https://web.archive.org/web/20170910104341/http://files.e3d-online.com/Titan/ASM_EX_THUMB_SCREW.stp) – Titan thumb screw CAD model
- [ASM_EX_AERO_285.stl](https://web.archive.org/web/20171114074932/http://files.e3d-online.com/Titan/ASM_EX_AERO_285.stl) – Titan Aero 2.85 mm model

## Still missing

Not in the repositories above, and not kept by the Wayback Machine.

- BigBox_Fixings.pdf – the fixings list linked from the Bill of Materials (it was on Dropbox; the archive has only a capture of the error page)
- BRACKET_PRINTED.pdf – the Titan mounting bracket engineering drawing linked from Titan Assembly (it was on files.e3d-online.com)
- BigBoxSingle-alpha-settings.fff – the early alpha Simplify3D profile (it was on Dropbox)
- ASM_EX_THUMB_SCREW.stl – the Titan thumb screw model linked from Titan Assembly; the archive has the .stp version above but not this file
