jeottesen/e3d-big-box-manual-rebuild/manual/BigBox_Build_Manual.md

# BigBox Build Manual

Archived 20200803120509 · source: wiki.e3d-online.com/wiki/BigBox_Build_Manual · [archive link](https://web.archive.org/web/20200803120509/https://wiki.e3d-online.com/BigBox_Build_Manual)

**Contents**

- [Introduction](#introduction)
- [BigBox Versions Overview](#bigbox-versions-overview)
- [Design Files - Plans & Parts List](#design-files---plans--parts-list)
- [BigBox Pre-Build](#bigbox-pre-build)
- [BigBox Parts Preparation](#bigbox-parts-preparation)
- [BigBox Printer Sub-assemblies](#bigbox-printer-sub-assemblies)
- [Printer main assemblies: Step By Step Assembly Process](#printer-main-assemblies-step-by-step-assembly-process)
- [Printer Commissioning](#printer-commissioning)
- [Your First Print](#your-first-print)
- [BigBox OctoPrint Upgrade](#bigbox-octoprint-upgrade)
- [BigBox Support](#bigbox-support)
- [BigBox Software](#bigbox-software)
- [BigBox Community Generated Help & Guides](#bigbox-community-generated-help--guides)
- [BigBox printer projects](#bigbox-printer-projects)
- [Appendix](#appendix)



## Introduction

Please read the [BigBox Pre-Build](BigBox_Pre-Build.md "BigBox Pre-Build") section before beginning to work on your BigBox. It contains important information about how to assemble your printer, a list of all the fixings with bag numbers and tools you will need.

If you have a Factory Assembled BigBox you can skip straight to [Your First Print](Your_First_Print.md "Your First Print")!

## [BigBox Versions Overview](BigBox_Version_Overview.md "BigBox Version Overview")

- [E3D supported versions](BigBox_Version_Overview.md#e3d-supported-versions)
  - BigBox Pro
  - BigBox Dual
  - BigBox Pro Hybrid Titan
  - BigBox Dual Hybrid Titan
- [Derived versions](BigBox_Version_Overview.md#derived-versions)
  - BigBox Pro Hybrid
  - BigBox Dual Hybrid
- [Special (community built) versions](BigBox_Version_Overview.md#special-community-built-versions)
  - BigBox Dual Hybrid Titan Mirrored
- [Remarks](BigBox_Version_Overview.md#remarks)
  - Kickstarter upgrade to Hybrid/V1.1
- [Where next?](BigBox_Version_Overview.md#where-next)

## Design Files - Plans & Parts List

The BigBox Design Files are available from Thingiverse at \| [https://www.thingiverse.com/thing:1521722](https://www.thingiverse.com/thing:1521722)

## [BigBox Pre-Build](BigBox_Pre-Build.md "BigBox Pre-Build")

- [What’s In the Box](BigBox_Pre-Build.md#whats-in-the-box)
- [Preparation](BigBox_Pre-Build.md#preparation)
- [Tools required](BigBox_Pre-Build.md#tools-required)
- [Recommended tools](BigBox_Pre-Build.md#recommended-tools)
- [Consumables](BigBox_Pre-Build.md#consumables)
- [Estimated Build Time](BigBox_Pre-Build.md#estimated-build-time)
- [Health & Safety](BigBox_Pre-Build.md#health--safety)
- [Terminology](BigBox_Pre-Build.md#terminology)
- [Tips & tricks](BigBox_Pre-Build.md#tips--tricks)
- [Nut-Traps](BigBox_Pre-Build.md#nut-traps)
- [Hex-Half Nuts in Engraved Frame Holes](BigBox_Pre-Build.md#hex-half-nuts-in-engraved-frame-holes)
- [Where next?](BigBox_Pre-Build.md#where-next)

## [BigBox Parts Preparation](BigBox_Parts_Preparation.md "BigBox Parts Preparation")

- [(1) Y-Axis Rear Brackets (Left & Right)](BigBox_Parts_Preparation.md#1-y-axis-rear-brackets-left--right)
- [(2) Y-Axis Front Brackets (Left & Right)](BigBox_Parts_Preparation.md#2-y-axis-front-brackets-left--right)
- [(3) Y-Axis Belt Idlers](BigBox_Parts_Preparation.md#3-y-axis-belt-idlers)
- [(4) Non-Titan Single & Dual Extruder Filament Idlers](BigBox_Parts_Preparation.md#4-non-titan-single--dual-extruder-filament-idlers)
- [(5) X-Axis Idler Carriage](BigBox_Parts_Preparation.md#5-x-axis-idler-carriage)
- [(6) X-Axis Motor Mount](BigBox_Parts_Preparation.md#6-x-axis-motor-mount)
- [(7) Pro & Lite X-Carriage](BigBox_Parts_Preparation.md#7-pro--lite-x-carriage)
- [(8) Dual X-Carriage](BigBox_Parts_Preparation.md#8-dual-x-carriage)
- [(9) Hybrid X-Carriage](BigBox_Parts_Preparation.md#9-hybrid-x-carriage)
- [(10) Heated Bed Corners](BigBox_Parts_Preparation.md#10-heated-bed-corners)
- [(11) Outer Spools Rear (Left & Right)](BigBox_Parts_Preparation.md#11-outer-spools-rear-left--right)
- [(12) Spool Holder Outer Fronts](BigBox_Parts_Preparation.md#12-spool-holder-outer-fronts)
- [(13) Print Cooling Fan (v1.0)](BigBox_Parts_Preparation.md#13-print-cooling-fan-v10)
- [(14) Y-Axis Motor Mount](BigBox_Parts_Preparation.md#14-y-axis-motor-mount)
- [(15) Single & Dual Direct-Drive IR Sensor Bracket](BigBox_Parts_Preparation.md#15-single--dual-direct-drive-ir-sensor-bracket)
- [(16) Hybrid IR Sensor Bracket](BigBox_Parts_Preparation.md#16-hybrid-ir-sensor-bracket)
- [(17) Spool Carrier Clamp](BigBox_Parts_Preparation.md#17-spool-carrier-clamp)
- [(18) Z-Axis Drag Chain Anchors](BigBox_Parts_Preparation.md#18-z-axis-drag-chain-anchors)
- [(19) IEC Socket](BigBox_Parts_Preparation.md#19-iec-socket)
- [Where next?](BigBox_Parts_Preparation.md#where-next)

## [BigBox Printer Sub-assemblies](BigBox_Printer_Sub-assemblies.md "BigBox Printer Sub-assemblies")

- [(1) Single Direct-Drive Extruder](BigBox_Printer_Sub-assemblies.md#1-single-direct-drive-extruder)
- [(2) Dual Direct-Drive Extruders](BigBox_Printer_Sub-assemblies.md#2-dual-direct-drive-extruders)
- [(3) Hybrid Titan Extruder (Direct)](BigBox_Printer_Sub-assemblies.md#3-hybrid-titan-extruder-direct)
- [(4) Hybrid Titan Extruder (Bowden)](BigBox_Printer_Sub-assemblies.md#4-hybrid-titan-extruder-bowden)
- [(5) Hybrid Non-Titan Extruder (Direct)](BigBox_Printer_Sub-assemblies.md#5-hybrid-non-titan-extruder-direct)
- [(6) Hybrid Non-Titan Extruder (Bowden)](BigBox_Printer_Sub-assemblies.md#6-hybrid-non-titan-extruder-bowden)
- [(7) X-Axis Assembly](BigBox_Printer_Sub-assemblies.md#7-x-axis-assembly)
- [(8) Electronics Cover](BigBox_Printer_Sub-assemblies.md#8-electronics-cover)
- [(9) Spool Carrier](BigBox_Printer_Sub-assemblies.md#9-spool-carrier)
- [(10) Z-Axis Bed Assembly](BigBox_Printer_Sub-assemblies.md#10-z-axis-bed-assembly)
- [(11) Z-Axis Drag Chain Assembly](BigBox_Printer_Sub-assemblies.md#11-z-axis-drag-chain-assembly)
- [(12) Base Assembly](BigBox_Printer_Sub-assemblies.md#12-base-assembly)
- [(13) Frame Assembly](BigBox_Printer_Sub-assemblies.md#13-frame-assembly)
- [Where next?](BigBox_Printer_Sub-assemblies.md#where-next)

## [Printer main assemblies: Step By Step Assembly Process](Printer_main_assemblies_Step_By_Step_Assembly_Process.md "Printer main assemblies: Step By Step Assembly Process")

- [(1) Y-Axis Rear-Bar Assembly](Printer_main_assemblies_Step_By_Step_Assembly_Process.md#1-y-axis-rear-bar-assembly)
- [(2) Y-Axis Rear-Bar Installation](Printer_main_assemblies_Step_By_Step_Assembly_Process.md#2-y-axis-rear-bar-installation)
- [(3) X-Axis & Y-Axis Assembly](Printer_main_assemblies_Step_By_Step_Assembly_Process.md#3-x-axis--y-axis-assembly)
- [(4) X-Axis & Y-Axis Installation](Printer_main_assemblies_Step_By_Step_Assembly_Process.md#4-x-axis--y-axis-installation)
- [(5) X-Axis Motor Installation](Printer_main_assemblies_Step_By_Step_Assembly_Process.md#5-x-axis-motor-installation)
- [(6) Single Direct-Drive X-Carriage](Printer_main_assemblies_Step_By_Step_Assembly_Process.md#6-single-direct-drive-x-carriage)
- [(7) Dual Direct-Drive X-Carriage](Printer_main_assemblies_Step_By_Step_Assembly_Process.md#7-dual-direct-drive-x-carriage)
- [(8) Hybrid X-Carriage](Printer_main_assemblies_Step_By_Step_Assembly_Process.md#8-hybrid-x-carriage)
- [(9) Y-Axis Endstop](Printer_main_assemblies_Step_By_Step_Assembly_Process.md#9-y-axis-endstop)
- [(10) Y-Axis Motor Install](Printer_main_assemblies_Step_By_Step_Assembly_Process.md#10-y-axis-motor-install)
- [(11) Y-Axis Belts](Printer_main_assemblies_Step_By_Step_Assembly_Process.md#11-y-axis-belts)
- [(12) X-Axis Cable Conduits](Printer_main_assemblies_Step_By_Step_Assembly_Process.md#12-x-axis-cable-conduits)
- [(13) X-Axis Drag Chain](Printer_main_assemblies_Step_By_Step_Assembly_Process.md#13-x-axis-drag-chain)
- [(14) Frame Top](Printer_main_assemblies_Step_By_Step_Assembly_Process.md#14-frame-top)
- [(15) Spool Holder Brackets](Printer_main_assemblies_Step_By_Step_Assembly_Process.md#15-spool-holder-brackets)
- [(16) Cable Spine](Printer_main_assemblies_Step_By_Step_Assembly_Process.md#16-cable-spine)
- [(17) Frame Ancillaries](Printer_main_assemblies_Step_By_Step_Assembly_Process.md#17-frame-ancillaries)
- [(18) Control Connection](Printer_main_assemblies_Step_By_Step_Assembly_Process.md#18-control-connection)
- [(19) Single Direct-Drive Printhead Assembly](Printer_main_assemblies_Step_By_Step_Assembly_Process.md#19-single-direct-drive-printhead-assembly)
- [(20) Dual Direct-Drive Printhead Assembly](Printer_main_assemblies_Step_By_Step_Assembly_Process.md#20-dual-direct-drive-printhead-assembly)
- [(21) Hybrid Printhead Assembly](Printer_main_assemblies_Step_By_Step_Assembly_Process.md#21-hybrid-printhead-assembly)
- [(22) OctoPrint Upgrade Camera Install](Printer_main_assemblies_Step_By_Step_Assembly_Process.md#22-octoprint-upgrade-camera-install)
- [(23) Prepping The Wiring](Printer_main_assemblies_Step_By_Step_Assembly_Process.md#23-prepping-the-wiring)
- [(24) Fitting The Base](Printer_main_assemblies_Step_By_Step_Assembly_Process.md#24-fitting-the-base)
- [(25) Wiring](Printer_main_assemblies_Step_By_Step_Assembly_Process.md#25-wiring)
- [(26) Power-On Test](Printer_main_assemblies_Step_By_Step_Assembly_Process.md#26-power-on-test)
- [(27) Tuning The Stepper Drivers](Printer_main_assemblies_Step_By_Step_Assembly_Process.md#27-tuning-the-stepper-drivers)
- [(28) Closing Up the Base](Printer_main_assemblies_Step_By_Step_Assembly_Process.md#28-closing-up-the-base)
- [(29) Y-Axis Frame Endstop](Printer_main_assemblies_Step_By_Step_Assembly_Process.md#29-y-axis-frame-endstop)
- [(30) Spool Carrier](Printer_main_assemblies_Step_By_Step_Assembly_Process.md#30-spool-carrier)
- [(31) Ooze Wiper & Dump Bucket](Printer_main_assemblies_Step_By_Step_Assembly_Process.md#31-ooze-wiper--dump-bucket)
- [(32) Z-Axis](Printer_main_assemblies_Step_By_Step_Assembly_Process.md#32-z-axis)
- [Where next?](Printer_main_assemblies_Step_By_Step_Assembly_Process.md#where-next)

## [Printer Commissioning](Printer_Commissioning.md "Printer Commissioning")

- [(1) Belts, Pulleys & Rods](Printer_Commissioning.md#1-belts-pulleys--rods)
- [(2) Glass Build Plate](Printer_Commissioning.md#2-glass-build-plate)
- [(3) Ooze Wiper Adjustment](Printer_Commissioning.md#3-ooze-wiper-adjustment)
- [(4) Homing](Printer_Commissioning.md#4-homing)
- [(5) Zero X & Y](Printer_Commissioning.md#5-zero-x--y)
- [(6) Z-Axis Calibration](Printer_Commissioning.md#6-z-axis-calibration)
- [(7) Tightening the HotEnd](Printer_Commissioning.md#7-tightening-the-hotend)
- [(8) Dual Nozzle Alignment](Printer_Commissioning.md#8-dual-nozzle-alignment)
- [(9) Bed levelling](Printer_Commissioning.md#9-bed-levelling)
- [(10) The Finishing Touches](Printer_Commissioning.md#10-the-finishing-touches)
- [Where next?](Printer_Commissioning.md#where-next)

## [Your First Print](Your_First_Print.md "Your First Print")

- [Loading Filament](Your_First_Print.md#loading-filament)
- [Calibrating The Filament](Your_First_Print.md#calibrating-the-filament)
- [Printing](Your_First_Print.md#printing)
- [Where next?](Your_First_Print.md#where-next)

## [BigBox OctoPrint Upgrade](BigBox_OctoPrint_Upgrade.md "BigBox OctoPrint Upgrade")

- [Prepping the SD Card](BigBox_OctoPrint_Upgrade.md#prepping-the-sd-card)
- [Terminal Configuration](BigBox_OctoPrint_Upgrade.md#terminal-configuration)
- [Login Options & Update](BigBox_OctoPrint_Upgrade.md#login-options--update)
- [Settings](BigBox_OctoPrint_Upgrade.md#settings)
- [Plugins](BigBox_OctoPrint_Upgrade.md#plugins)
- [Printing](BigBox_OctoPrint_Upgrade.md#printing)
- [Where Next?](BigBox_OctoPrint_Upgrade.md#where-next)

## BigBox Support

The best place to go for further help and advice is the BigBox forum *(dead link)*.

## [BigBox Software](BigBox_Software.md "BigBox Software")

- [Marlin](BigBox_Software.md#marlin)
- [BigBox Slicer Profiles](BigBox_Software.md#bigbox-slicer-profiles)
- [OctoPrint](BigBox_Software.md#octoprint)
- [Where next?](BigBox_Software.md#where-next)

The BigBox software tool-chain.

## BigBox Community Generated Help & Guides

**BigBox Forum \| Guides, Mods, and Upgrades** *(dead link; [archived copy](https://web.archive.org/web/20160622040336/http://forum.e3d-online.com/index.php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))* *(A huge collection of help, tips and tricks).*

Livi's BigBox Pre-Build Guide *(dead link)*

[Livi's MLP Edition Exploded Diagrams](https://www.dropbox.com/s/zlaknl7vw509144/BigBox%20Updated%20Pictures.zip?dl=0) *(Note some may be out of date, but they are still a great reference).*

[John's 3D Build & Printing Tools](https://plus.google.com/+JohnEsc/posts/9tea8wS1qoa)

Liam's Printed Parts Check-List *(dead link)*

Shao's BigBox Dual Build Log *(dead link)*

Using platformio to flash firmware from RPi *(dead link)*

## BigBox printer projects

**[Picture](http://www.instructables.com/id/Picture-The-3D-Printed-Raspberry-Pi-Camera/)** - A digital camera powered by the Raspberry Pi and designed to be 3D printed with a BigBox!

**[Handled Drills (Hole Reamers)](https://www.thingiverse.com/thing:1387197)** - Sometimes an electric drill is simply too powerful for delicate parts. The answer is a handle for your drill bits!

## Appendix

- [Exploded Drawings](Exploded_Drawings.md) – every assembly drawing in one place, each with its parts list and the steps of the manual that show it
- [Bill of Materials](Bill_Of_Materials.md) – the parts, with the printed parts and fixings compiled from the exploded drawings
- [Datasheets](Datasheets.md) – the PDF datasheets and drawings the wiki hosted for the hotend, the motors and the fans
- [Downloads](Downloads.md) – where to find the files the wiki linked to that are gone: firmware, slicer profiles and models
- [Older Version Content](Older_Version_Content.md) – sections that were in older versions of the manual and were later removed
