jeottesen/e3d-big-box-manual-rebuild/manual/Pro_&_Lite_X-Carriage.md

# Pro & Lite X-Carriage

Archived 20160824110747 · source: wiki.e3d-online.com/wiki/Pro\_&\_Lite_X-Carriage · [archive link](https://web.archive.org/web/20160824110747/http://wiki.e3d-online.com:80/wiki/Pro_%26_Lite_X-Carriage)



*Drawn from sheet 7 of the exploded drawings PDF; the wiki's own copy of this image was not archived.*

\[image not archived: "Single_x_carriage.jpg" Caption: "BigBox Single Extruder X-Carriage."\]

By hand, run a 4mm drill bit through the centre hole.

Insert M4 x 20mm screws in at an angle but do not over tighten, they must not protrude into the 16mm hole where the HotEnd fits.

If they don't go in properly don't force them as they could cross thread. Take care to ensure screws are aligned.

Help pull the M4 Square Nuts into the four corners using M4 x 16mm screws.

**Note :** Use needle-nose pliers for pushing nuts in to awkward positions.

\[image not archived: "Single_incorrect.jpg" Caption: "Incorrectly Fitted."\]

It is recommended that you test fit the Extruder Heatsink in the X-Carriage.

Due to very close tolerances the Heatsink can be difficult to install.

You can use a needle-file or a small piece of sandpaper to gently smooth-out the hole.

**This photo shows an incorrectly fitted Heatsink.**

\[image not archived: "Single_correct.jpg" Caption: "Correctly Fitted."\]

When fitted correctly the Heatsink will sit flush with the X-Carriage.

**This photo shows a correctly fitted Heatsink.**\
