jeottesen/e3d-big-box-manual-rebuild/manual/Dual_X-Carriage.md

# Dual X-Carriage

Rebuilt page · source: wiki.e3d-online.com/wiki/Dual_X-Carriage · [archive link (parent page)](https://web.archive.org/web/20160807071206/http://wiki.e3d-online.com:80/wiki/BigBox_Parts_Preparation)

Recovered from an older version of BigBox Parts Preparation (20160807071206), section "(8) Dual X-Carriage" — the separate wiki page is not in the archive.

\[image not archived: "X-CARRIAGE_DUAL.JPG"\]

\[image not archived: "Dual_x_carriage_hotend.jpg" Caption: "Dual HotEnd Mount"\]

Run a 4mm drill bit through the centre holes and the 4mm holes on the corners.

**Before proceeding follow the steps shown above for the Pro & Lite X-Carriage and test-fitting the extruders into the holes.**

\[image not archived: "Dual_x_carriage_0.jpg" Caption: "O-Ring"\]

- 2 x Rubber O-Rings (Dual Extruder Box).

\[image not archived: "Dual_x_carriage_0_fitted.jpg" Caption: "O-Rings"\]

Insert the two rubber O-Rings into the Holes where the HotEnd Fits.

\[image not archived: "Dual_x_carriage_grubs.jpg" Caption: "Grubs & Nuts"\]

- 4 x M4 12mm Grubs Screws (Bag 14).
- 4 x M4 Square Nuts (Bag 12).

The four M4 Square nuts fit into the recesses through the holes which the HotEnds fit. The nuts go in at an angle, using a pair of needle-nose pliers can help during installation.

**Note :** If you are short of M4 12mm Grub Screws check the corrections bag inside the Stretch Box.

\[image not archived: "Dual_x_carriage_corners.jpg" Caption: "Nuts"\]

- 4 x M4 Square Nuts (Bag 12).

Fit the four nuts into the corner sockets. They can be pulled into place using an M4 16mm screw (Bag 14).

\[image not archived: "Dual_x_carriage_completed.jpg" Caption: "Finished"\]

- 8 x M3 Square Nuts (Bag 6).

Insert the M3 Square nuts into the Carriage. Use a pair of needle-nose pliers to ease fitment.\
