jeottesen/e3d-big-box-manual-rebuild/manual/Datasheets.md

# Datasheets

PDF datasheets and drawings that were hosted on the wiki and apply to BigBox parts (V6 hotend, stepper motors, fans). Volcano and heater-mat datasheets were left out as they are not BigBox parts.

- [V6-175-ASSM.pdf](../docs/files/V6-175-ASSM.pdf) — E3D V6 1.75 mm hotend, assembly drawing (archived 20170110, 107 KB; description inferred from the file name)
- [V6-175-BREAK.pdf](../docs/files/V6-175-BREAK.pdf) — E3D V6 1.75 mm heatbreak, drawing (archived 20201112, 129 KB; description inferred from the file name)
- [V6-175-SINK.pdf](../docs/files/V6-175-SINK.pdf) — E3D V6 1.75 mm heatsink, drawing (archived 20220405, 133 KB; description inferred from the file name)
- [V6-300-BREAK.pdf](../docs/files/V6-300-BREAK.pdf) — E3D V6 3.00 mm heatbreak, drawing (archived 20201111, 129 KB; description inferred from the file name)
- [V6-300-SINK-D.pdf](../docs/files/V6-300-SINK-D.pdf) — E3D V6 3.00 mm heatsink, drawing (archived 20211122, 133 KB; description inferred from the file name)
- [V6-BLOCK-CARTRIDGE.pdf](../docs/files/V6-BLOCK-CARTRIDGE.pdf) — E3D V6 heater block and heater cartridge, drawing (archived 20191015, 148 KB; description inferred from the file name)
- [V6-NOZZLE-ALL.pdf](../docs/files/V6-NOZZLE-ALL.pdf) — E3D V6 nozzles, drawing (archived 20220810, 142 KB; description inferred from the file name)
- [E-MOTOR-NEMA17-ALL_PUBLIC.pdf](../docs/files/E-MOTOR-NEMA17-ALL_PUBLIC.pdf) — NEMA17 stepper motor datasheet (archived 20240222, 147 KB; description inferred from the file name)
- [Motor-Datasheet-All.pdf](../docs/files/Motor-Datasheet-All.pdf) — Stepper motor datasheets (combined) (archived 20230416, 4520 KB; description inferred from the file name)
- [DC_Fans.pdf](../docs/files/DC_Fans.pdf) — DC fan datasheet (archived 20161019, 92 KB; description inferred from the file name)
