jeottesen/e3d-big-box-manual-rebuild/notes/history/SUMMARY.md

# Version changes per page

From the full-history run (see notes/README.md). Text-identical duplicate versions were left out, so each line is a real change in the article text. Dates are archive capture times (YYYYMMDDhhmmss).

## BigBox_Build_Manual

- versions: 20151225011832, 20160106203355, 20160119191318, 20160219012812, 20160313202154, 20160329123925, 20160519190054, 20160616135235, 20191022143926, 20200803120509
- 20151225011832 -> 20160106203355: +75 / -33 lines
- 20160106203355 -> 20160119191318: +62 / -51 lines
- 20160119191318 -> 20160219012812: +5 / -13 lines
- 20160219012812 -> 20160313202154: +12 / -20 lines
- 20160313202154 -> 20160329123925: +1 / -0 lines
- 20160329123925 -> 20160519190054: +14 / -11 lines
- 20160519190054 -> 20160616135235: +26 / -12 lines
- 20160616135235 -> 20191022143926: +3 / -0 lines
- 20191022143926 -> 20200803120509: text identical (layout/markup only)

## BigBox_Firmware_Flashing_Guide

- versions: 20160727062859, 20190723040004, 20201204013533
- 20160727062859 -> 20190723040004: +43 / -16 lines
- 20190723040004 -> 20201204013533: text identical (layout/markup only)

## BigBox_OctoPrint_Upgrade

- versions: 20160120094140, 20160224080850, 20160327021215, 20160427130511, 20190723040244, 20230529010658
- 20160120094140 -> 20160224080850: +2 / -2 lines
- 20160224080850 -> 20160327021215: +0 / -5 lines
- 20160327021215 -> 20160427130511: +9 / -0 lines
- 20160427130511 -> 20190723040244: +3 / -0 lines
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
- 20151230221140 -> 20160130224103: +168 / -7 lines
- 20160130224103 -> 20160401232202: +3 / -1 lines
- 20160401232202 -> 20160807072159: +9 / -0 lines
- 20160807072159 -> 20200127192243: +3 / -0 lines
- 20200127192243 -> 20201204013802: text identical (layout/markup only)
