jeottesen/e3d-big-box-manual-rebuild/docs/files/EXPLODED_DRAWINGS.pdf

## PARTS LIST

ITEM | QTY | PART NUMBER | DESCRIPTION

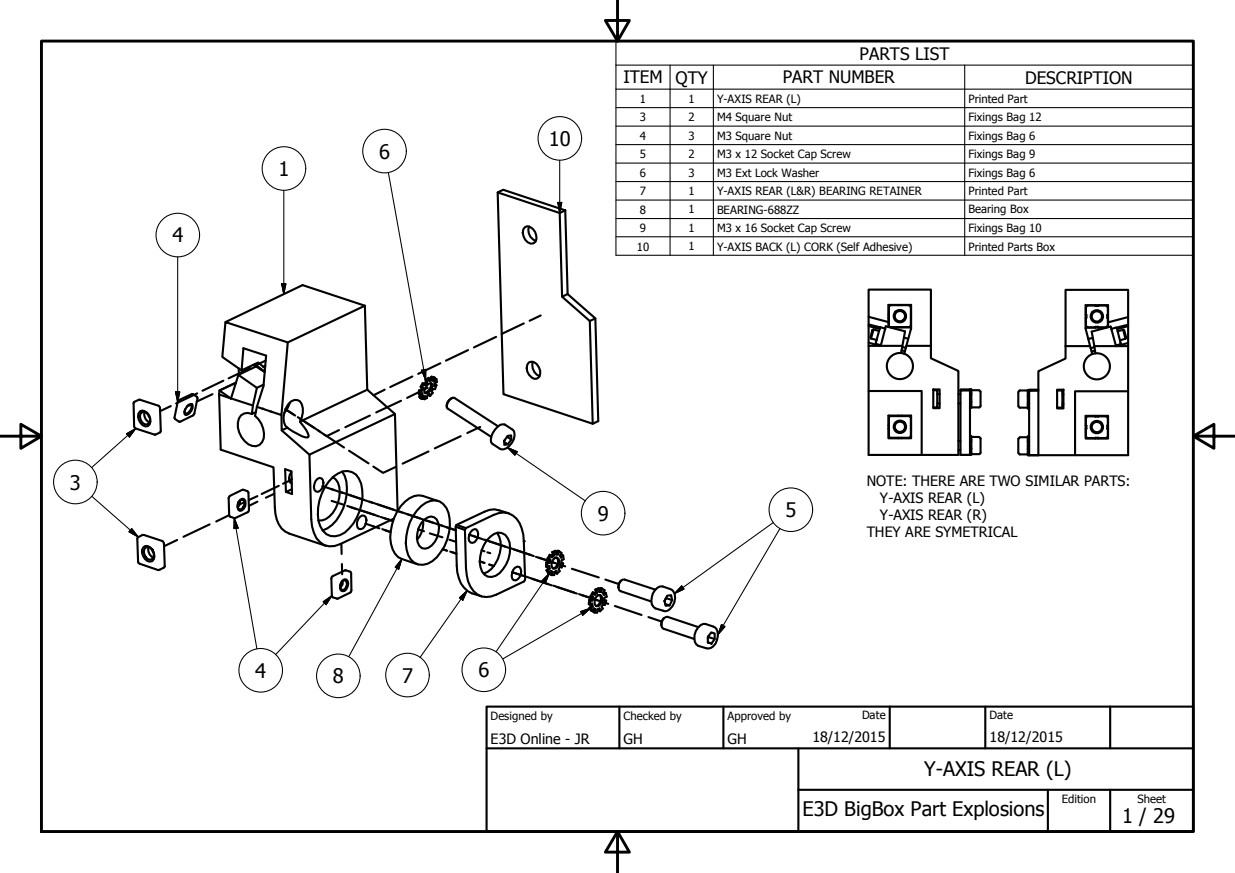
[picture p416: page 1]
Y-AXIS REAR (L); Printed Part; M4 Square Nut; Fixings Bag 12; M3 Square Nut; Fixings Bag 6; M3 x 12 Socket Cap Screw; Fixings Bag 9; M3 Ext Lock Washer; Y-AXIS REAR (L&R) BEARING RETAINER; BEARING-688ZZ; Bearing Box; M3 x 16 Socket Cap Screw; Fixings Bag 10; Y-AXIS BACK (L) CORK (Self Adhesive); Printed Parts Box; E3D Online - JR; Designed by; Checked by; Approved by; Date; Edition; Sheet

NOTE: THERE ARE TWO SIMILAR PARTS:
Y-AXIS REAR (L)
Y-AXIS REAR (R)
THEY ARE SYMETRICAL

E3D BigBox Part Explosions

ITEM | QTY | PART NUMBER | DESCRIPTION

5

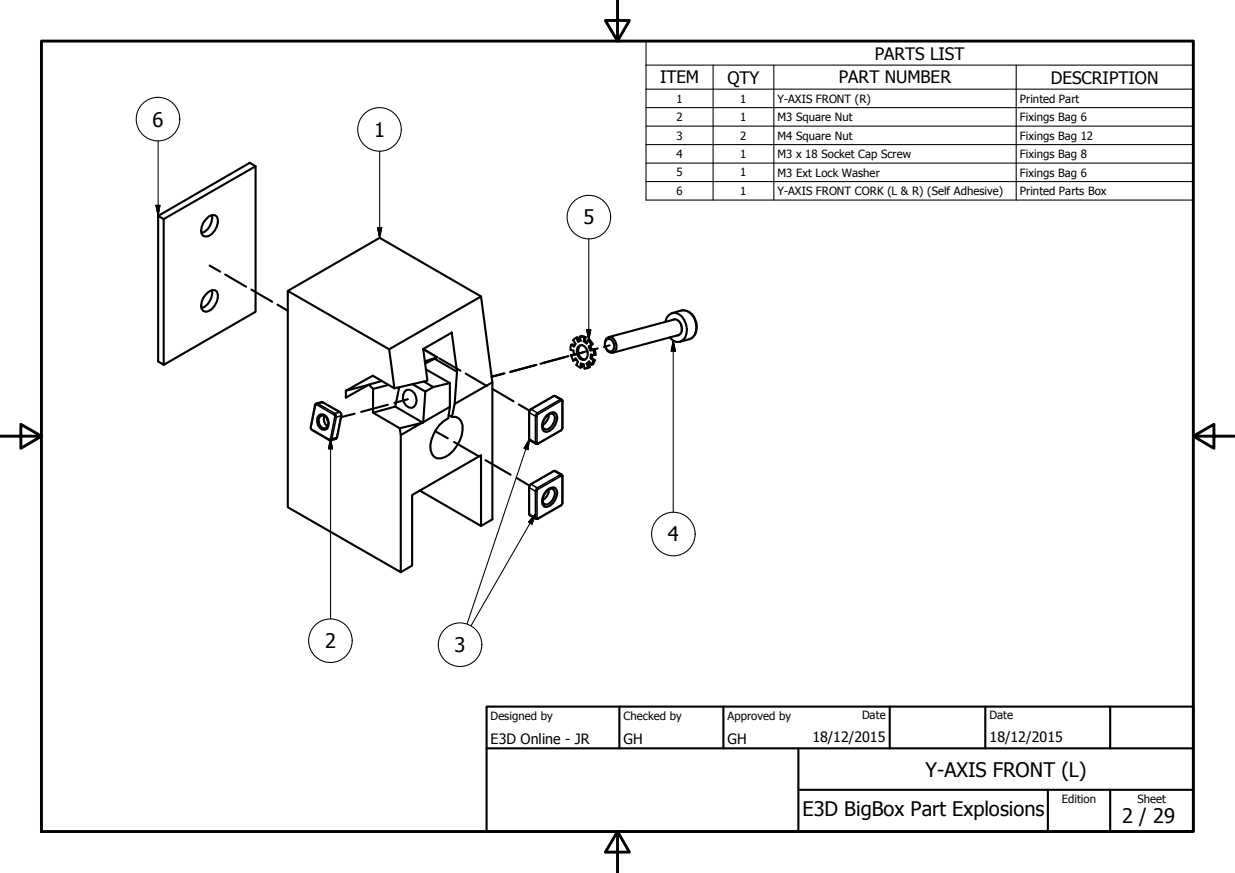
[picture p417: page 2]
Y-AXIS FRONT (R); Printed Part; M3 Square Nut; Fixings Bag 6; M4 Square Nut; Fixings Bag 12; M3 x 18 Socket Cap Screw; Fixings Bag 8; M3 Ext Lock Washer; Y-AXIS FRONT CORK (L & R) (Self Adhesive); Printed Parts Box; E3D Online - JR; Designed by; Checked by; Approved by; Date; Edition; Sheet; Y-AXIS FRONT (L)

ITEM | QTY | PART NUMBER | DESCRIPTION

3

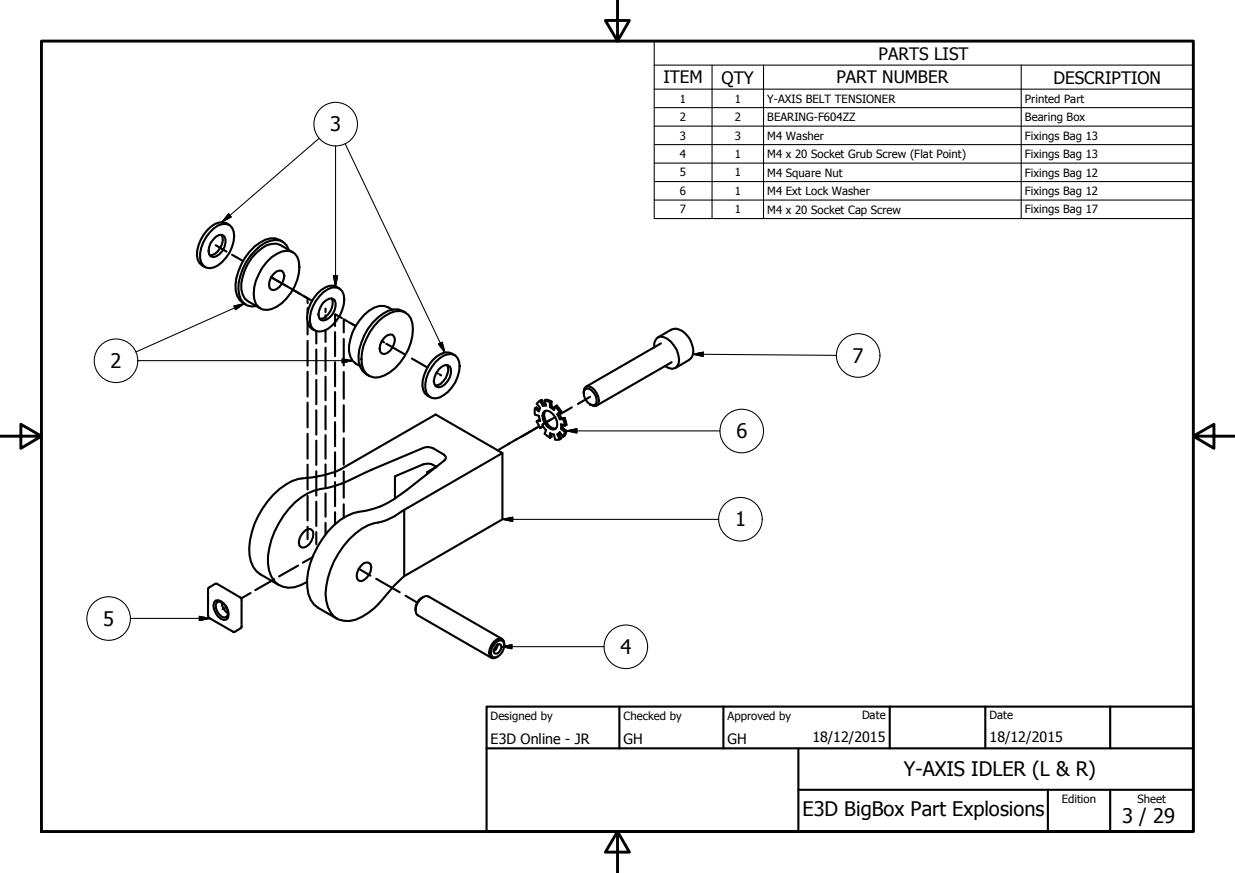
[picture p418: page 3]
Y-AXIS BELT TENSIONER; Printed Part; BEARING-F604ZZ; Bearing Box; M4 Washer; Fixings Bag 13; M4 x 20 Socket Grub Screw (Flat Point); M4 Square Nut; Fixings Bag 12; M4 Ext Lock Washer; M4 x 20 Socket Cap Screw; Fixings Bag 17; E3D Online - JR; Designed by; Checked by; Approved by; Date; Edition; Sheet; Y-AXIS IDLER (L & R)

ITEM | QTY | PART NUMBER | DESCRIPTION

1

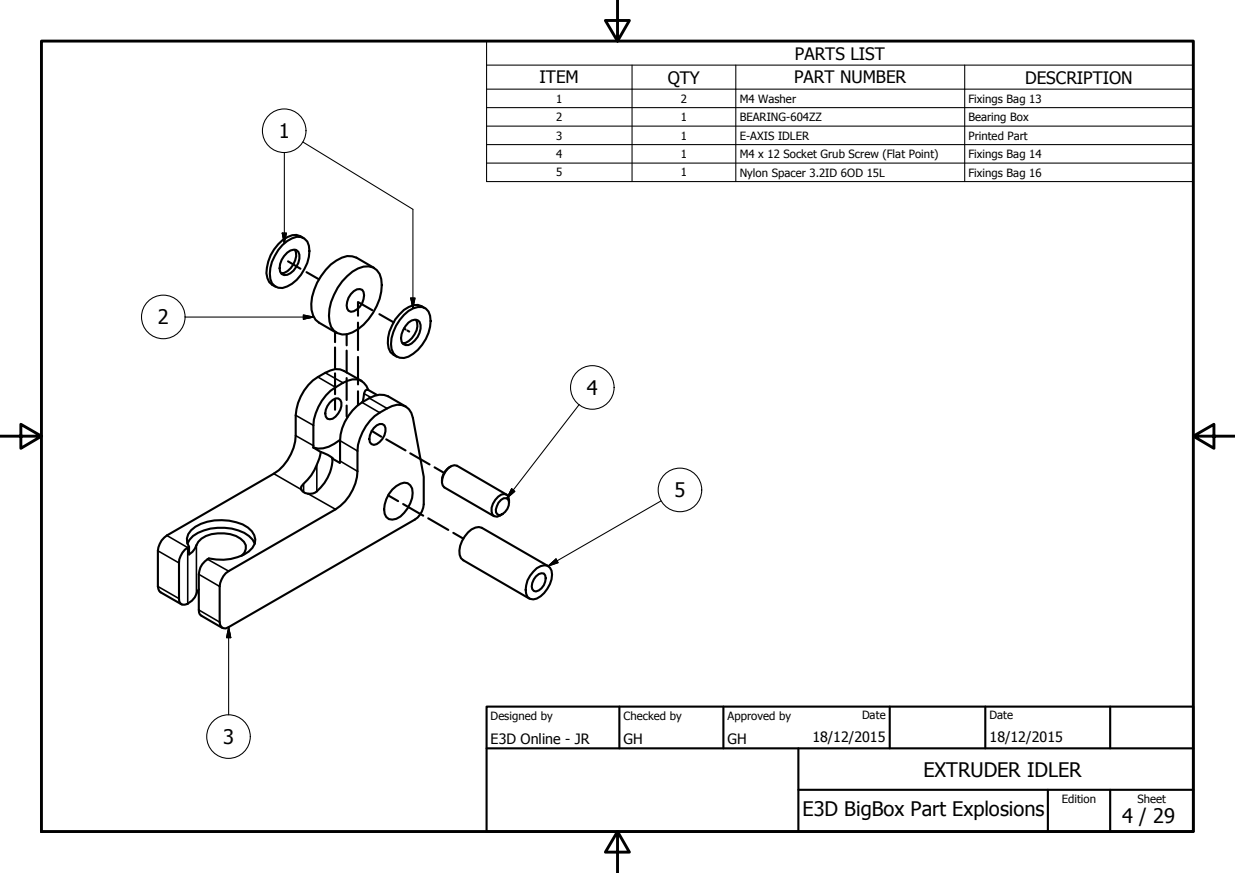
[picture p419: page 4]
M4 Washer; Fixings Bag 13; BEARING-604ZZ; Bearing Box; E-AXIS IDLER; Printed Part; M4 x 12 Socket Grub Screw (Flat Point); Fixings Bag 14; Nylon Spacer 3.2ID 6OD 15L; Fixings Bag 16; E3D Online - JR; Designed by; Checked by; Approved by; Date; Edition; Sheet; EXTRUDER IDLER

ITEM | QTY | PART NUMBER | DESCRIPTION

11

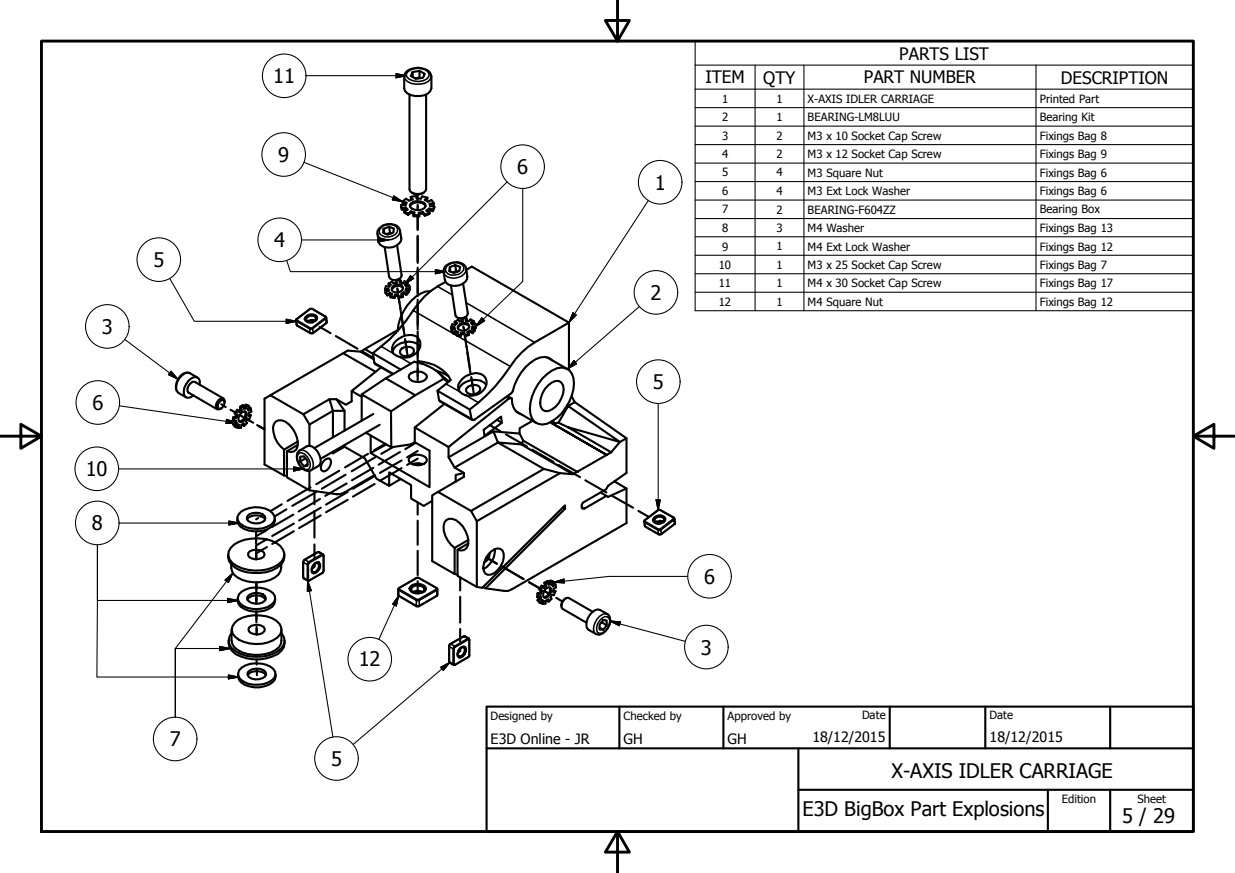
[picture p420: page 5]
X-AXIS IDLER CARRIAGE; Printed Part; BEARING-LM8LUU; Bearing Kit; M3 x 10 Socket Cap Screw; Fixings Bag 8; M3 x 12 Socket Cap Screw; Fixings Bag 9; M3 Square Nut; Fixings Bag 6; M3 Ext Lock Washer; BEARING-F604ZZ; Bearing Box; M4 Washer; Fixings Bag 13; M4 Ext Lock Washer; Fixings Bag 12; M3 x 25 Socket Cap Screw; Fixings Bag 7; M4 x 30 Socket Cap Screw; Fixings Bag 17; M4 Square Nut; E3D Online - JR; Designed by; Checked by; Approved by; Date; Edition; Sheet

X-AXIS IDLER CARRIAGE

ITEM | QTY | PART NUMBER | DESCRIPTION
3

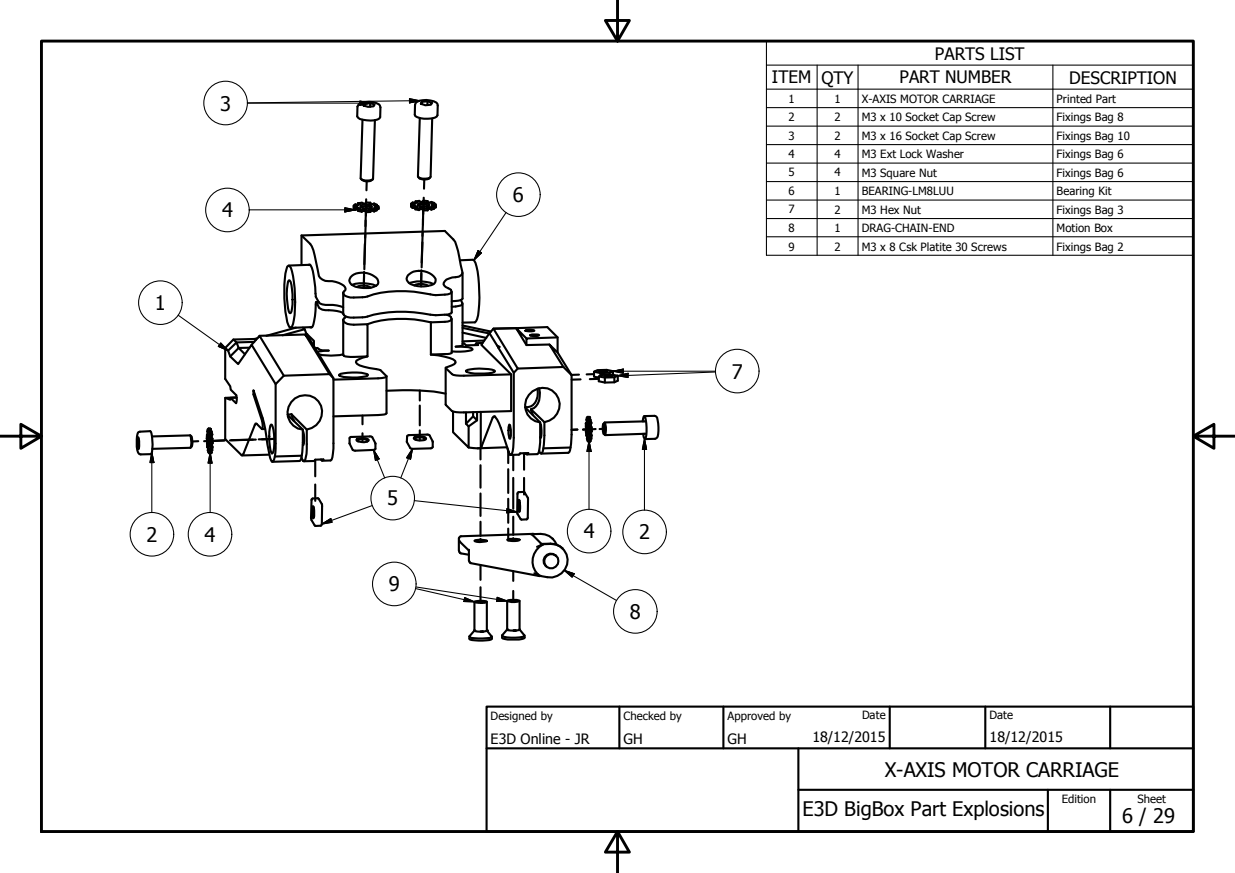
[picture p421: page 6]
X-AXIS MOTOR CARRIAGE; Printed Part; M3 x 10 Socket Cap Screw; Fixings Bag 8; M3 x 16 Socket Cap Screw; Fixings Bag 10; M3 Ext Lock Washer; Fixings Bag 6; M3 Square Nut; BEARING-LM8LUU; Bearing Kit; M3 Hex Nut; Fixings Bag 3; DRAG-CHAIN-END; Motion Box; M3 x 8 Csk Platite 30 Screws; Fixings Bag 2; E3D Online - JR; Designed by; Checked by; Approved by; Date; Edition; Sheet

X-AXIS MOTOR CARRIAGE

ITEM | QTY | PART NUMBER | DESCRIPTION

2

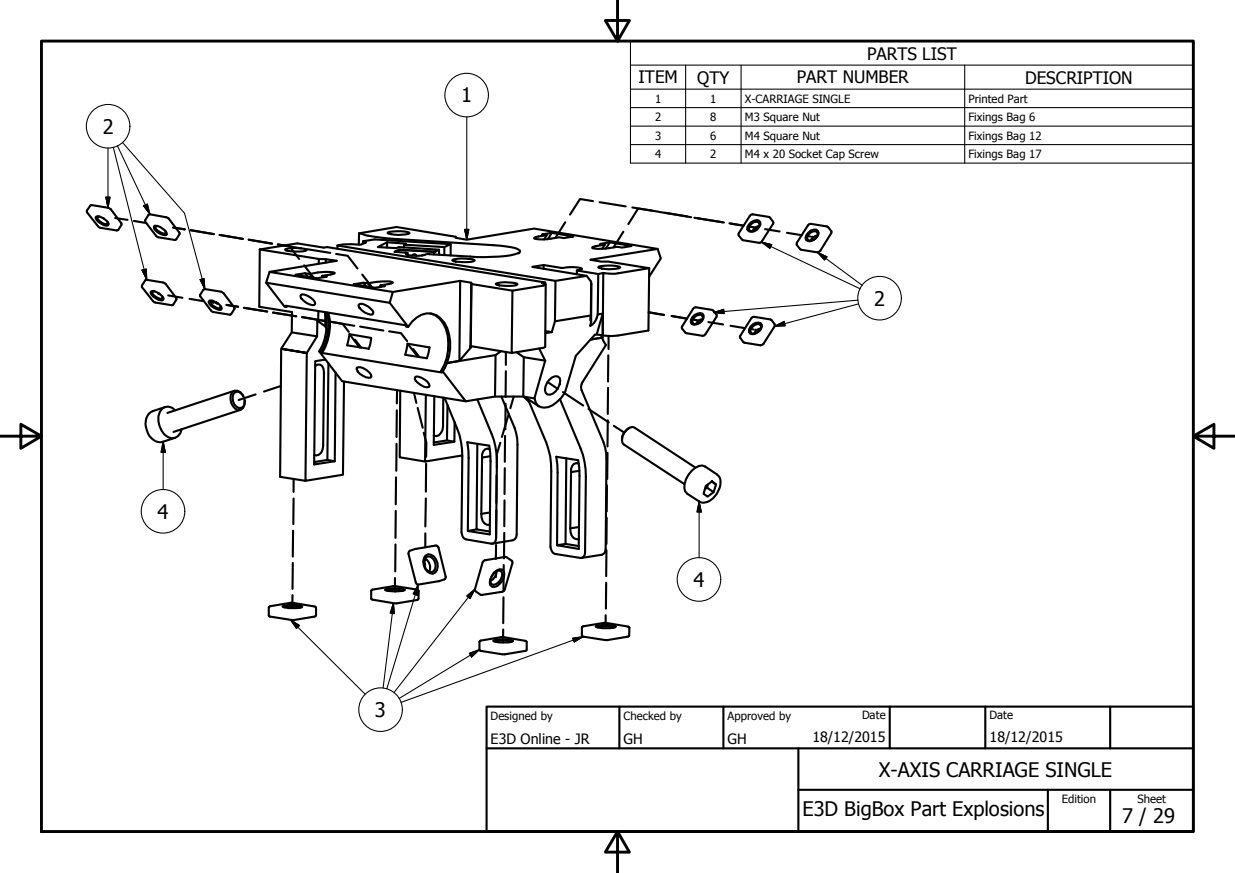
[picture p422: page 7]
X-CARRIAGE SINGLE; Printed Part; M3 Square Nut; Fixings Bag 6; M4 Square Nut; Fixings Bag 12; M4 x 20 Socket Cap Screw; Fixings Bag 17; E3D Online - JR; Designed by; Checked by; Approved by; Date; Edition; Sheet

X-AXIS CARRIAGE SINGLE

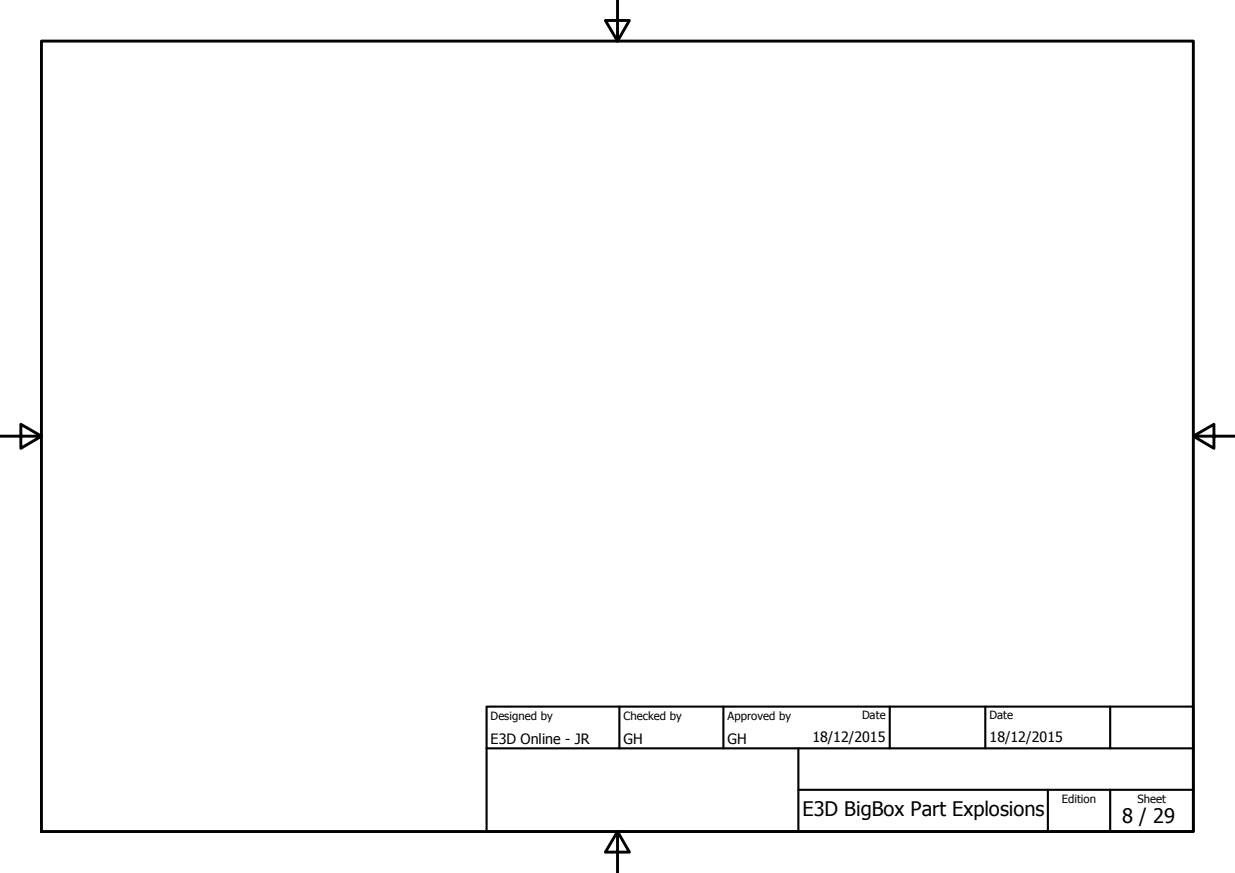
[picture p423: page 8]
E3D Online - JR; Designed by; Checked by; Approved by; Date; Edition; Sheet

ITEM | QTY | PART NUMBER | DESCRIPTION

1

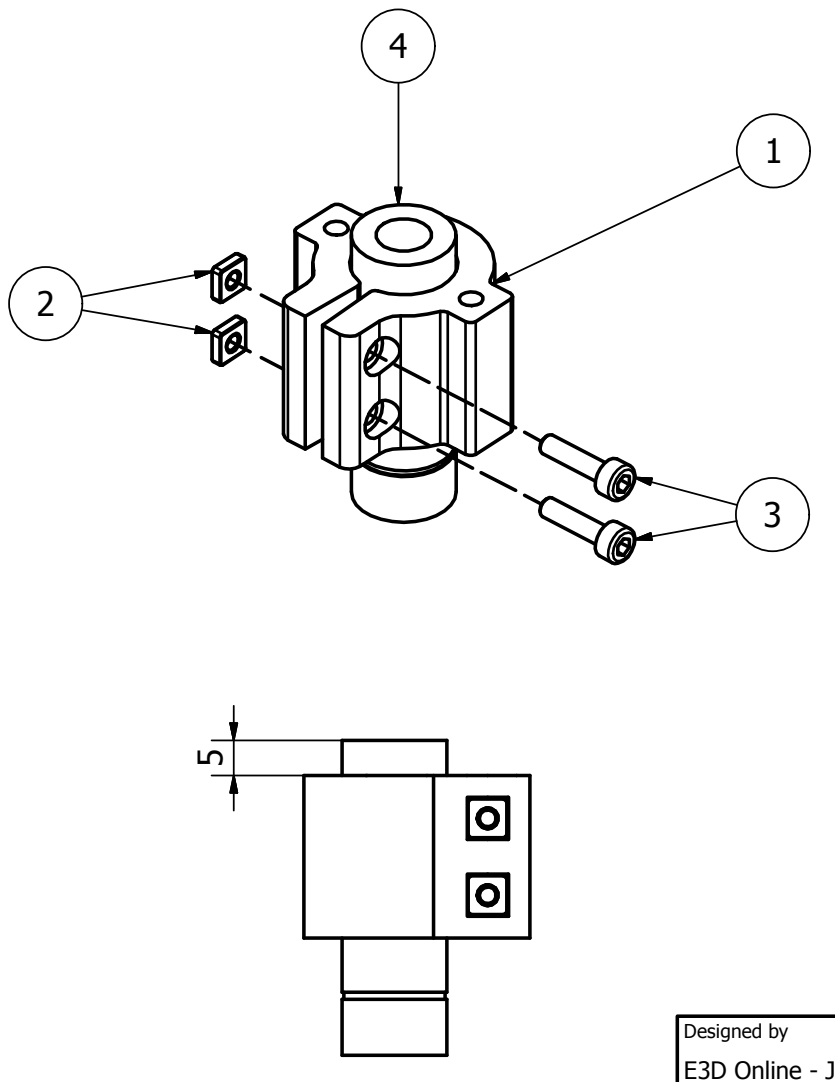
[picture p424: page 9]
HEATED BED CORNERS; Printed Part; M3 Square Nut; Fixings Bag 6; M3 x 12 Socket Cap Screw; Fixings Bag 9; BEARING-LM8LUU; Bearing Kit; E3D Online - JR; Designed by; Checked by; Approved by; Date; Edition; Sheet

HEATED BED CORNERS

ITEM | QTY | PART NUMBER | DESCRIPTION

6

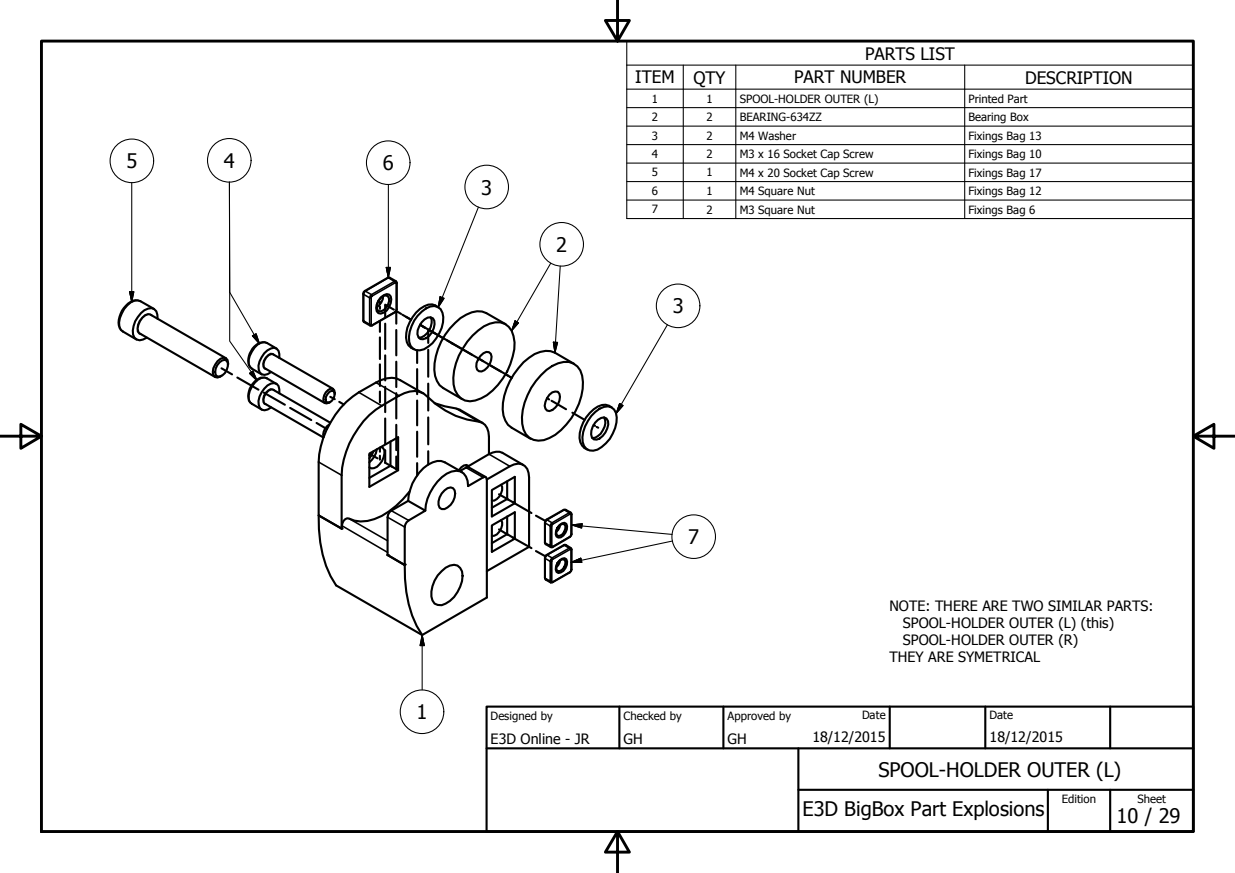
[picture p425: page 10]
SPOOL-HOLDER OUTER (L); Printed Part; BEARING-634ZZ; Bearing Box; M4 Washer; Fixings Bag 13; M3 x 16 Socket Cap Screw; Fixings Bag 10; M4 x 20 Socket Cap Screw; Fixings Bag 17; M4 Square Nut; Fixings Bag 12; M3 Square Nut; Fixings Bag 6; E3D Online - JR; Designed by; Checked by; Approved by; Date; Edition; Sheet

NOTE: THERE ARE TWO SIMILAR PARTS:
SPOOL-HOLDER OUTER (L) (this)
SPOOL-HOLDER OUTER (R)
THEY ARE SYMETRICAL

SPOOL-HOLDER OUTER (L)

ITEM | QTY | PART NUMBER | DESCRIPTION

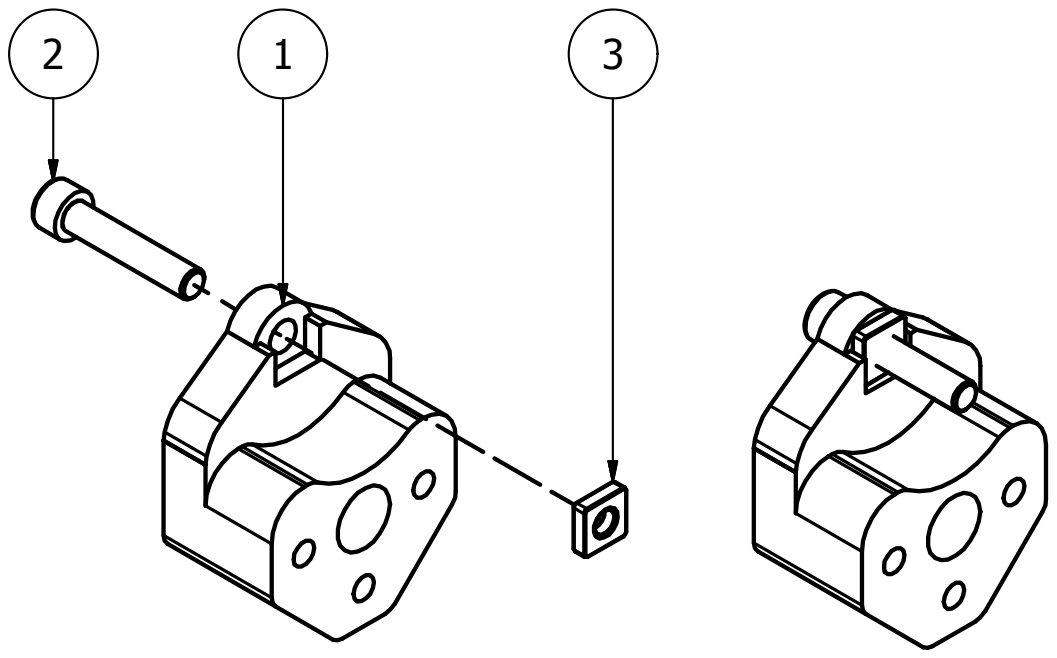
[picture p426: page 11]
SPOOL-HOLDER INNER; Printed Part; M4 x 20 Socket Cap Screw; Fixings Bag 17; M4 Square Nut; Fixings Bag 12; E3D Online - JR; Designed by; Checked by; Approved by; Date; Edition; Sheet

SPOOL-HOLDER INNER

ITEM | QTY | PART NUMBER | DESCRIPTION
2

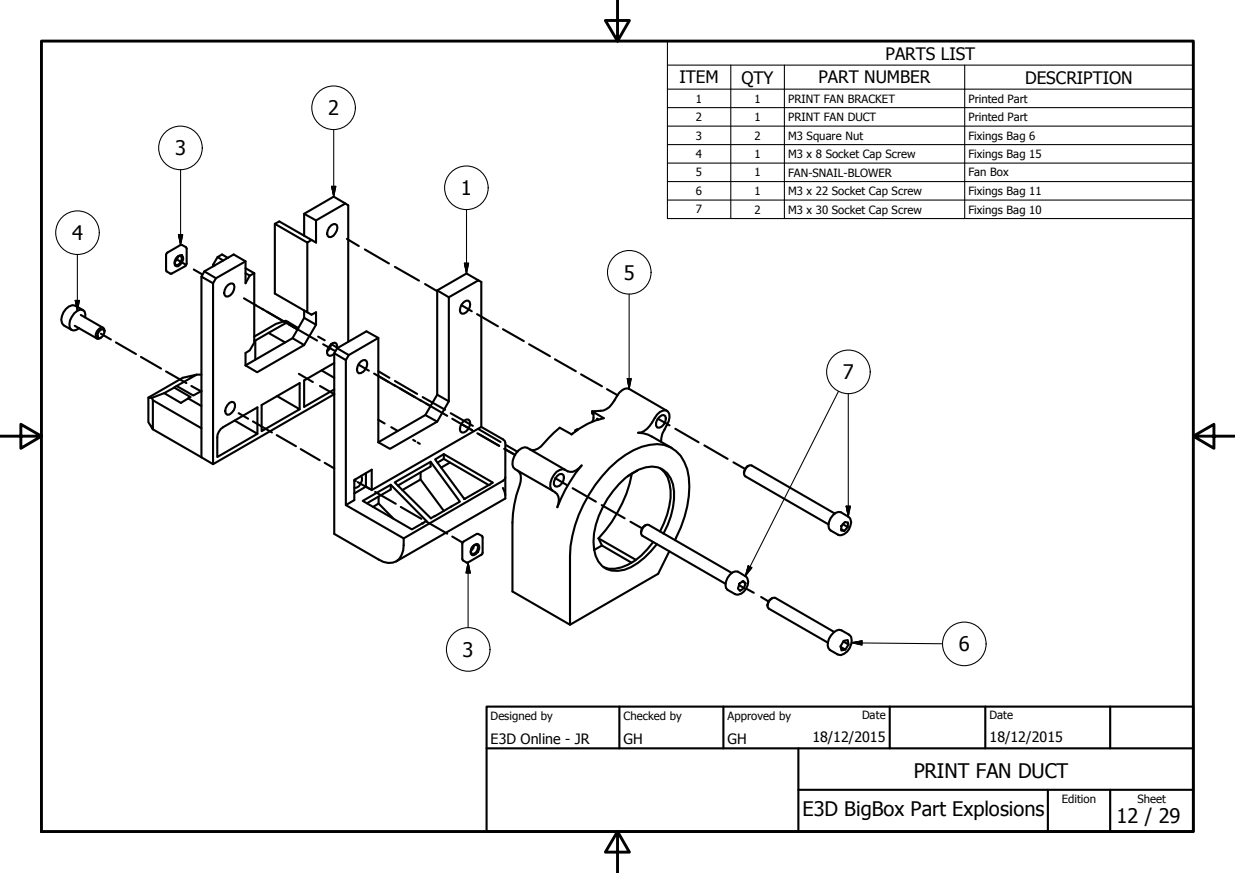
[picture p427: page 12]
PRINT FAN BRACKET; Printed Part; PRINT FAN DUCT; M3 Square Nut; Fixings Bag 6; M3 x 8 Socket Cap Screw; Fixings Bag 15; FAN-SNAIL-BLOWER; Fan Box; M3 x 22 Socket Cap Screw; Fixings Bag 11; M3 x 30 Socket Cap Screw; Fixings Bag 10; E3D Online - JR; Designed by; Checked by; Approved by; Date; Edition; Sheet

PRINT FAN DUCT

ITEM | QTY | PART NUMBER | DESCRIPTION

4

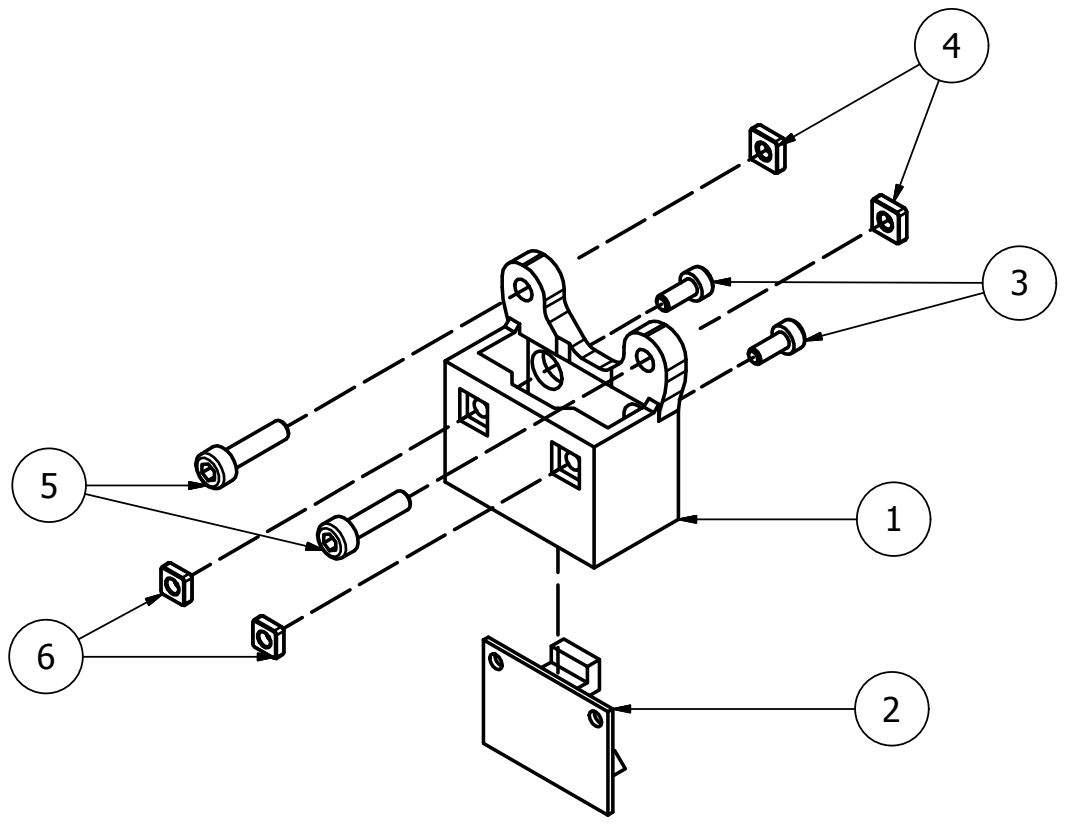
[picture p428: page 13]
IR-SENSOR HOUSING; Printed Part; IR-SENSOR; Electronics Box; M2.5 x 6 Socket Cap Screw; Fixings Bag 5; M3 Square Nut; Fixings Bag 6; M3 x 12 Socket Cap Screw; Fixings Bag 9; M2.5 Square Nut; Fixings Bag 4; E3D Online - JR; Designed by; Checked by; Approved by; Date; Edition; Sheet

IR SENSOR ASSEMBLY

ITEM | QTY | PART NUMBER | DESCRIPTION

7

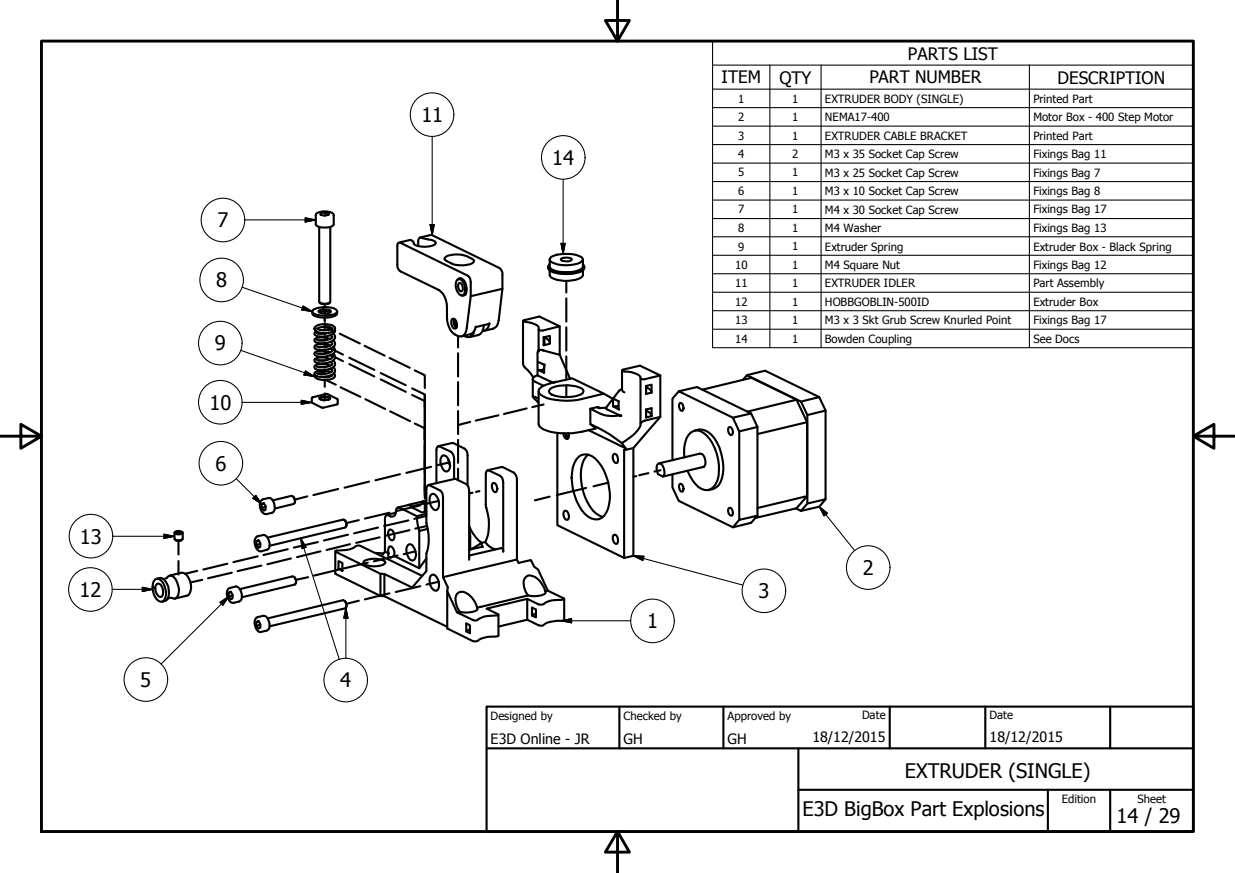
[picture p429: page 14]
EXTRUDER BODY (SINGLE); Printed Part; NEMA17-400; Motor Box - 400 Step Motor; EXTRUDER CABLE BRACKET; M3 x 35 Socket Cap Screw; Fixings Bag 11; M3 x 25 Socket Cap Screw; Fixings Bag 7; M3 x 10 Socket Cap Screw; Fixings Bag 8; M4 x 30 Socket Cap Screw; Fixings Bag 17; M4 Washer; Fixings Bag 13; Extruder Spring; Extruder Box - Black Spring; M4 Square Nut; Fixings Bag 12; EXTRUDER IDLER; Part Assembly; HOBBGOBLIN-500ID; Extruder Box; M3 x 3 Skt Grub Screw Knurled Point; Bowden Coupling; See Docs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

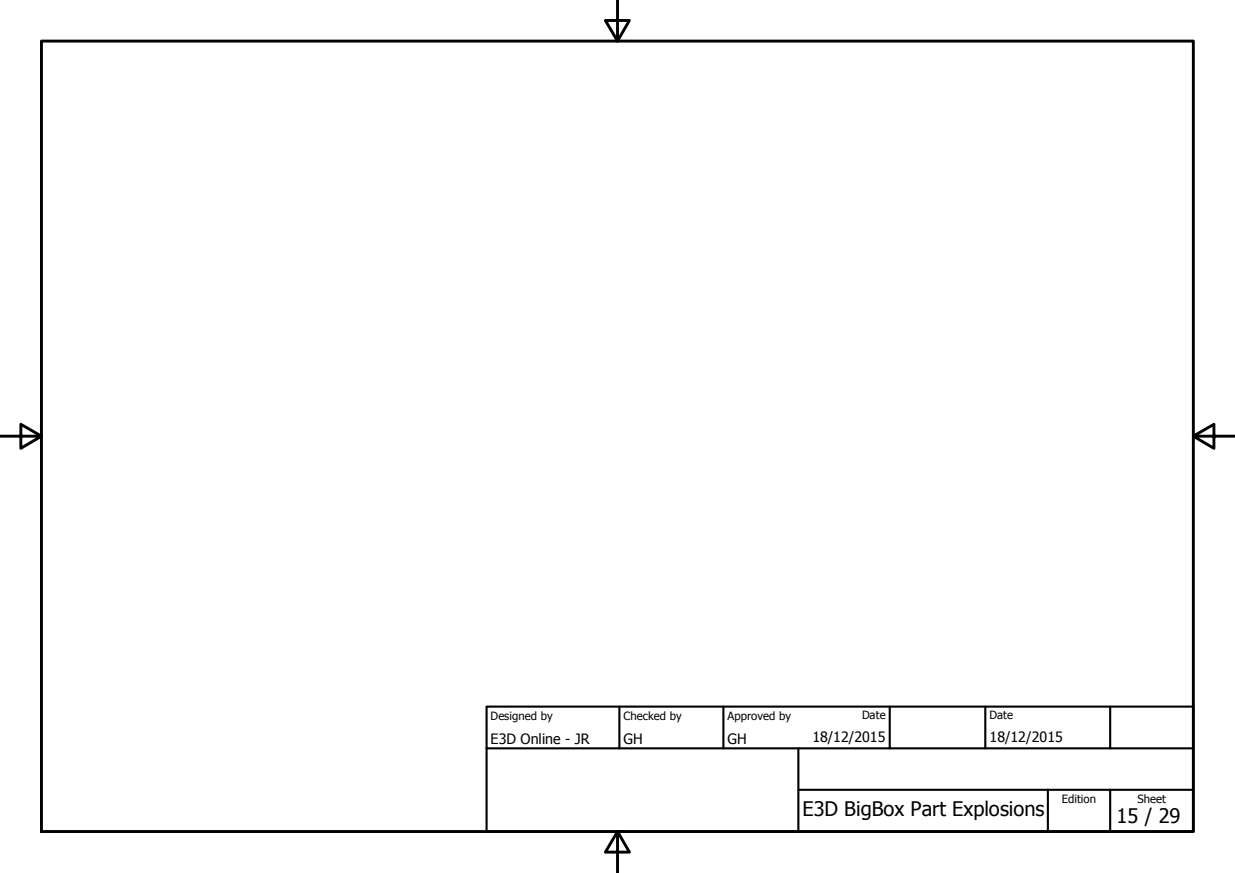
[picture p430: page 15]
E3D Online - JR; Designed by; Checked by; Approved by; Date; Edition; Sheet

ITEM | QTY | PART NUMBER | DESCRIPTION

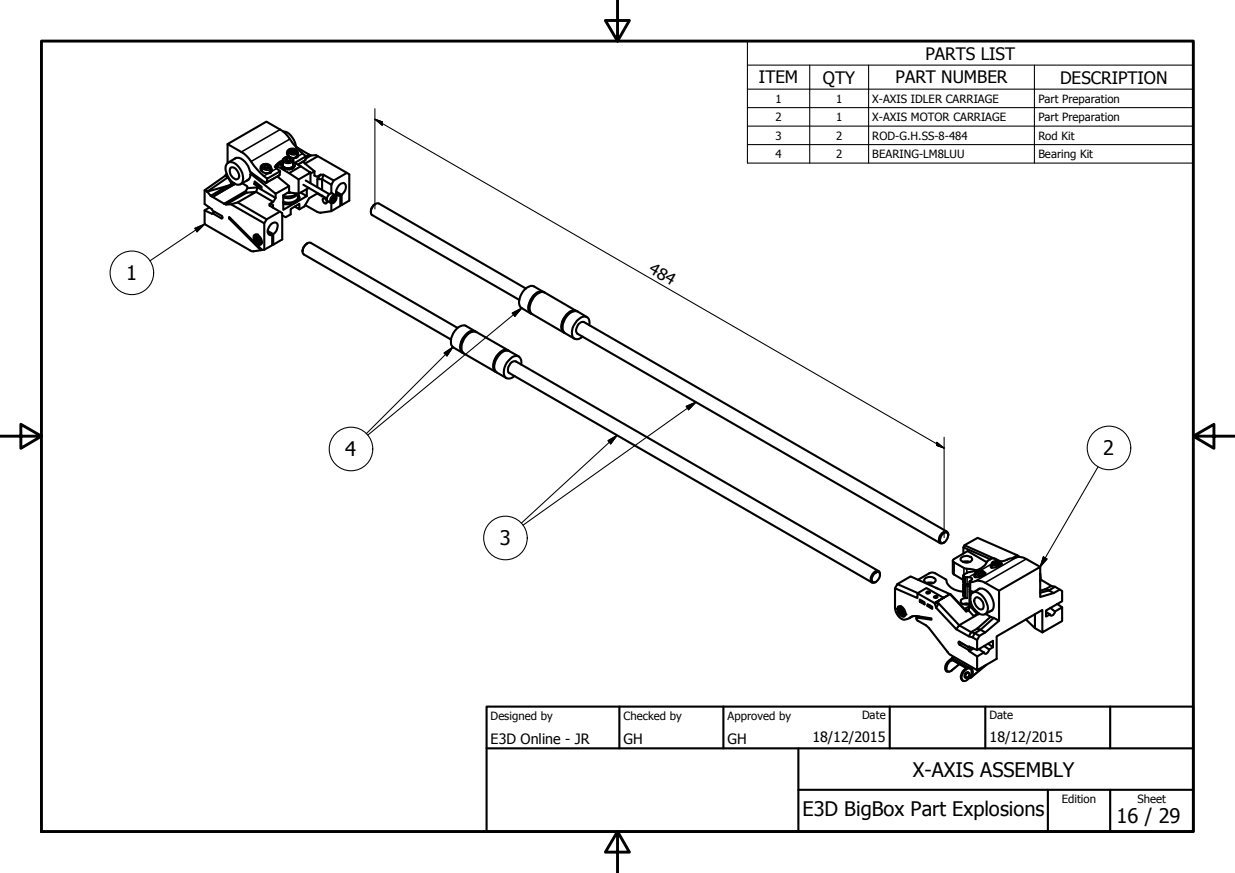
[picture p431: page 16]
X-AXIS IDLER CARRIAGE; Part Preparation; X-AXIS MOTOR CARRIAGE; ROD-G.H.SS-8-484; Rod Kit; BEARING-LM8LUU; Bearing Kit; E3D Online - JR; Designed by; Checked by; Approved by; Date; Edition; Sheet; X-AXIS ASSEMBLY

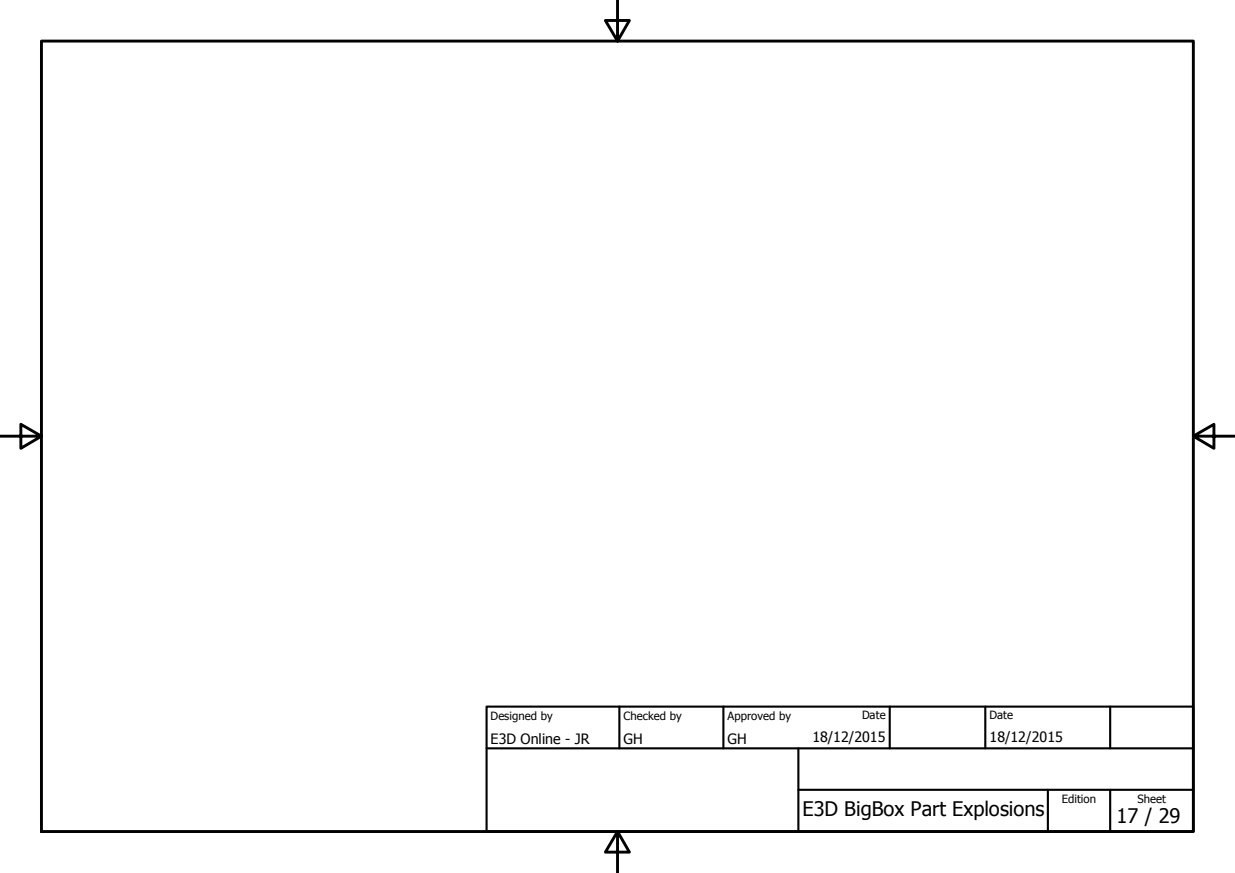
[picture p432: page 17]
E3D Online - JR; Designed by; Checked by; Approved by; Date; Edition; Sheet

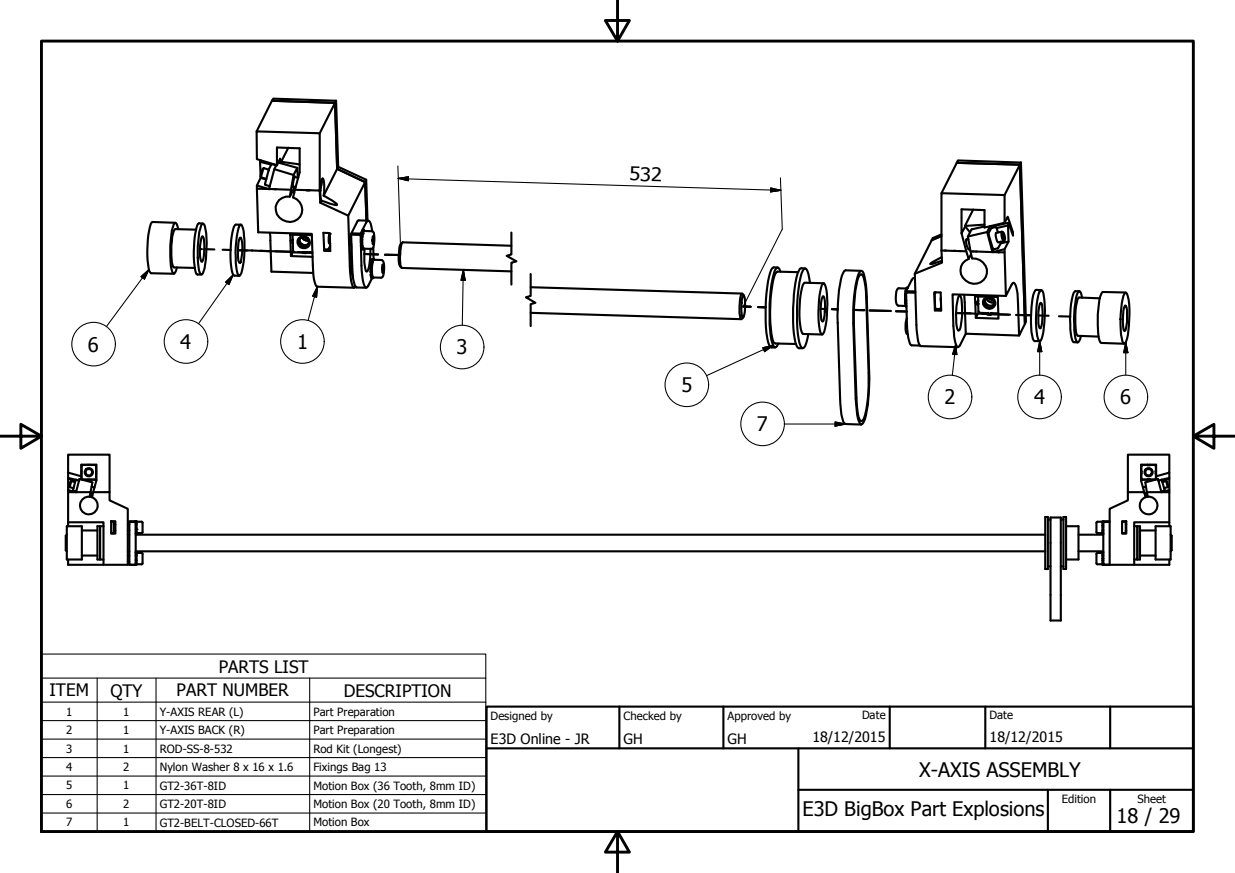
[picture p433: page 18]
PARTS LIST; ITEM; QTY; PART NUMBER; DESCRIPTION; Y-AXIS REAR (L); Part Preparation; Y-AXIS BACK (R); ROD-SS-8-532; Rod Kit (Longest); Nylon Washer 8 x 16 x 1.6; Fixings Bag 13; Motion Box (36 Tooth, 8mm ID); Motion Box (20 Tooth, 8mm ID); GT2-BELT-CLOSED-66T; Motion Box; E3D Online - JR; Designed by; Checked by; Approved by; Date; Edition; Sheet; X-AXIS ASSEMBLY

ITEM | QTY | PART NUMBER | DESCRIPTION

2

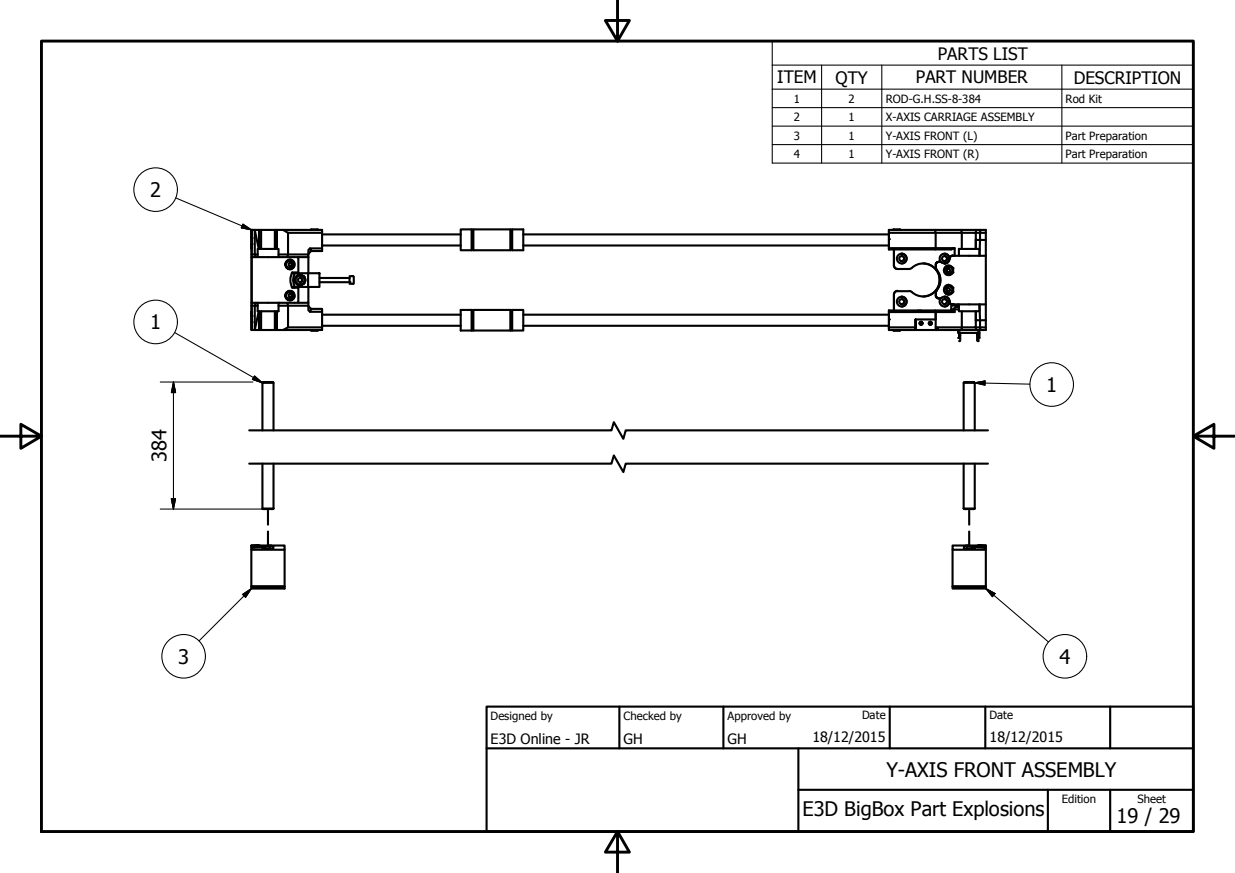
[picture p434: page 19]
ROD-G.H.SS-8-384; Rod Kit; X-AXIS CARRIAGE ASSEMBLY; Y-AXIS FRONT (L); Part Preparation; Y-AXIS FRONT (R); E3D Online - JR; Designed by; Checked by; Approved by; Date; Edition; Sheet

Y-AXIS FRONT ASSEMBLY

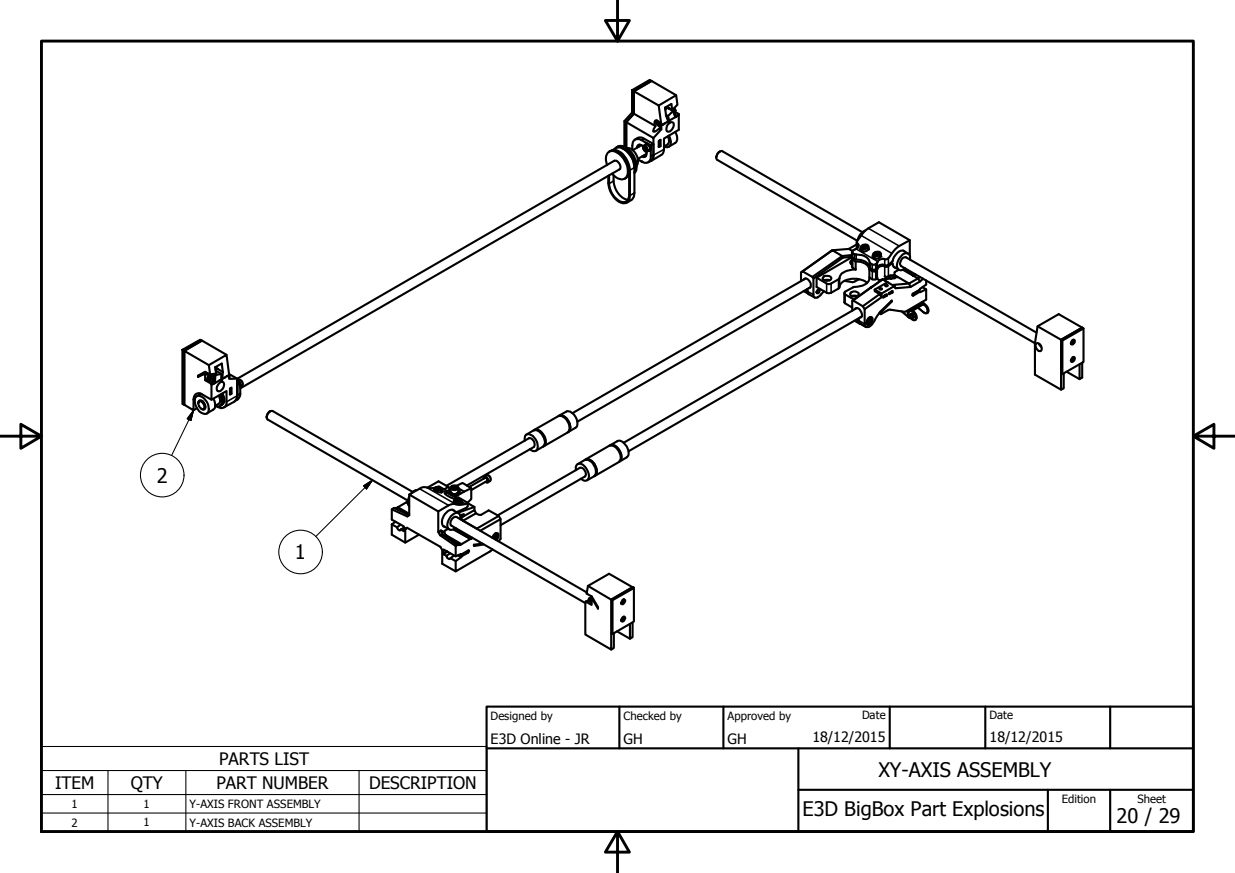
[picture p435: page 20]
PARTS LIST; ITEM; QTY; PART NUMBER; DESCRIPTION; Y-AXIS FRONT ASSEMBLY; Y-AXIS BACK ASSEMBLY; E3D Online - JR; Designed by; Checked by; Approved by; Date; Edition; Sheet

XY-AXIS ASSEMBLY

ITEM | QTY | PART NUMBER | DESCRIPTION
5 | 3

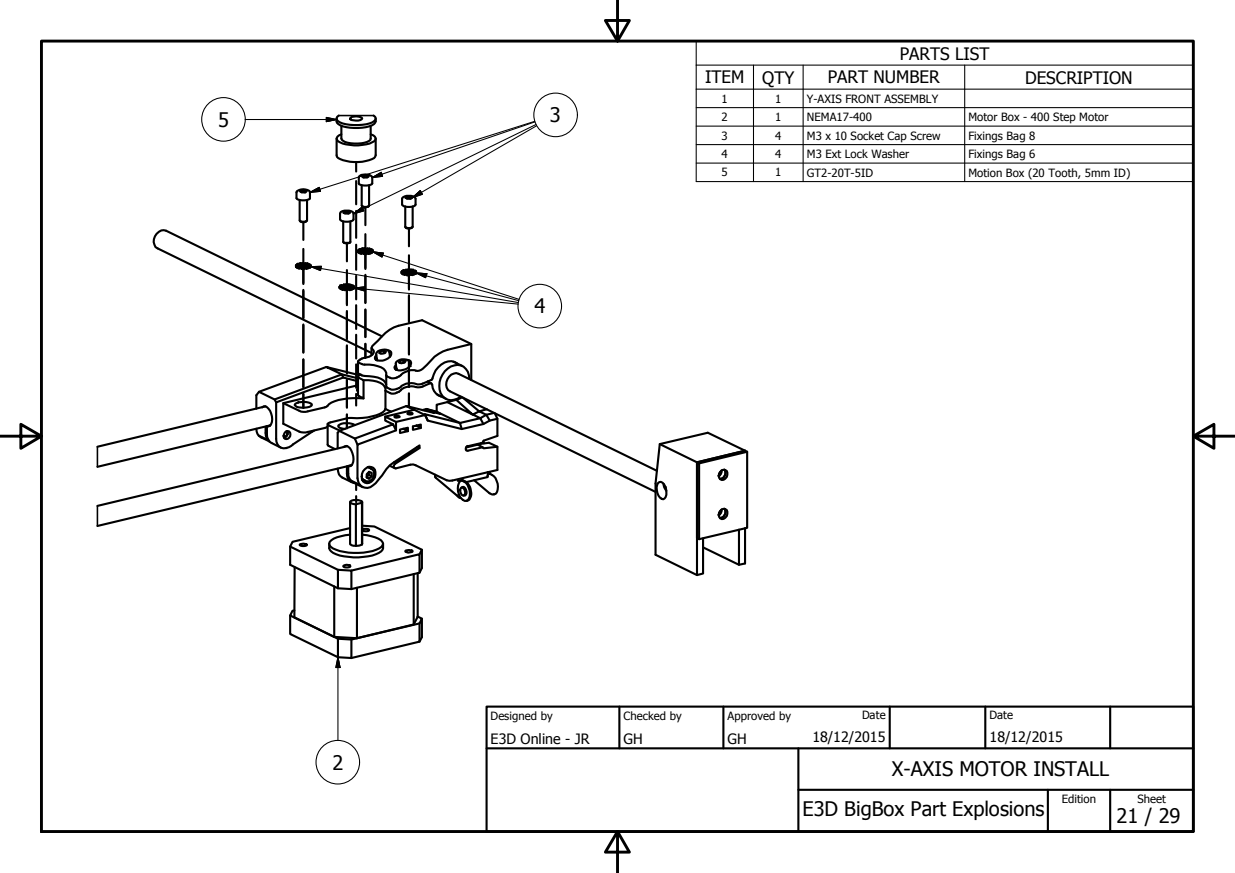
[picture p436: page 21]
Y-AXIS FRONT ASSEMBLY; NEMA17-400; Motor Box - 400 Step Motor; M3 x 10 Socket Cap Screw; Fixings Bag 8; M3 Ext Lock Washer; Fixings Bag 6; Motion Box (20 Tooth, 5mm ID); E3D Online - JR; Designed by; Checked by; Approved by; Date; Edition; Sheet; X-AXIS MOTOR INSTALL

ITEM | QTY | PART NUMBER | DESCRIPTION

6

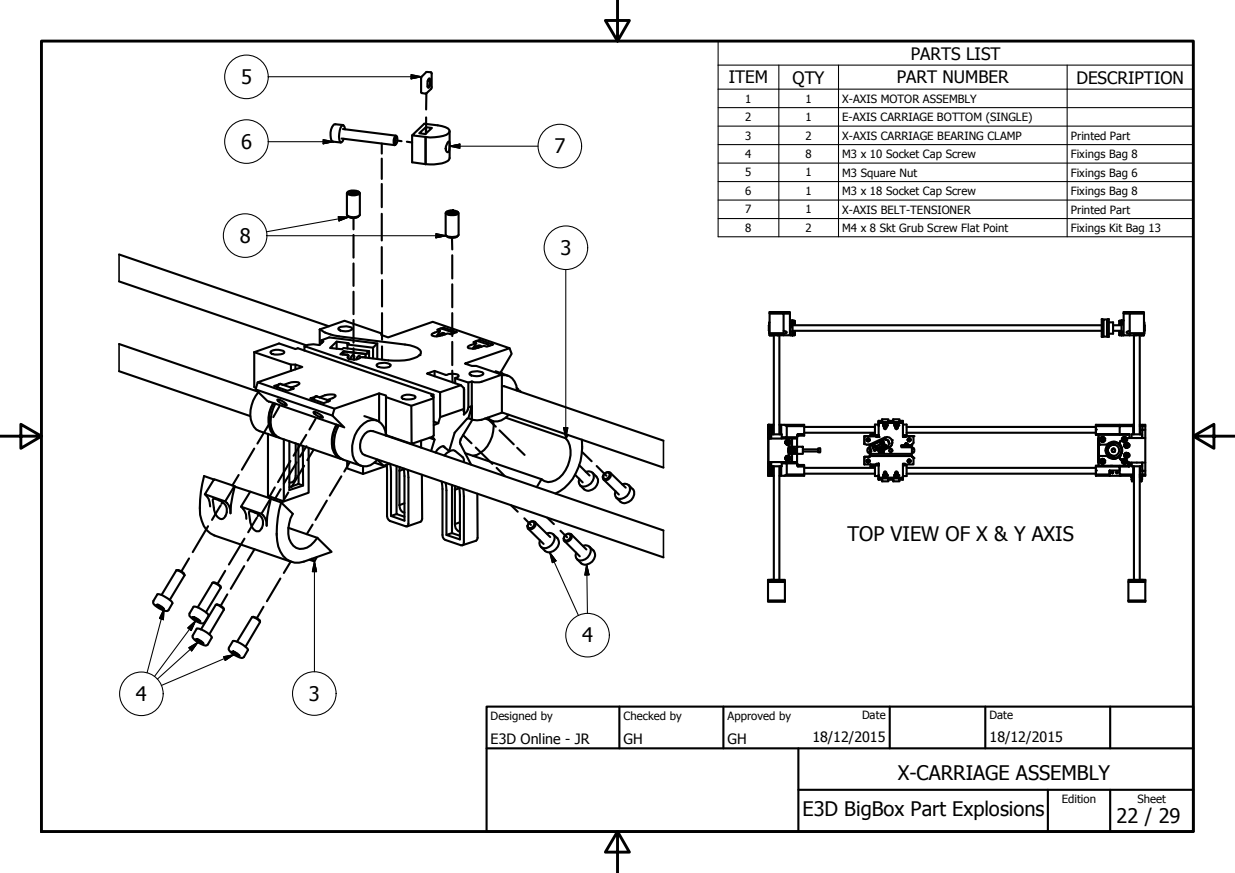
[picture p437: page 22]
X-AXIS MOTOR ASSEMBLY; E-AXIS CARRIAGE BOTTOM (SINGLE); X-AXIS CARRIAGE BEARING CLAMP; Printed Part; M3 x 10 Socket Cap Screw; Fixings Bag 8; M3 Square Nut; Fixings Bag 6; M3 x 18 Socket Cap Screw; X-AXIS BELT-TENSIONER; M4 x 8 Skt Grub Screw Flat Point; Fixings Kit Bag 13; E3D Online - JR; Designed by; Checked by; Approved by; Date; Edition; Sheet; X-CARRIAGE ASSEMBLY

TOP VIEW OF X & Y AXIS

ITEM | QTY | PART NUMBER | DESCRIPTION

1

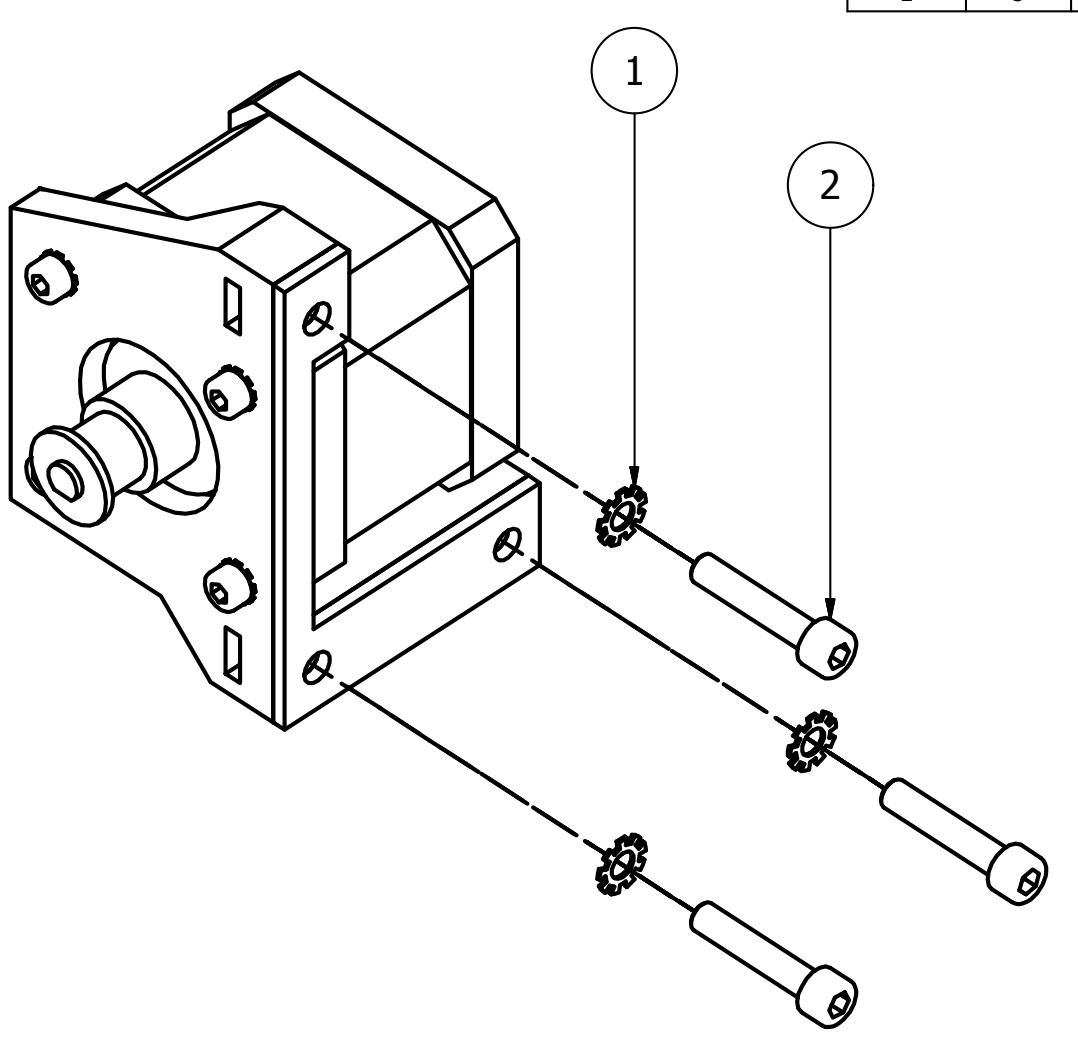
[picture p438: page 23]
M4 Ext Lock Washer; Fixings Bag 12; M4 x 20 Socket Cap Screw; Fixings Bag 17; E3D Online - JR; Designed by; Checked by; Approved by; Date; Edition; Sheet

MOUNT Y-AXIS MOTOR

ITEM | QTY | PART NUMBER | DESCRIPTION

1

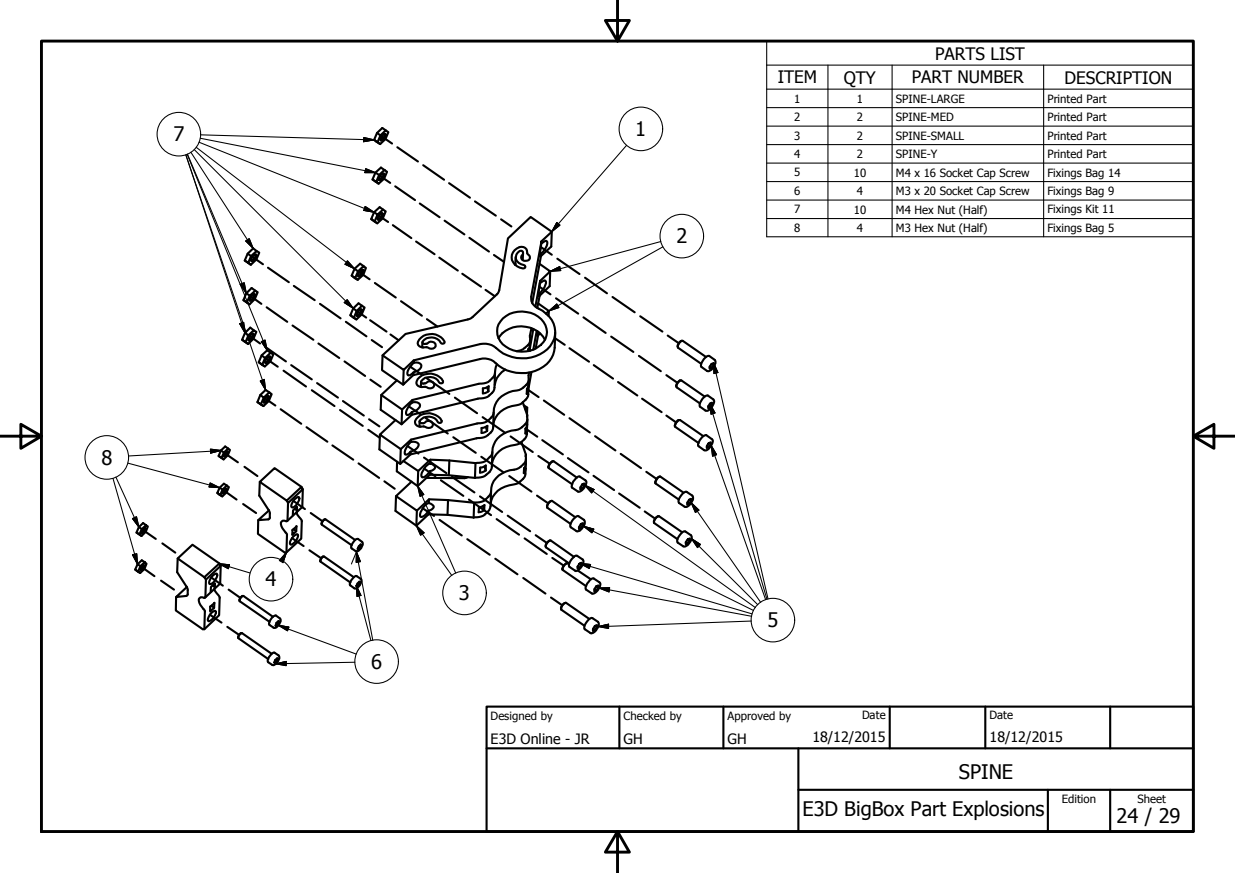
[picture p439: page 24]
SPINE-LARGE; Printed Part; SPINE-MED; SPINE-SMALL; SPINE-Y; M4 x 16 Socket Cap Screw; Fixings Bag 14; M3 x 20 Socket Cap Screw; Fixings Bag 9; M4 Hex Nut (Half); Fixings Kit 11; M3 Hex Nut (Half); Fixings Bag 5; E3D Online - JR; Designed by; Checked by; Approved by; Date; Edition; Sheet; SPINE

ITEM | QTY | PART NUMBER | DESCRIPTION

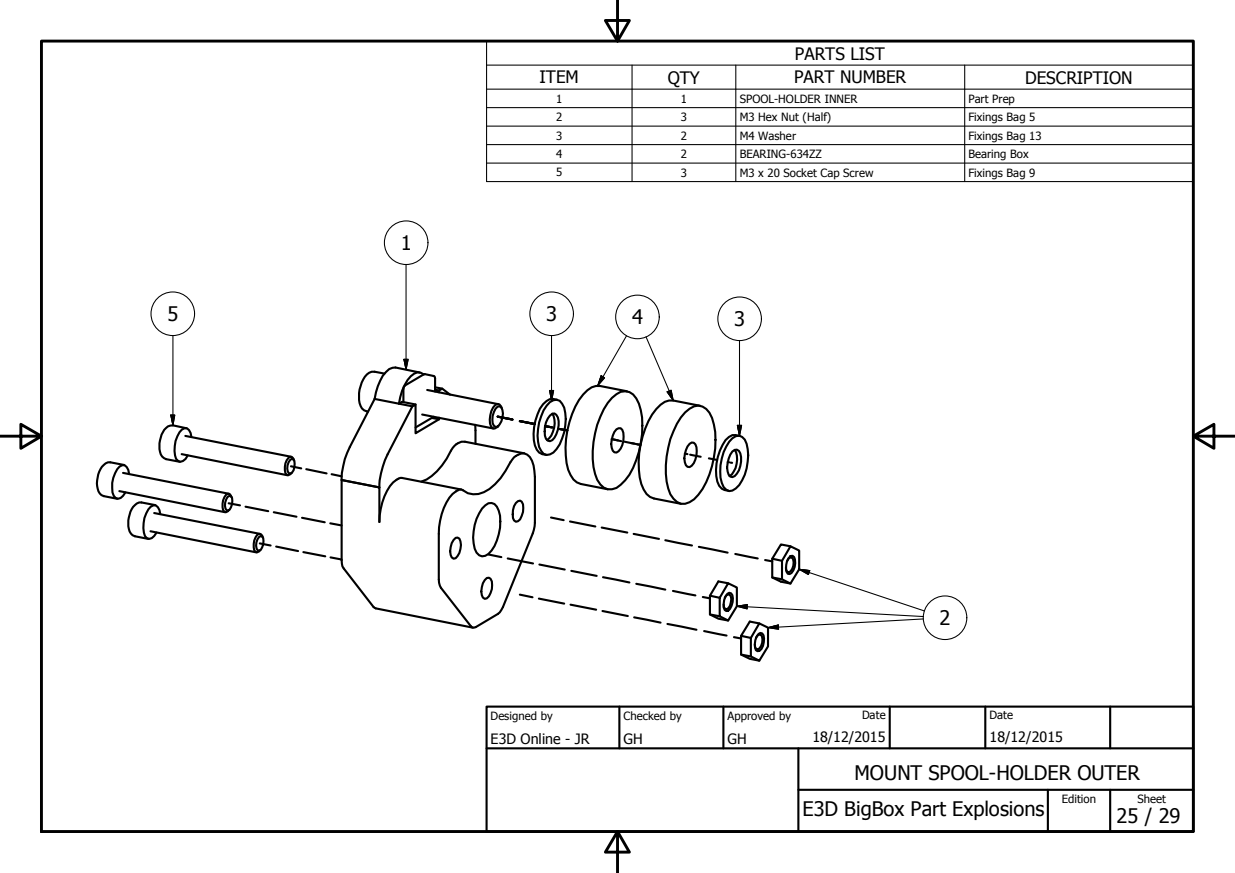
[picture p440: page 25]
SPOOL-HOLDER INNER; Part Prep; M3 Hex Nut (Half); Fixings Bag 5; M4 Washer; Fixings Bag 13; BEARING-634ZZ; Bearing Box; M3 x 20 Socket Cap Screw; Fixings Bag 9; E3D Online - JR; Designed by; Checked by; Approved by; Date; Edition; Sheet

MOUNT SPOOL-HOLDER OUTER

ITEM | QTY | PART NUMBER | DESCRIPTION

6

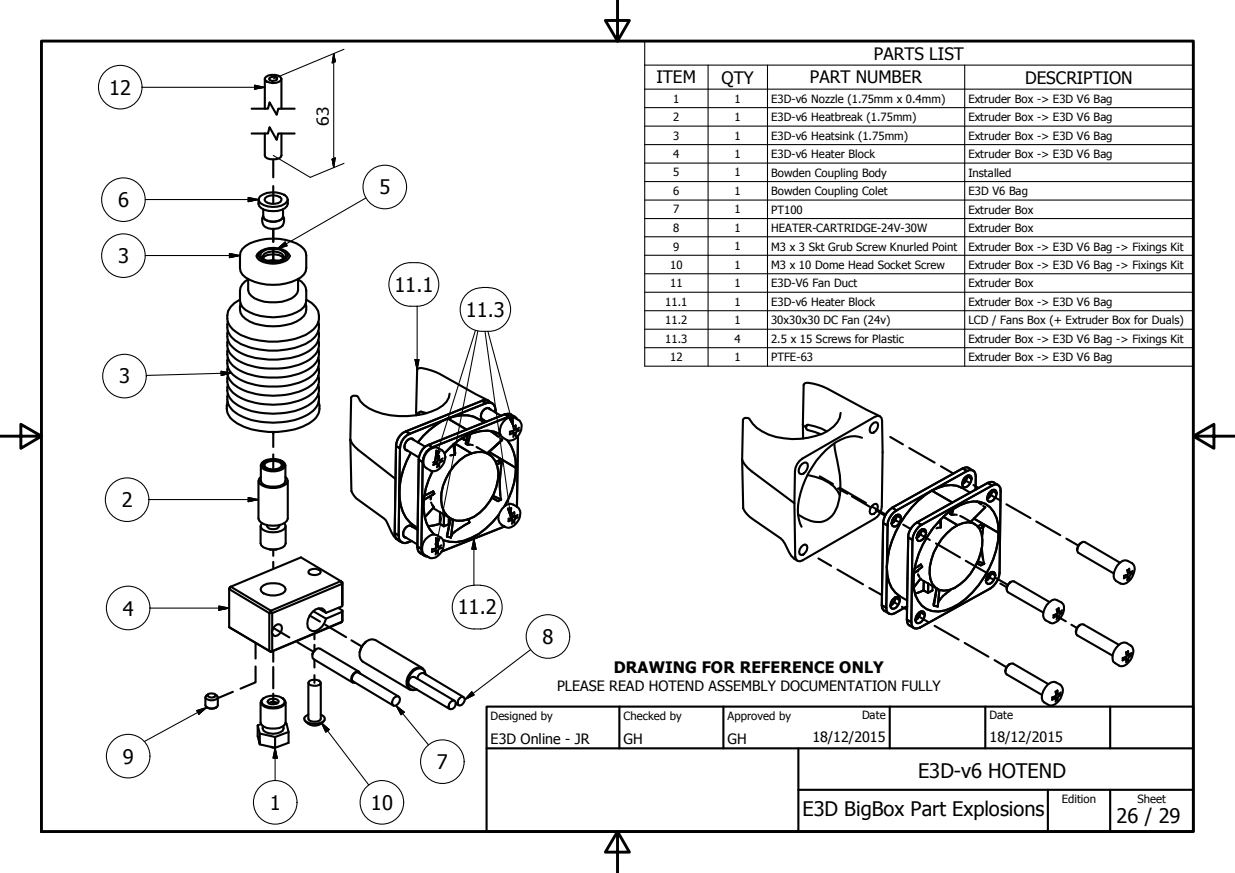
[picture p441: page 26]
E3D-v6 Nozzle (1.75mm x 0.4mm); Extruder Box -> E3D V6 Bag; E3D-v6 Heatbreak (1.75mm); E3D-v6 Heatsink (1.75mm); E3D-v6 Heater Block; Bowden Coupling Body; Installed; Bowden Coupling Colet; E3D V6 Bag; Extruder Box; HEATER-CARTRIDGE-24V-30W; M3 x 3 Skt Grub Screw Knurled Point; Extruder Box -> E3D V6 Bag -> Fixings Kit; M3 x 10 Dome Head Socket Screw; E3D-V6 Fan Duct; 30x30x30 DC Fan (24v); LCD / Fans Box (+ Extruder Box for Duals); 2.5 x 15 Screws for Plastic; PTFE-63; E3D Online - JR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

DRAWING FOR REFERENCE ONLY

PLEASE READ HOTEND ASSEMBLY DOCUMENTATION FULLY

ITEM | QTY | PART NUMBER | DESCRIPTION

3

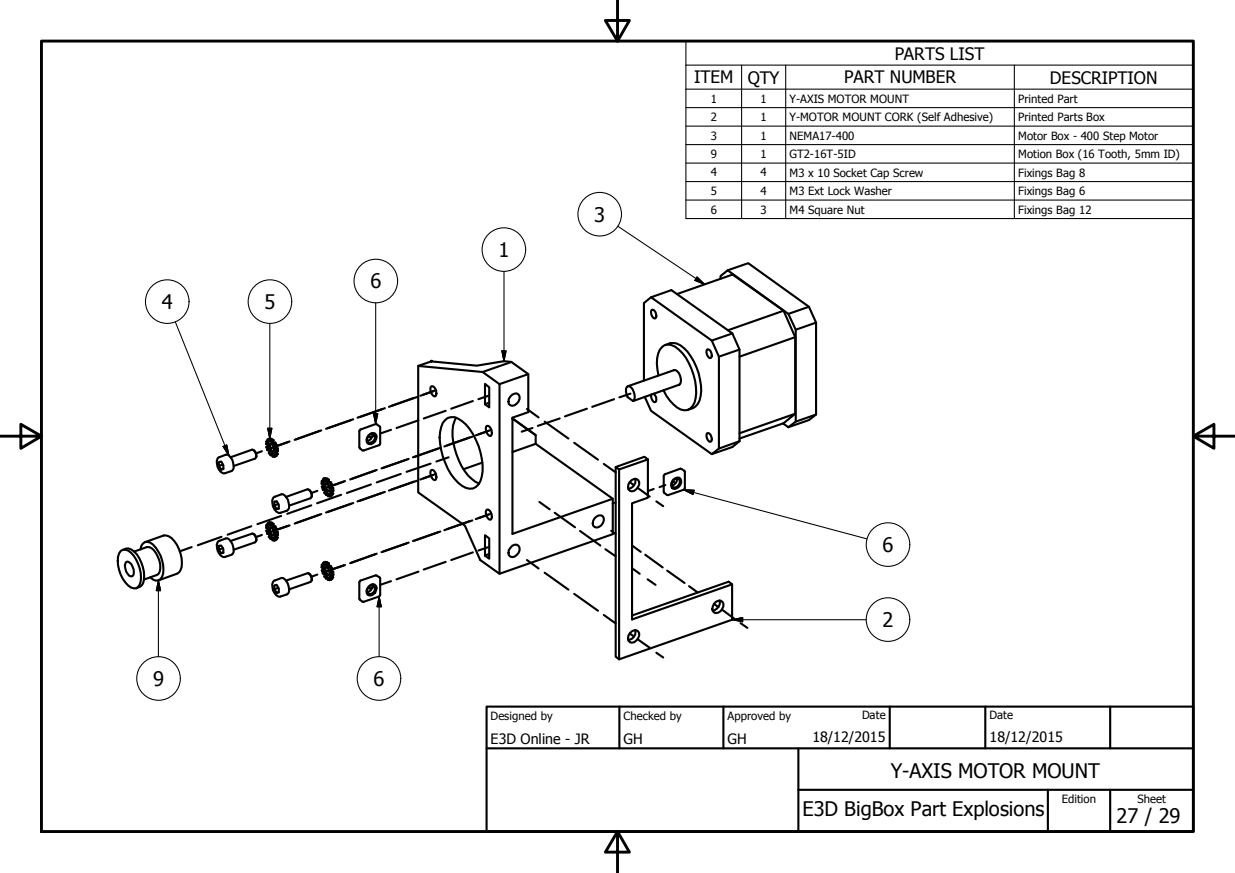
[picture p442: page 27]
Y-AXIS MOTOR MOUNT; Printed Part; Y-MOTOR MOUNT CORK (Self Adhesive); Printed Parts Box; NEMA17-400; Motor Box - 400 Step Motor; Motion Box (16 Tooth, 5mm ID); M3 x 10 Socket Cap Screw; Fixings Bag 8; M3 Ext Lock Washer; Fixings Bag 6; M4 Square Nut; Fixings Bag 12; E3D Online - JR; Designed by; Checked by; Approved by; Date; Edition; Sheet

Y-AXIS MOTOR MOUNT

ITEM | QTY | PART NUMBER | DESCRIPTION
3 | 4

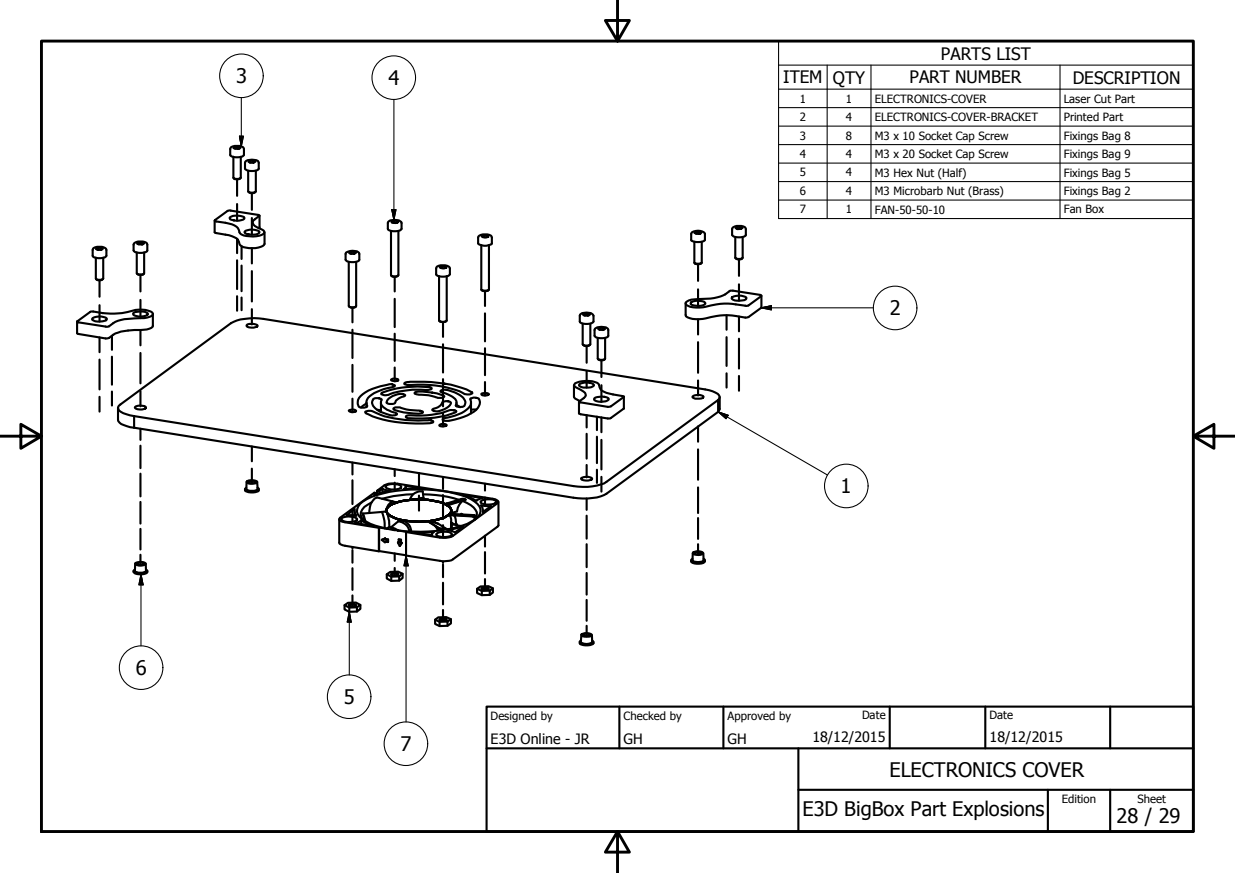
[picture p443: page 28]
ELECTRONICS-COVER; Laser Cut Part; ELECTRONICS-COVER-BRACKET; Printed Part; M3 x 10 Socket Cap Screw; Fixings Bag 8; M3 x 20 Socket Cap Screw; Fixings Bag 9; M3 Hex Nut (Half); Fixings Bag 5; M3 Microbarb Nut (Brass); Fixings Bag 2; FAN-50-50-10; Fan Box; E3D Online - JR; Designed by; Checked by; Approved by; Date; Edition; Sheet; ELECTRONICS COVER

ITEM | QTY | PART NUMBER | DESCRIPTION

1

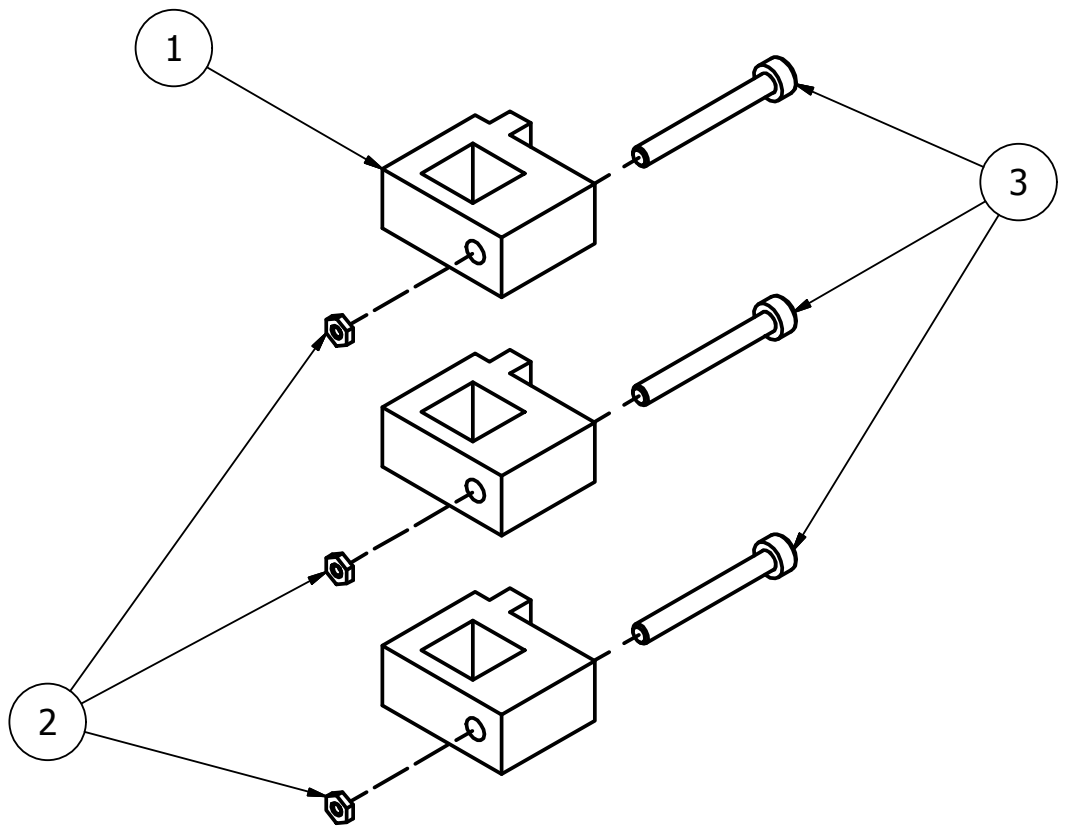
[picture p444: page 29]
RRB-CABLE-CONDUIT; Printed Part; M3 Hex Nut; Fixings Bag 3; M3 x 25 Socket Cap Screw; Fixings Bag 7; E3D Online - JR; Designed by; Checked by; Approved by; Date; Edition; Sheet

REAR-RIGHT-BACK CABLE CONDUIT
