jeottesen/e3d-big-box-manual-rebuild/docs/files/DC_Fans.pdf

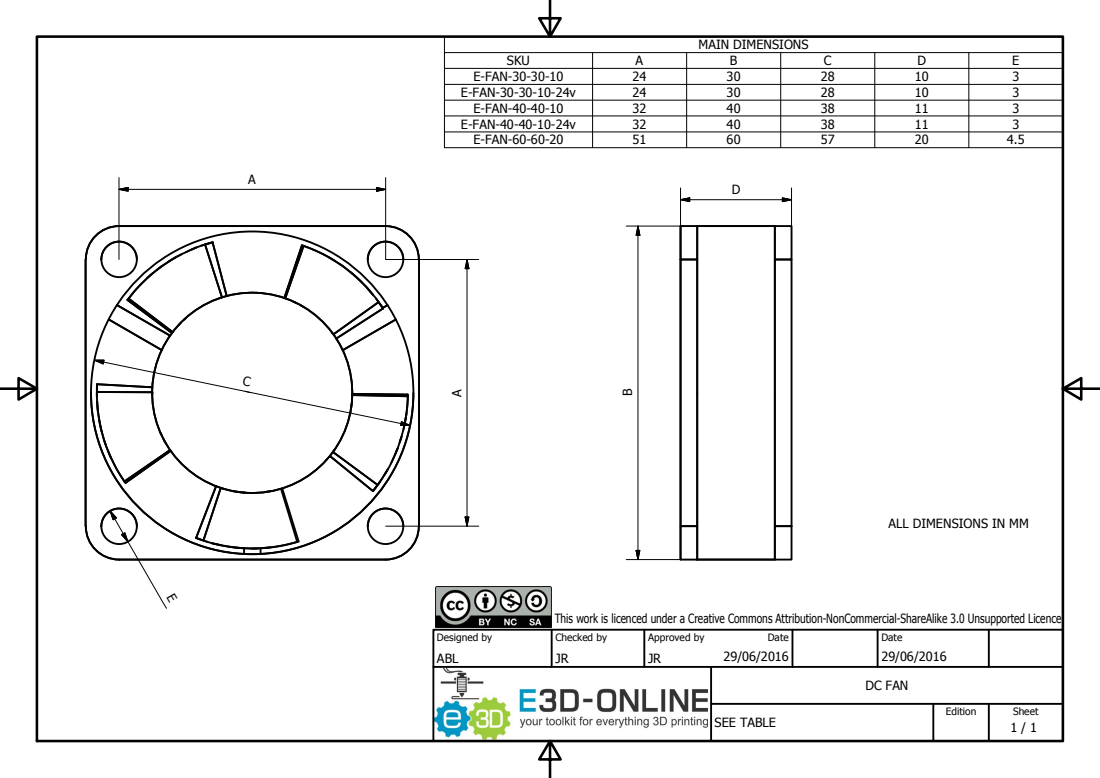
[picture p445: page 1]
DC FAN; SEE TABLE; ABL; Designed by; Checked by; Approved by; Date; Edition; Sheet; MAIN DIMENSIONS; SKU; E-FAN-30-30-10; E-FAN-30-30-10-24v; E-FAN-40-40-10; E-FAN-40-40-10-24v; E-FAN-60-60-20

ALL DIMENSIONS IN MM

This work is licenced under a Creative Commons Attribution-NonCommercial-ShareAlike 3.0 Unsupported Licence
