jeottesen/e3d-big-box-manual-rebuild/docs/files/E-MOTOR-NEMA17-ALL_PUBLIC.pdf

B ( 2 : 1 )

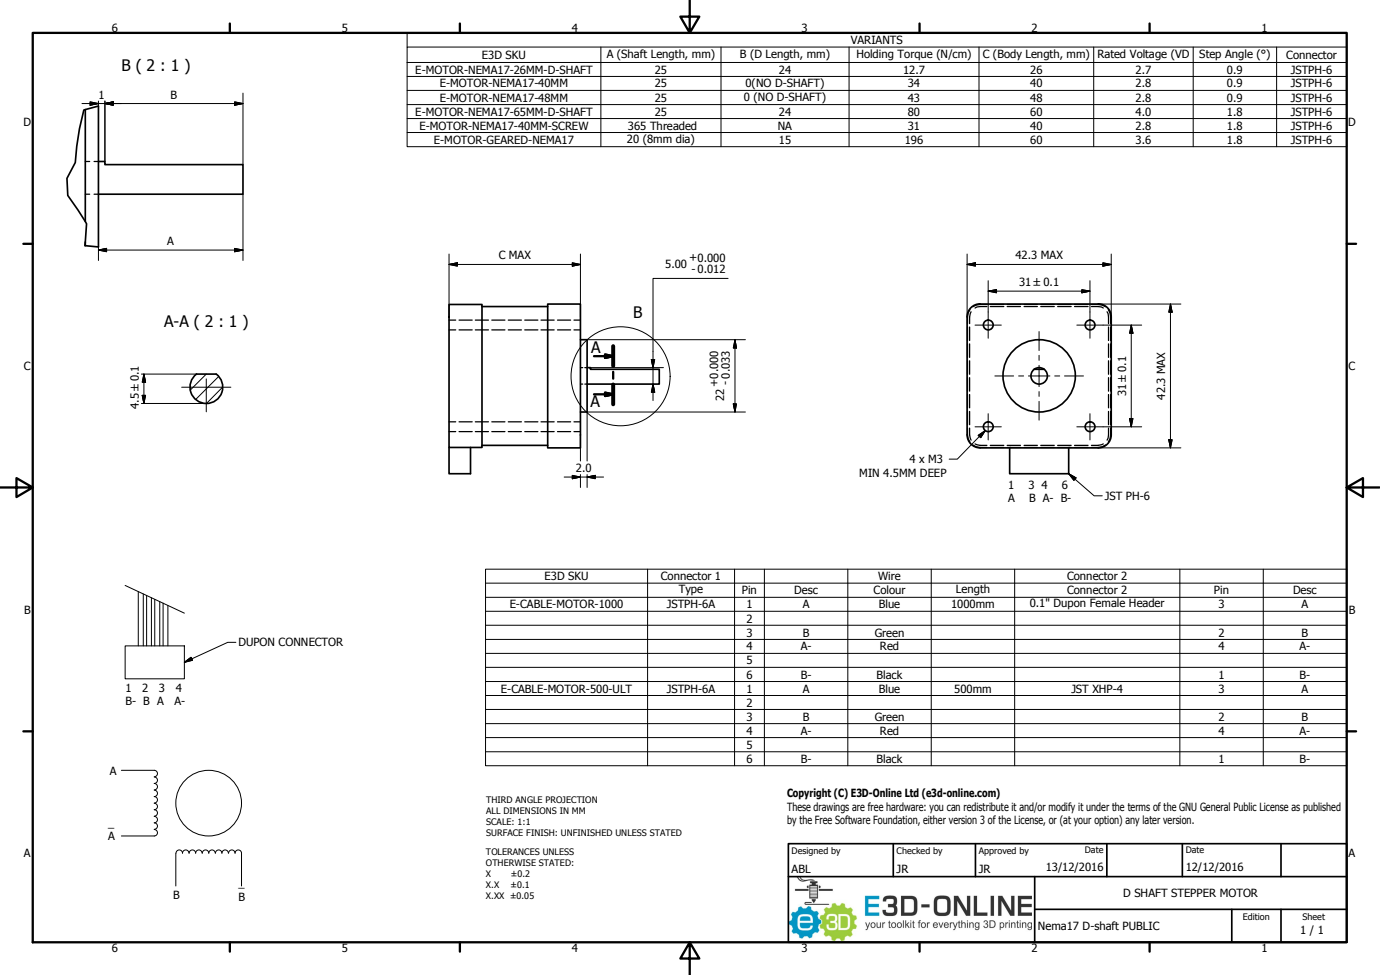
[picture p446: page 1]
Nema17 D-shaft PUBLIC; ABL; Designed by; Checked by; Approved by; Date; Edition; Sheet; 42.3 MAX; 4 x M3 MIN 4.5MM DEEP; C MAX; JST PH-6; TOLERANCES UNLESS OTHERWISE STATED:; E3D SKU; Connector 1; Wire; Connector 2; Type; Pin; Desc; Colour; Length; E-CABLE-MOTOR-1000; JSTPH-6A; Blue; 0.1" Dupon Female Header; Green; Red; Black; E-CABLE-MOTOR-500-ULT; JST XHP-4; DUPON CONNECTOR; VARIANTS; A (Shaft Length, mm); B (D Length, mm); Holding Torque (N/cm); C (Body Length, mm); Rated Voltage (VD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

Copyright (C) E3D-Online Ltd (e3d-online.com)
These drawings are free hardware: you can redistribute it and/or modify it under the terms of the GNU General Public License as published
by the Free Software Foundation, either version 3 of the License, or (at your option) any later version.

THIRD ANGLE PROJECTION
ALL DIMENSIONS IN MM
SCALE: 1:1
SURFACE FINISH: UNFINISHED UNLESS STATED

D SHAFT STEPPER MOTOR
