jeottesen/e3d-big-box-manual-rebuild/docs/files/V6-175-ASSM.pdf

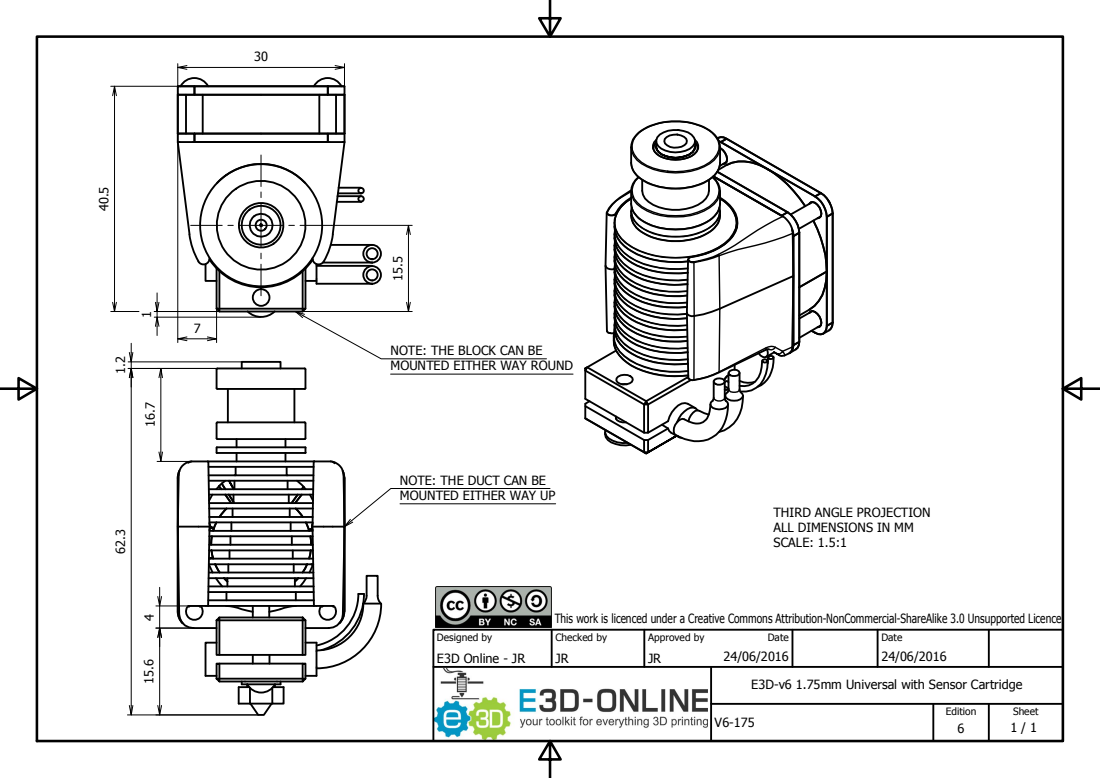
[picture p447: page 1]
E3D Online - JR; Designed by; Checked by; Approved by; Date; Edition; Sheet

NOTE: THE BLOCK CAN BE
MOUNTED EITHER WAY ROUND

NOTE: THE DUCT CAN BE
MOUNTED EITHER WAY UP

THIRD ANGLE PROJECTION
ALL DIMENSIONS IN MM
SCALE: 1.5:1

This work is licenced under a Creative Commons Attribution-NonCommercial-ShareAlike 3.0 Unsupported Licence

E3D-v6 1.75mm Universal with Sensor Cartridge
