jeottesen/e3d-big-box-manual-rebuild/docs/files/V6-NOZZLE-ALL.pdf

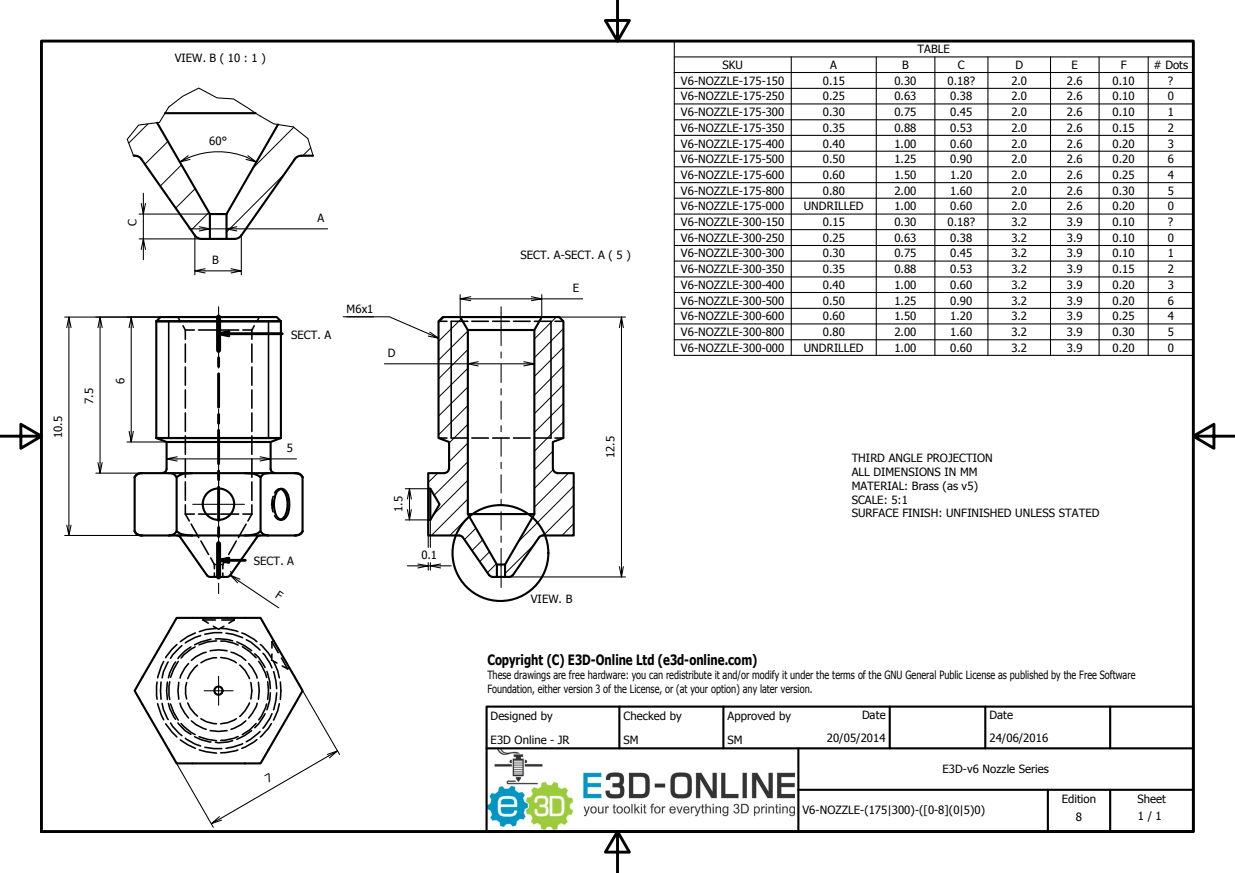
[picture p448: page 1]
SECT. A-SECT. A ( 5 ); VIEW. B ( 10 : 1 ); SECT. A; VIEW. B; E3D-v6 Nozzle Series; V6-NOZZLE-(175|300)-([0-8](0|5)0); E3D Online - JR; Designed by; Checked by; Approved by; Date; Edition; Sheet; TABLE; SKU; # Dots; V6-NOZZLE-175-150; V6-NOZZLE-175-250; V6-NOZZLE-175-300; V6-NOZZLE-175-350; V6-NOZZLE-175-400; V6-NOZZLE-175-500; V6-NOZZLE-175-600; V6-NOZZLE-175-800; V6-NOZZLE-175-000; UNDRILLED; V6-NOZZLE-300-150; V6-NOZZLE-300-250; V6-NOZZLE-300-300; V6-NOZZLE-300-350; V6-NOZZLE-300-400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

THIRD ANGLE PROJECTION
ALL DIMENSIONS IN MM
MATERIAL: Brass (as v5)
SCALE: 5:1
SURFACE FINISH: UNFINISHED UNLESS STATED

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
