jeottesen/e3d-big-box-manual-rebuild/(commit log)

2026-10-28 Fix page discovery and links, lint all Markdown
    - fetch.py skipped every title containing a colon, so real pages such as
    "Printer main assemblies: Step By Step Assembly Process" were never
    fetched. It now skips only wiki namespaces (File:, Special:, ...). The
    newly reachable pages are added, including the single and dual direct-
    drive printhead assembly pages.
    - links to pages the archive does not have are plain text instead of
    links to the archive
    - file names are safe on every OS (no colons)
    - rebuilt pages say "Rebuilt page" instead of "Archived recovered from",
    and the appendix and datasheets pages carry no source line
    - a capture that answers 404/410 every time is dead: it i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
2026-10-30 Link each page's header to the archive capture it came from
    The "Archived <timestamp>" line now ends with an archive link to the exact
    capture, using the URL form that capture was saved under. Rebuilt pages link
    to the parent page capture their text was cut from. All links were checked
    against the Wayback Machine's index.
2026-10-30 Fill in the Bill of Materials' Printed Parts and Fixings from the exploded drawings
    The wiki's Bill of Materials left Printed Parts empty and linked a fixings list
    that the archive does not have. The exploded drawings (EXPLODED_DRAWINGS.pdf)
    carry a parts list on every sheet, and the PDF has a real text layer, so
    scripts/drawings.py reads them directly, with no OCR, into notes/parts.json.
    The build then adds a Printed Parts table and a fixings table (totals by bag,
    with the sheets each is used on), each row linked to its page of the archived
    PDF and, where the sheet title clearly matches, to the build section.
    26 of the 29 sheets are read and each table is checked against the plain-text
    row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
2026-10-30 Add mise tasks and requirements, and read the image-only drawing sheets by OCR
    - mise.toml pins the tools (python, uv, pandoc, node, markdownlint-cli2) and defines
    the tasks: deps, fetch, extract, site, markdown, check and build. requirements.in
    and the compiled requirements.txt cover the packages the two drawing scripts need;
    mise installs them into .venv.
    - scripts/drawing_images.py reads the parts list off the drawing sheets that the wiki
    embedded as images, by OCR (rapidocr). Sheets that match a PDF sheet are read from the
    PDF instead; the rest (the hybrid and dual extruders, the Z-axis brackets and drag
    chain, the spool-holder clamp, the dock bracket) are added to the Printe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
2026-10-30 Normalise OCR text, draw missing drawing images from the PDF, add an OCR review
    - drawing_images.py corrects 'Fixings Bag' misreads by pattern and other names against
    the PDF's exact strings (keeping what the OCR read), and a row is only flagged for
    review when it is still unrecognised. A missing item number no longer counts.
    - render_sheets.py draws PDF sheets 4, 7, 12 and 13 as images for the drawing images the
    archive did not keep (Extruder Idler, X-Carriage Single, Print Fan Duct, IR Sensor
    Assembly). The build uses them in place of the placeholder and says where they come from.
    - notes/OCR_REVIEW.md lists the rows to check and the automatic corrections.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
2026-10-30 Match the wiki's drawing images to the PDF sheets and link the BoM to the images
    - scripts/match_sheets.py works out which wiki drawing image is which sheet of the exploded
    drawings PDF, checking the drawing itself, the title and the parts list, and writes
    notes/sheet_matches.json: 22 confirmed, 1 to check (HEATED_BED_CORNERS), 9 with no sheet
    in the PDF (a newer revision). Low-resolution images that are the same drawing are marked
    for redrawing.
    - render_sheets.py draws those from the PDF at 1600 px (Extruder Single, Rear-Right-Back
    Cable Conduit) along with the four drawings the archive lost. The build uses them and
    says so under the image.
    - The Bill of Materials rows now link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
2026-10-30 Enlarge the low-resolution dual extruder drawing, make the OCR review script-written, fix OCR names
    - Heated bed corners is the same drawing as PDF sheet 9 (another angle): recorded as a manual
    match, never redrawn.
    - Image-only sheets confirmed as PDF sheets no longer feed the Bill of Materials from the
    OCR (it would duplicate the PDF's rows); the PDF renders of lost images are not OCR'd.
    - Wiki drawing images under 1200 px with no PDF sheet (EXTRUDER_DUAL, 800 px) are enlarged to
    twice the size; the original is kept in docs/images/original/ and linked from a note.
    - notes/OCR_REVIEW.md is now written by drawing_images.py, so it cannot go stale, and lists
    only the sheets the OCR act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
2026-10-30 Add tests, ruff and a (disabled) CI workflow; fix the matcher's row comparison and the task inputs
    - tests/ (standard library only, read the committed data): the OCR text rules never change a
    number, the matcher's decision, invariants on parts.json / parts_images.json /
    sheet_matches.json, and the built Bill of Materials (no repeated rows, every row has a drawing
    that exists, every build-section link lands on a heading). They fail if anything is left
    unchecked after an extraction.
    - The pure logic moved to scripts/ocr_text.py and scripts/match_logic.py so the tests can
    import it without the venv.
    - match_sheets.py compared an image's parts with the sheet it looked most like, not th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
2026-10-30 Switch the check workflow back to manual start
    No runner can take it yet: GitHub-hosted runners need Actions credit, and the ARC
    runner set is registered to a different repository.
2026-10-30 Take build sections from where the manual shows each drawing; M3 hex nut
    - The manual is the source of truth for which step a drawing belongs to. The Printed Parts
    table's Build section column now comes from the heading each sheet's drawing is embedded
    under (embedded_sections in build.py), and a drawing shown in several steps links all of
    them. The SHEET_SECTIONS and IMAGE_SECTIONS hand tables are gone. This fixes the Z-axis
    drag chain (step 18, not the sub-assembly its name suggested) and maps the sheets that had
    no link. A sheet whose drawing the manual never shows (PDF sheet 22) gets no link, not a guess.
    - A drawing above a sub-page's first heading links to the page itself.
    -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
2026-10-30 Correct the note on the M3 hex nut hand fix: the drawing itself says M2
2026-10-30 Make reviewed per-sheet data the source of truth; the tools only propose
    From the independent review (items 5 and 6):
    - data/sheets/*.json: the reviewed parts list of each drawing sheet (26 PDF sheets read from the
    PDF's text, 8 image-only sheets read by OCR and confirmed by the maintainer). Each row records
    how it got its text (pdf-text, ocr, ocr+fix, hand) and keeps what the tool read when it was
    corrected. data/README.md describes the schema.
    - The build reads only data/sheets/. The Bill of Materials comes out the same, apart from the
    note's wording.
    - The extractors (drawings.py, drawing_images.py, match_sheets.py) write proposals to
    work/proposed/ (git-ignored) and never writ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
2026-10-30 Commit the drawn and enlarged images and keep every replaced wiki image
    From the independent review (item 7):
    - render_sheets.py writes the images the reviewed data calls for straight into docs/images/ and
    keeps the wiki's own image of a redrawn or enlarged drawing in docs/images/original/ first
    (EXTRUDER_SINGLE and REAR-RIGHT-BACK_CABLE_CONDUIT are new there). An unchanged image is not
    rewritten.
    - build.py uses the committed image and links the wiki's original from the note under it, so
    the build no longer reads a git-ignored rendered/ folder and no longer needs the venv:
    `mise run build` is stdlib, pandoc and markdownlint only. docs/images stops feeding itself
    because the ori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
2026-10-31 Add the frame nut trap to the printed parts
    FRAME-LUG_DRAWING.jpg has no parts list, so the row is entered by hand: the title block names the
    part (BB_FRAME_M3_NUT_TRAP-1) and the manual's step (13.1) A Note on Nut-Traps, where the drawing
    is shown, says approximately 150 are used in the frame. The Bill of Materials shows it as ~150
    and links the drawing and that step.
    - data/sheets/img-FRAME-LUG_DRAWING.json, with a new row kind "entered" (typed by a person, with
    a basis) and an "approx" flag for a quantity the manual gives as approximate.
    - The build uses a sheet unless it holds machine-read rows nobody has confirmed; the drift report
    does not call an all-entered sheet missing.
    - Test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
2026-10-31 Add the Exploded Drawings page: every assembly drawing in one place
    The exploded drawings PDF does not have them all: the wiki's newer drawings add the hybrid and dual
    extruders, the Z axis, the spool-holder clamp and more. The new generated page has one entry per
    sheet in the reviewed data (35): the drawing, its parts list, the steps of the manual that show it
    and its page in the PDF.
    - Entries follow the manual: parts preparation first, then the sub-assemblies, then the
    step-by-step assembly, then the drawings only other pages show, and last any the manual does not
    show at all. A drawing shown in several steps is listed once and links them all.
    - PDF sheet 22 (X-CARRIAGE ASSEMBLY) had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
2026-10-31 Link the Exploded Drawings page from the main manual page, in an Appendix
    The main page linked none of the generated pages. It now ends with a short Appendix (and an entry
    in its contents list) linking the Exploded Drawings page and the Bill of Materials. Nothing else on
    the main page changes. A test checks the links and the contents entry.
2026-10-31 Rename Appendix Older Version Content to Older Version Content; list every extra page in the Appendix
    - The page is now Older_Version_Content. appendix.py writes it under the new name and removes the old
    page from a data folder built earlier, so the two cannot both be built. The page keys in
    notes/provenance and notes/link-status.json, the section mapping and the link report follow the
    rename; the old generated files are gone.
    - The main page's Appendix now lists Exploded Drawings, Bill of Materials, Datasheets, Downloads and
    Older Version Content (each with a one-line description). A test checks all five links.
2026-10-31 Add the printed parts that have no drawing to the Bill of Materials
    The manual's step lists name printed parts that no exploded drawing covers: for example "2 x Drive
    Supports (Printed Parts)" in (10) Z-Axis Bed Assembly. The Bill of Materials left them out.
    - scripts/manual_parts.py (standard library only) finds every "N x NAME (Printed Part...)" item in
    the built manual: 22 items. data/manual_parts.json is the reviewed list: 8 are covered by a
    drawing (the Dock, Spool Inner Brackets, Belt Tensioner, Right Cable Bracket and the Z-bed parts);
    14 distinct parts have none: the Hybrid X-Carriage and its two bearing clamps, Drive Supports,
    Printed Feet, Z-Axis Driver Bottoms and Tops, C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
2026-10-31 Use the manual's quantities, one name per part, a clearer heading; keep the matching in targets.py
    From the maintainer's review of the printed parts:
    - The Bill of Materials shows the quantity the manual's step uses where a drawing shows one part
    that applies to several places: the Z-bed Top Bottoms, Tops and Caps are 4 each (one of four
    corners is drawn) and the Spool Inner Brackets are 2.
    - One name per part: for a part a drawing shows, the drawing's name (not also the manual's).
    - Bag items stay in the table, labelled "from the Printed Parts Bag" (box items "from the Printed
    Parts Box"), and the heading is now "Printed Parts, Printed Parts Box and Printed Parts Bag".
    - The reviewed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
2026-11-01 Spool Inner Brackets are not the SPOOL-HOLDER INNER drawing
    The maintainer compared them: they look different, so they are different parts. The manual's
    Spool Inner Brackets (2, step 17.2) now have no drawing and are listed that way; SPOOL-HOLDER INNER
    goes back to the drawing's quantity of 1. The other six matches (right cable bracket, dock, and the
    three Z-bed parts) are confirmed against the drawings.
2026-11-01 Record that the belt tensioner match is confirmed too
2026-11-02 Keep the old Titan extruder steps, fix the Non-Titan link, add a scan for suspicious sections
    Section (21.1) used to hold the Titan bracket, nut, motor and lid steps until
    June 2016, when they were cut down to a link. They are now kept in the
    Older Version Content appendix. The (21.2) link carried the wiki's piped-link
    typo in its anchor and stray brackets; it now points at Sub-assemblies (5).
    scripts/suspicious.py reports malformed links, thin sections and sections that
    shrank since an older version.
2026-11-02 Rebuild the two non-hybrid X-Carriage pages the main page links to
    Sections (6) and (7) of the Step By Step page say 'older Non-Hybrid ... | Click Here',
    but the pages they named were never archived, so Click Here was plain text. Their steps
    are still in older versions of that page, so rebuild them from there like the other
    missing pages. The Bill of Materials test now skips 'no drawing' rows, which link the
    step that lists the part.
2026-11-02 Add the handoff note for putting the printed parts' STEP files in the manual
    The work has not started. It waits for the pull request that fixes the
    suspicious links and sections.
2026-11-02 Fix the last two typed links, rename the dual bearing clamp row
    The empty OctoPrint 'Continue to the [[]]' line is dropped, and the hand-typed
    Base Assembly reference in step (24) becomes a link to Sub-assemblies (12). The
    dual carriage's Bearing Clamps row goes by X-AXIS CARRIAGE BEARING CLAMP DUAL.
2026-11-02 Add the printed parts' STEP files and link them from the Bill of Materials
    downloads/printed-parts/ holds the 72 STEP files with parts.csv and SHA256SUMS.
    scripts/printed_parts.py matches each file to a Bill of Materials row by name; the
    build adds a STEP column (alternates for the newer screw and mirrored (R) parts on
    the row of their standard part) and lists the 15 files that have no row, each with the
    step the manual puts it in. The Downloads page lists the original CAD files the parts
    were cut from. The test that their sources and licence are recorded fails until they are.
    [BB-FRAME-M3-NUT-TRAP-1.step, Bottom-Camera-Bracket.step, Camera-Arm.step, Camera-Mount.step, DOCK-BRACKET.step, Drag-Anchor-Bracket.step, Drive-Supports.step, Dual-Dump-Bucket.step]
2026-11-02 Record the STEP files' source and licence (CC BY-SA 3.0, Bigbox3DP on Thingiverse)
    The parts are adapted from the BigBox design files on Thingiverse (thing 1521722),
    which are CC BY-SA 3.0 (the archived page of 2016-12-04 says so). The folder has
    its own README with the attribution and the changes made, NOTICE.md says the files
    are not covered by the repository's CC BY 3.0, and the Downloads page lists the
    sources.
    [parts.csv]
2026-11-03 One printed parts table, a separate table for what is not printed
    The 15 STEP files with no Bill of Materials row are rows of the printed parts table
    (no quantity, the step the manual puts them in). Cork pads, the spring, the coupler and
    the hobbed gear, which come in the Printed Parts Box or Bag but are not printed, move to
    their own table. Main Block goes by Non-Titan Direct-Drive Bowden Main Block. The parts
    with no STEP file (that one and IEC Back Cover) have a blank STEP cell.
2026-11-03 Drop the Source column from the printed parts, shorten the STEP note, keep the licence in NOTICE.md
    The printed parts table has no Source column (every row is printed) and the wiki's own
    Printed Parts heading. What is not printed has its own table, which says which box or bag
    each part comes in. The note over the table says only where the STEP files come from; the
    licence is in NOTICE.md and the folder's README, not on the pages.
2026-11-03 Call the table of parts that are not printed Not Printed
2026-11-03 End the printed parts note at the link to all the drawings
2026-11-03 Merge E3D's own fixings list into the Fixings table
    data/bom.ods (the Bill of Materials spreadsheet from the BigBox Thingiverse page) lists
    the 48 fixings of the kit by bag with the quantity required and supplied. The table now
    lists all of them, with the drawings that show each, and keeps the one fixing only the
    drawings show. Where a drawing gives another bag than the list, the list's bag is shown.
    [bom.ods]
2026-11-03 Add the General sheet, trust E3D's fixings list over OCR, fix Knurled
    The Not Printed table becomes General: every row of the General sheet of data/bom.ods,
    with the cork parts, coupler, spring and hobbed gear fitted to the sheet's rows under the
    sheet's names and the build sections kept. The Fixings table lists only the sheet's
    fixings (the drawings' M3 Hex Nut, which the sheet does not have, is dropped), and
    the sheet's 'Knruled' is spelled Knurled.
2026-11-03 Tie six more General components to their steps
    Link, the 30x30x10 hotend fan, the 40nm NEMA 17, the TR8 nut, the 325mm rod and the
    77mm Viton strip, from a search of the manual that the maintainer checked. The adhesive
    sheet, the cork insulation and the fixings kit have no step the manual names.
2026-11-03 Treat the drawing's 30x30x30 fan as the 30x30x10 hotend fan
2026-11-03 Correct the 30x30x30 fan on sheet 26 to the 30x30x10 hotend fan
    The exploded drawings PDF prints 30x30x30; there is no such fan in the build. The row is
    a hand fix that keeps the PDF's text in read_as, and the hand-corrections table now
    applies to PDF rows too, so drift does not report it again.
