jeottesen/e3d-big-box-manual-rebuild/(notices)

Notices in the files:
downloads/printed-parts/parts.csv:
github.com/jeottesen/e3d-big-box-manual-rebuild/blob/main/manual/BigBox_Printer_Sub-assemblies.md#131-a-note-on-nut-traps,,,,BB_FRAME_M3_NUT_TRAP.stp,BB_FRAME_M3_NUT_TRAP/g000,11.0 x 8.1 x 7.6,353,CC BY-SA 3.0,False,True,a371f3552f8ac2a917ddadea19b06e5629b5b404430a606cc22ba27669481897
_assemblies_Step_By_Step_Assembly_Process.md#22-octoprint-upgrade-camera-install,regular,,,bigbox_v1.1.0.stp,bigbox_v1.1.0/g028,42.6 x 9.0 x 9.0,2051,CC BY-SA 3.0,False,True,dbbf3e4ed094f13fe13a1dc60dc9d1846357892782c8dc1c1850285f69d780bc
assemblies_Step_By_Step_Assembly_Process.md#22-octoprint-upgrade-camera-install,regular,,,bigbox_v1.1.0.stp,bigbox_v1.1.0/g007,36.2 x 25.0 x 8.5,3796,CC BY-SA 3.0,False,True,a7e937fe31809a2b3223f996664214d9d326e01c359530806784a0ff91261e19
p_By_Step_Assembly_Process.md#22-octoprint-upgrade-camera-install,regular,,Camera holder,bigbox_v1.1.0.stp,bigbox_v1.1.0/g027,61.9 x 33.5 x 11.0,8160,CC BY-SA 3.0,False,True,39664945ac8bf790c2497e8b66093dfa2228a06f49bcde90586c7850b1ce69ed
github.com/jeottesen/e3d-big-box-manual-rebuild/blob/main/manual/Printer_main_assemblies_Step_By_Step_Assembly_Process.md#14-frame-top,regular,,,bigbox_v1.1.0.stp,bigbox_v1.1.0/g034,141.2 x 43.5 x 14.0,19729,CC BY-SA 3.0,False,True,5f5137f0dd04ec7c66add2017b39a2aba59ef1b538611b3534513197886fc38b
/Printer_main_assemblies_Step_By_Step_Assembly_Process.md#13-x-axis-drag-chain,regular,,,bigbox_v1.1.0.stp,bigbox_v1.1.0/g023,31.5 x 26.0 x 14.5,6991,CC BY-SA 3.0,False,True,947dbeebab309fae8eb48c7c4fb80e87a38c6f3595a41fe94af6b69c4ae5421d
github.com/jeottesen/e3d-big-box-manual-rebuild/blob/main/manual/BigBox_Printer_Sub-assemblies.md#10-z-axis-bed-assembly,regular,,,bigbox_v1.1.0.stp,bigbox_v1.1.0/g045,50.5 x 35.0 x 23.2,13572,CC BY-SA 3.0,False,True,b04eff8009a04bc42cbcafa2ae2766605dc026c1ea27caf4543ad6b4bc90ac14
assemblies_Step_By_Step_Assembly_Process.md#31-ooze-wiper--dump-bucket,dual,,,bigbox_dual_v1.0.0.stp,bigbox_dual_v1.0.0/g004,78.0 x 60.7 x 50.0,44021,CC BY-SA 3.0,False,True,bddd191af1e741b3754af32d1ca612bfdc0dbc9b7a10ac488c5a55428565b2ce
_assemblies_Step_By_Step_Assembly_Process.md#31-ooze-wiper--dump-bucket,dual,,,bigbox_dual_v1.0.0.stp,bigbox_dual_v1.0.0/g000,76.0 x 42.4 x 12.0,9398,CC BY-SA 3.0,False,True,aa0072d1b46ea1467dc4ce8a80fcc58375dac1575d723b6d8ed504607a173e0d
r_main_assemblies_Step_By_Step_Assembly_Process.md#31-ooze-wiper--dump-bucket,regular,,,bigbox_v1.1.0.stp,bigbox_v1.1.0/g033,60.7 x 50.0 x 44.0,31589,CC BY-SA 3.0,False,True,16da1b3946765bffb823473607dc17aa04a84c6bb756e7b2a1702078c62d98f8
github.com/jeottesen/e3d-big-box-manual-rebuild/blob/main/manual/Dual_Direct-Drive_Extruders.md#dual-direct-drive-extruders,dual,,,bigbox_dual_v1.0.0.stp,bigbox_dual_v1.0.0/g002b,74.3 x 59.0 x 27.6,17030,CC BY-SA 3.0,False,True,7fc53b025d3587d7e0ea964df42112ef581ff61df140bf0ed6dd50276f0e9444
x_Printer_Sub-assemblies.md#5-hybrid-non-titan-extruder-direct,hybrid,,broken thumbnail,Hybrid_v1.1.0.stp,Hybrid_v1.1.0/g003,74.2 x 67.7 x 51.1,56237,CC BY-SA 3.0,False,True,08b07b1ddc2648495b5b42c2a7db95434316f49f4b6902c7e879be0d4035746b
github.com/jeottesen/e3d-big-box-manual-rebuild/blob/main/manual/BigBox_Printer_Sub-assemblies.md#5-hybrid-non-titan-extruder-direct,hybrid,,,Hybrid_v1.1.0.stp,Hybrid_v1.1.0/g005,42.0 x 30.8 x 25.6,7390,CC BY-SA 3.0,False,True,9927c90d32afa1c2d128b79118a46312f171a26134629e35b9ccb1350b42e302
github.com/jeottesen/e3d-big-box-manual-rebuild/blob/main/manual/BigBox_Printer_Sub-assemblies.md#5-hybrid-non-titan-extruder-direct,hybrid,,,Hybrid_v1.1.0.stp,Hybrid_v1.1.0/g004,46.3 x 25.0 x 24.0,8775,CC BY-SA 3.0,False,True,cd0e845d320655b49f21cbe6165300370868f3c1d3817c298cedeaf7644e64fa
github.com/jeottesen/e3d-big-box-manual-rebuild/blob/main/manual/BigBox_Printer_Sub-assemblies.md#5-hybrid-non-titan-extruder-direct,hybrid,,,Hybrid_v1.1.0.stp,Hybrid_v1.1.0/g000,71.3 x 68.3 x 51.5,40664,CC BY-SA 3.0,False,True,67f6914424c858af7822c126ff2af4381b1eb09dd3d48720f7b5c80ae1c89053
github.com/jeottesen/e3d-big-box-manual-rebuild/blob/main/manual/Non-Titan_Idler_Arms.md#non-titan-idler-arms,regular,,,bigbox_v1.1.0.stp,bigbox_v1.1.0/g021,46.3 x 25.0 x 14.0,7280,CC BY-SA 3.0,False,True,ca78dcabccbb71bbd088acd617f4382f326aa6a8dddcd35d8a57c3523fb8f4f6
github.com/jeottesen/e3d-big-box-manual-rebuild/blob/main/manual/BigBox_Printer_Sub-assemblies.md#8-electronics-cover,regular,,,bigbox_v1.1.0.stp,bigbox_v1.1.0/g008,31.2 x 18.5 x 5.0,1387,CC BY-SA 3.0,False,True,139512ea725d00bd2d5954e0a1962b5f7141107229c0c13557dd782c58e9eb32
github.com/jeottesen/e3d-big-box-manual-rebuild/blob/main/manual/BigBox_Parts_Preparation.md#13-print-cooling-fan-v10,hybrid,,,Hybrid_v1.1.0.stp,Hybrid_v1.1.0/g014,70.5 x 60.5 x 23.8,12960,CC BY-SA 3.0,False,True,de4886b80345ba89e4ae60ee3457bc4ae3a26cf683046347e3cc14770e7c95f1
assemblies_Step_By_Step_Assembly_Process.md#22-octoprint-upgrade-camera-install,regular,,,bigbox_v1.1.0.stp,bigbox_v1.1.0/g011,30.0 x 24.4 x 4.1,1277,CC BY-SA 3.0,False,True,d03dd6535fe1f55e3ed8d198f668eb3da55c9d1b44df914aed0a512c068b1c17
github.com/jeottesen/e3d-big-box-manual-rebuild/blob/main/manual/BigBox_Parts_Preparation.md#10-heated-bed-corners,regular,,,bigbox_v1.1.0.stp,bigbox_v1.1.0/g044,32.5 x 32.4 x 23.0,9970,CC BY-SA 3.0,False,True,0c32160d4774fb6439e0248ec281025450921dde3b0b64856cb4cec577a66916
github.com/jeottesen/e3d-big-box-manual-rebuild/blob/main/manual/BigBox_Parts_Preparation.md#16-hybrid-ir-sensor-bracket,hybrid,,,Hybrid_v1.1.0.stp,Hybrid_v1.1.0/g008,66.9 x 33.5 x 11.8,8766,CC BY-SA 3.0,False,True,428cc5422cca92d97efc7adc92e64a4d3d1890e34202784e174d274abb2b0681
er_main_assemblies_Step_By_Step_Assembly_Process.md#31-ooze-wiper--dump-bucket,hybrid,,,Hybrid_v1.1.0.stp,Hybrid_v1.1.0/g009,77.0 x 50.4 x 20.8,14553,CC BY-SA 3.0,False,True,f176105abb3869ce6d1fd122388b0a70b142fbd25e5533a966f85270eb7fad96
